bigtreetech/Manta-M8P/README.md

# [切换到中文版](./README_zh_cn.md)
# [日本語版はこちら](./README_ja_jp.md)

# Note
## We're BIGTREETECH! For Makers, by makers!
* We appreciate all of your support! To offer an excellent experience to every maker, we constantly strive to design, manufacture and produce high quality parts and documentation!
* For resources on the V1.0 and V1.1 M8P boards please consult the relevant manual available in this repo or the wiki here: https://bttwiki.com/M8P.html
* For resources on the V2.0 board, please consult the relevant manual available in this repo.

## How to contact:
### If you have any technical issue, please don’t hesitate contact us:
* BIGTREETECH: service004@biqu3d.com

### Follow us on social media to get more news:
* Facebook: https://www.facebook.com/BIGTREETECH/
* Twitter: https://twitter.com/BigTreeTech
* Instagram: https://www.instagram.com/bigtreetech_official/
* Official Site: https://bigtree-tech.com/

## Purchase link:
* M4P/M8P/CB1: https://www.biqu.equipment/collections/control-board/products/manta-m4p-m8p
