bigtreetech/Manta-M8P/V1.0_V1.1/Hardware/BIGTREETECH MANTA M8P V1.1 PinOut.png

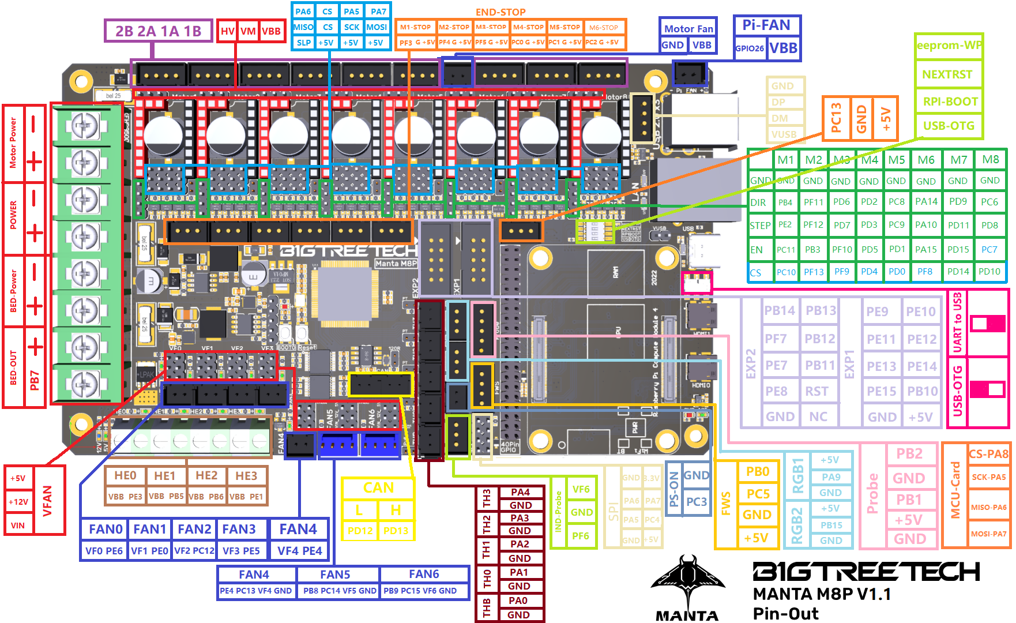
V1.0_V1.1/Hardware/BIGTREETECH MANTA M8P V1.1 PinOut.png
