bigtreetech/Manta-M8P/V2.0/Hardware/BIGTREETECH MANTA M8P V2.0 PinOut.png

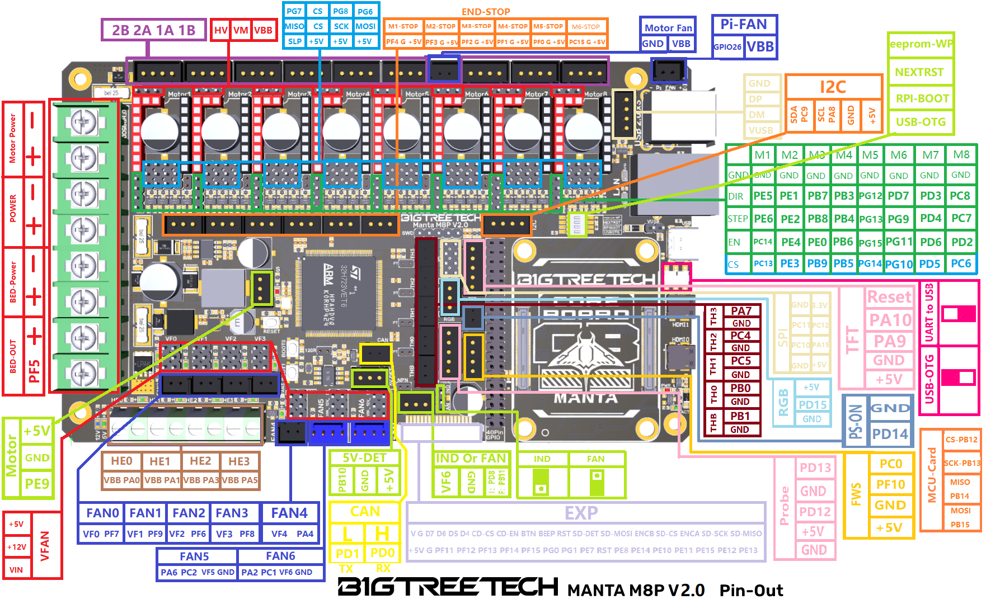
V2.0/Hardware/BIGTREETECH MANTA M8P V2.0 PinOut.png
