bigtreetech/Manta-M8P/V2.0/Hardware/M8P V2.0-connect.png

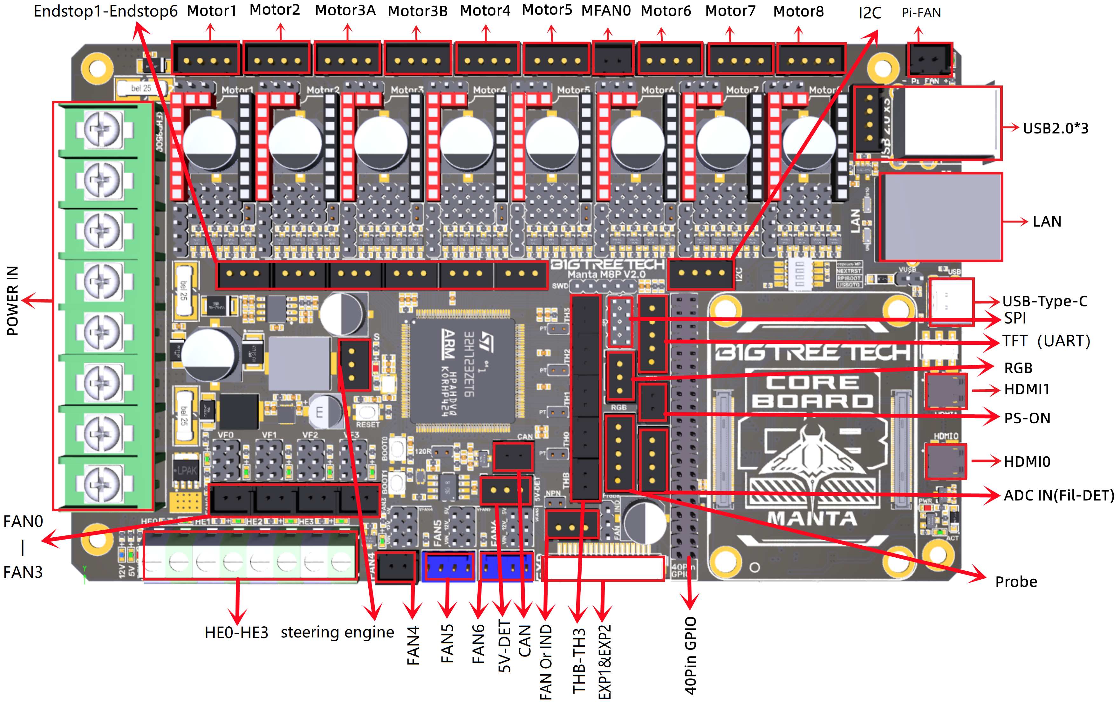
V2.0/Hardware/M8P V2.0-connect.png
