bigtreetech/Manta-M8P/V1.0_V1.1/3D/DIN Clips.STL

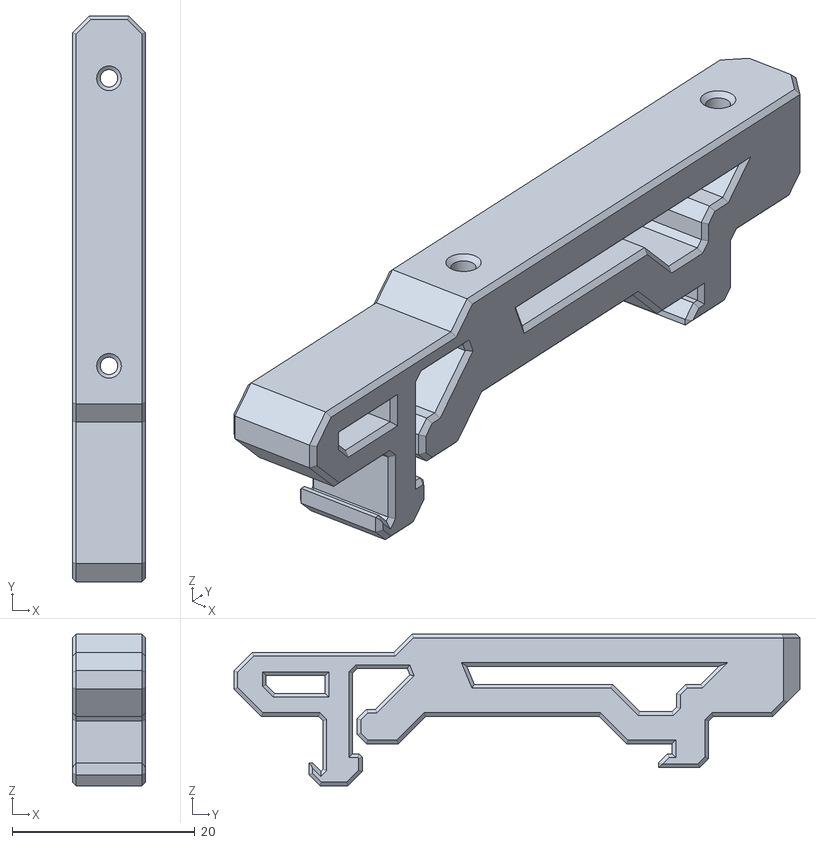
[picture p6: CAD file, 2022-07-22]
V1.0_V1.1/3D/DIN Clips.STL
8.00 x 62.0 x 16.6
