bigtreetech/Manta-M8P/(list of files, cad)

Other CAD files:
V1.0_V1.1/3D/M8P_Voron2.4_Mounting bracket.STEP
V1.0_V1.1/3D/BIGTREETECH MANTA M8P V1.0.step
V1.0_V1.1/3D/M8P_Voron2.4_Mounting bracket.STL
