bigtreetech/Manta-M8P/(threads)

Thread 1 (2022-07-31):

schematic diagram of Manta-M8P

mink007, 2022-07-31:
I am looking for schematic diagram of Manta-M8P.
Thank you.

TheRevenantStar, 2022-08-14:
Schematics are in the [manual](https://github.com/bigtreetech/Manta-M8P/blob/master/BIGTREETECH%20MANTA%20M8P%20V1.0%20User%20Manual.pdf)

Fisheiyy, 2022-09-05:
> Schematics are in the [manual](https://github.com/bigtreetech/Manta-M8P/blob/master/BIGTREETECH%20MANTA%20M8P%20V1.0%20User%20Manual.pdf)

no, they arent, thats a pinout, not a schematic

PeterHouseJr, 2022-09-10:
Is there a schematic available?

The power connections are not well explained in the preliminary manual and I would like to verify connections on the schematic before applying power.

Specifically: do I need to connect the 'Motor Power' and 'Bed Power' in addition to the 'POWER' connections.  It looks like the eight motor drivers are each jumpered to use the 'POWER' connection.  The bed power also seems to be connected to the 'POWER' connections.  If I want to power the bed separately, how much voltage and power can I use and can it me AC or do I need a separate driver for an AC powered bed heater?

A schematic should answer all of these questions.

Fisheiyy, 2022-09-12:
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

the Motor Power connection is for 48V is you want to run TMC5160 Pro/HV Drivers, they are jumpered by default to run on the 24V In from the normal POWER connection, the Bed Power connection is for 24V in so its not stressing the main POWER connection with so much current, So you need to connect the Bed Power connection if you want to use a Bed, it is DC only and up to a certain amount of current at 24V I think it is 15A, You would need an external AC Driver for an AC Bed.

PeterHouseJr, 2022-09-12:
@Fisheiyy Thank you so much for your very informative response.  On my Manta8P, the 'Bed Power In' and the 'Main Power In' are connected.  There are three small fuses on the board, each rated for 15A.  Their positioning suggest they are for the three power inputs.  I do not see a jumper anywhere to disconnect the 'Bed Power In' from the 'Main Power In'.  I am about to power up the Manta to drive some small test steppers and will post if I find anything different.

For the record: I would still like to see a schematic.

Fisheiyy, 2022-09-12:
> @Fisheiyy Thank you so much for your very informative response.  On my Manta8P, the 'Bed Power In' and the 'Main Power In' are connected.  There are three small fuses on the board, each rated for 15A.  Their positioning suggest they are for the three power inputs.  I do not see a jumper anywhere to disconnect the 'Bed Power In' from the 'Main Power In'.  I am about to power up the Manta to drive some small test steppers and will post if I find anything different.
>
> For the record: I would still like to see a schematic.

So would we all, The bed power is already seperate from the main power, you use a jumper to change the drivers from main power 24V to motor power which is meant for 48V

PeterHouseJr, 2022-09-13:
@Fisheiyy
On my board, M8P, the Bed Power and the POWER connections are connected.  I don't see an easy way to disconnect them if I wanted to, which I do not at this time.  I am thinking about an AC high power bed for quicker heating but am worried about the high voltage and the quick heating causing temperature gradients.

thisiskeithb, 2022-10-30:
Schematic has been uploaded: https://github.com/bigtreetech/Manta-M8P/blob/master/Hardware/BIGTREETECH%20MANTA%20M8P%20V1.0-SCH.pdf

emersonsc, 2022-11-23:
@mink007 could you marked this as closed to clean up the issues area. Thank you

Alex-LR, 2023-12-10:
Schematic was removed, so no schematics again!

Closed 2022-11-23.

Thread 2 (2022-08-01):

Dual Filament Runout Sensors

S1L3NTANG3L, 2022-08-01:
Is there a way to connect two SFS filament run out sensors to the board?

clevelandcs, 2022-10-21:
@S1L3NTANG3L Depends on how much other hardware you need to run. There is only the one dedicated port for their SFS sensor but if you don't need 6 motor endstops (which I'm impressed if you do) you could probably re-terminate the cable for the second SFS to use one of the endstops and just a signal pin from another end stop or other input pin you're not using elsewhere on the board. The pinout diagram in the Hardware folder should be able to put you down the right path.

emersonsc, 2022-11-23:
Really any available I/O pin can be used as @clevelandcs mention. You'll just have to remove the wires from the plug, put the 5v, GRD, and first signal pin into a 3 pin plug for the one available endstop, and the single 2nd signal pin go to the other open endstop. This how ever will ONLY work if you arent using sensorless homing on the endstops/motor your going to use for the 2nd filament sensor.

Thread 4 (2022-08-09):

CB1 Wifi

rmilyard, 2022-08-09:
So I wrote the CB1 image.

In the system.cfg file I put in my Wifi info. I did the 2.4ghz since not sure if 5 supported.  I am looking for IP and not finding it on network.  On the Manta board there is a soild RED LED near the CPU and green LED blinking near the CB1.

CTechLite, 2022-09-09:
Same here, did BTT ever get back to you?

lowtolerance, 2022-09-10:
I am also having this issue. After about 30 seconds from applying power, the “ACT” light starts blinking.

clevelandcs, 2022-10-21:
@rmilyard Have you resolved your issue? I can confirm that it will only connect to 2.4GHz networks (it even doesn't like networks support both on the same SSID) but using a dedicated 2.4GHz network and the 2.2.0 (Kernel 5.16) release from September 29th has been working fine for me with WiFi signal within margin of error when compared to my rpi 3B+ boards.

pyro159, 2023-04-21:
I ran into a similar issue and found something that worked for me. I changed the name of my wifi to a shorter/simpler name ("Gaming" in my case) and got it to connect correctly. It may have helped, but I used balanEtcher instead of Rasberry PI Imager to flash the drive. I will edit my post if I run into any anomalies

Doormat1, 2023-04-28:
The instructions in the manual dont work however this does - https://www.makeuseof.com/connect-to-wifi-with-nmcli/

sxming1010, 2024-01-31:
WIFI设置要保持和自己路由器上网WFI名称及密码一样就好，注意和marlin的设置有所区别，最容易搞错的点。

wadware, 2024-07-16:
Hi, after connecting the wifi antenna to the CB1, it logged into the network and is already working.

Thread 5 (2022-08-14):

Use with external Pi (or other system)

TheRevenantStar, 2022-08-14:
Since there are a number of users unable to use the CB1 and the CM4 is under shortage, is there a way to use the M8P with a regular Pi over USB?

I'd like to connect the Pi 4B I used in an older setup to connect to this board but I can't figure out how r if this is possible.
Please advise.

PeterHouseJr, 2022-09-19:
I would also like to use an external Pi to run the Manta 8P.  How can I get access to the STM32 serial connection?

NAPCAL, 2022-10-02:
The STMG0B1 USB interface is directly connected to the CB1/CM4 high density connector.

Iceman231173, 2022-10-23:
What does that mean?  can the board be used with external Raspberry Pi or not?

PeterHouseJr, 2022-10-23:
There is no serial port or USB port to communicate with the STM32 other than the embedded CM4 or CB1 modules.

The serial port from the STM32 microntroller is implemented through a usb port using two port pins from the STM32 directly connected to the high density connectors of the CM4/CB1 Pi module. leaving no way to connect an external Pi or other computer to the Manta8P.

I have thought about making a PCB which would plug into the CM4/CB1 location and provide a USB connector for an external connection.  Unfortunately, I cannot tell if there is any interest to sell these although I may just do it for myself.

Closed 2022-10-31.

Thread 6 (2022-08-15):

output_pin PS_on config ?

Kostt3d, 2022-08-15:
Bonjour
carte mere : manta m8p + cb1
Je rencontre un probleme avec la configuration du relay de fin d'impression. BTT relay v1.2. il s'arrete quand j'allume l'imprimante avant que le mcu ne soit chargé.
Dans le fichier printer.cfg j'ai mis les informations suivantes :

[output_pin ps_on_pin]
pin: PC3
value: 1
shutdown_value: 0

quel est la configuration pour que cela fonctionne ?

emersonsc, 2022-11-23:
https://github.com/bigtreetech/BIGTREETECH-Relay-V1.2/blob/master/BIGTREETECH%20Relay%20V1.2/BIGTREETECH%20Relay%20V1.2/Hardware/%E5%BC%80%E5%85%B3%E5%8A%A0%E6%89%93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

I know thats for a different MCU, but it should give you an idea on how to wire it correctly to function properly. Only other thing you could try is to try ^PC3 and see if that helps.

GregNuspel, 2022-12-10:
I have the same problem with my printer. The pin is configured as:
```
[output_pin PS_ON_OFF]
pin: PC3
value: 1
```
My print end code is:
```
[gcode_macro END_PRINT]
gcode:
    # Turn off bed, extruder, and fan
    M140 S0
    M104 S0
    M106 S0
    # Move nozzle away from print while retracting
    G91
    G1 X-2 Y-2 E-3 F300
    # Raise nozzle by 10mm
    G1 Z10 F3000
    G90
    G1 X10 Y330 F1000
    # Disable steppers
    M84
    G90 ; absolute positioning
    TEMPERATURE_WAIT sensor=extruder maximum=60
    SET_PIN PIN=PS_ON_OFF VALUE=0; shut down the printer
```

The board boots too slow for the 15 second time delay of the relay board. I have tested the relays actions for the end of print and it works as predicted. I need to know if there is a way to make PC3 go high before Klipper loads or is there a way to lengthen the 15 second delay on the relay board?

jariddler, 2023-04-17:
When building the firmware if you set pin pc3 high on startup it will fix the issues with the relay board

GregNuspel, 2023-05-06:
I tried to enter this in menuconfig : `set_digital_out pin=PC3 value=1`

When I ran make I had the following error: Unknown initial pin `set_digital_out pin=PC3 value=1`

Is there a different pin callout on the microprocessor level?

jariddler, 2023-05-06:
Just put the pin. Pc3 nothing else

Kostt3d, 2023-05-10:
Hy everybody
i switched my motherboard for a M4P and this setup work perfectly
[output_pin ps_on_pin]
pin: PD1
#   The pin to configure as an output. This parameter must be
#   provided.
#pwm: False
#   Set if the output pin should be capable of pulse-width-modulation.
#   If this is true, the value fields should be between 0 and 1; if it
#   is false the value fields should be either 0 or 1. The default is
#   False.
#static_value:
#   If this is set, then the pin is assigned to this value at startup
#   and the pin can not be changed during runtime. A static pin uses
#   slightly less ram in the micro-controller. The default is to use
#   runtime configuration of pins.
value:1
#   The value to initially set the pin to during MCU configuration.
#   The default is 0 (for low voltage).
shutdown_value : 1

ajaytanna, 2024-05-12:
> Just put the pin. Pc3 nothing else
As in attached picture?
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

Closed 2023-07-21.

Thread 7 (2022-08-19):

Pinout / Pin numers for Klipper

heideict, 2022-08-19:
I would like to have an overview of the Pin Numbers for the M8P board.
Some are in de manual, But others are missing (Uarts for example)
Some I could retrieve from the examples CFG files. but not all.

emersonsc, 2022-11-23:
> I would like to have an overview of the Pin Numbers for the M8P board. Some are in de manual, But others are missing (Uarts for example) Some I could retrieve from the example .cfg files. but not all.

https://github.com/bigtreetech/Manta-M8P/blob/master/Hardware/BIGTREETECH%20MANTA%20M8P%20V1.0%20PinOut.png
https://github.com/bigtreetech/Manta-M8P/blob/master/Hardware/BIGTREETECH%20MANTA%20M8P%20V1.0-SCH.pdf

Thread 8 (2022-08-24):

Manual, page 12; Section 3.2.5 only showing one position for the stepper diver voltage selection jumper.

NAPCAL, 2022-08-24:
Missing descriptions for Motor & Main power on each jumper diagram.
Also, both photos show the same position to the right.
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

Newbies are having problems and possibly could damage the Manta and their drivers.

And the pinout adds to this confusion since the power inputs don't have the same labels.
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

Recommend updating the Manual & Pinout.
Manual sample change:
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

Pinout sample change:
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

Snoman002, 2023-01-07:
Issue still remains.

Of note, the BIQU support page for the m8p still lists the very old version of the manual and does not even have this section.

https://support.biqu3d.com/hc/en-us/articles/8137042389145-MANTA-M4P-M8P-Manual

Thread 9 (2022-08-25):

SPI1 communication

stcs1981, 2022-08-25:
Hello, I have "Global scaler" communication problems with various brands of TMC5160 drivers. In the examples, there are some pins in the table, there are others. I have tried several combinations and there is no way!
This is the configuration

## X Stepper on Motor1(B Motor)
[stepper_x]
step_pin: PE2
dir_pin: !PB4
enable_pin: !PC11
endstop_pin: sht42:^PA0
rotation_distance: 32
microsteps:16       
full_steps_per_rotation: 200
position_endstop:-11.5
position_max: 310    
position_min: -11.5     
homing_speed: 100    
homing_retract_dist: 5
homing_positive_dir: false

[tmc5160 stepper_x]     
cs_pin: PC10
spi_bus: spi1
#spi_software_sclk_pin: PA5
#spi_software_mosi_pin: PA7
#spi_software_miso_pin: PA6
interpolate: True
run_current: 2
#stealthchop_threshold: 0
#sense_resistor: 0.075

Thanks in advance!!!

GregNuspel, 2022-11-11:
I'm having similar problems with the TMC2130 SPI config.

stcs1981, 2022-11-11:
Hello dear friend this is my configuration!!!
Enviado desde Correo<https://go.microsoft.com/fwlink/?LinkId=550986> para Windows

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

GregNuspel, 2022-11-11:
The link isn't working for me. Can you post your config here.
Thanks

stcs1981, 2022-11-11:
[stepper_x]

step_pin: PE2

dir_pin: PB4

enable_pin: !PC11

microsteps: 16

rotation_distance: 32

#endstop_pin: ^PF3

full_steps_per_rotation: 200

position_endstop: -5

position_min: -5

position_max: 310

homing_speed: 150

homing_retract_dist: 5

[tmc5160 stepper_x]

cs_pin: PC10

spi_software_sclk_pin: PA5

spi_software_mosi_pin: PA7

spi_software_miso_pin: PA6

run_current: 2

Enviado desde mi iPhone

El 11 nov 2022, a las 21:10, GregNuspel ***@***.***> escribió:

The link isn't working for me. Can you post your config here.
Thanks

—
Reply to this email directly, view it on GitHub<https://github.com/bigtreetech/Manta-M8P/issues/9#issuecomment-1312155329>, or unsubscribe<https://github.com/notifications/unsubscribe-auth/AHNKOI6AJPCXF66IKSLPX2LWH2R4PANCNFSM57S4OWEQ>.
You are receiving this because you authored the thread.Message ID: ***@***.***>

GregNuspel, 2022-11-11:
Thanks I hadn't put in the software spi info.

stcs1981, 2022-11-11:
I went crazy and in the end this was the only way to make spi bus work!! Greetings and I hope I have helped you fellow sufferer!!!!

Enviado desde Correo<https://go.microsoft.com/fwlink/?LinkId=550986> para Windows

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

emersonsc, 2022-11-22:
Can confirm this issue as well. Simply providing the "cs" pin and the spi bus will not work. You MUST specify each pin, not just the CS pin in order to use drivers in spi mode.

spi_software_sclk_pin: PA5
spi_software_mosi_pin: PA7
spi_software_miso_pin: PA6

InBlainSight, 2023-04-03:
I also had the problem and switching over to motor power did the fix. For some reason regular board power didn't work. I used another psu but I don't think that matters. Global scaler was the issue as well. I even used the same voltage as the board power

stcs1981, 2023-04-03:
It's solved!!! For a while now if you want I can send you the configuration when I get home later

Enviado desde mi iPhone

El 3 abr 2023, a las 17:13, InBlainSight ***@***.***> escribió:

I also had the problem and switching over to motor power did the fix. For some reason regular board power didn't work. I used another psu but I don't think that matters. Global scaler was the issue as well. I even used the same voltage as the board power

—
Reply to this email directly, view it on GitHub<https://github.com/bigtreetech/Manta-M8P/issues/9#issuecomment-1494512894>, or unsubscribe<https://github.com/notifications/unsubscribe-auth/AHNKOI7QXVS4UZMEOCJGC23W7LSKFANCNFSM57S4OWEQ>.
You are receiving this because you authored the thread.Message ID: ***@***.***>

stcs1981, 2023-04-03:
It's solved!!! For a while now if you want I can send you the configuration when I get home later

Enviado desde mi iPhone

El 3 abr 2023, a las 17:13, InBlainSight ***@***.***> escribió:

I also had the problem and switching over to motor power did the fix. For some reason regular board power didn't work. I used another psu but I don't think that matters. Global scaler was the issue as well. I even used the same voltage as the board power

—
Reply to this email directly, view it on GitHub<https://github.com/bigtreetech/Manta-M8P/issues/9#issuecomment-1494512894>, or unsubscribe<https://github.com/notifications/unsubscribe-auth/AHNKOI7QXVS4UZMEOCJGC23W7LSKFANCNFSM57S4OWEQ>.
You are receiving this because you authored the thread.Message ID: ***@***.***>

stcs1981, 2023-04-04:
[stepper_x]
step_pin: PE2
dir_pin: PB4
enable_pin: !PC11
microsteps: 16
rotation_distance: 32
#ndstop_pin: ^PF3
full_steps_per_rotation: 200
position_endstop: 0
position_min: 0
position_max: 346
homing_speed: 200
homing_retract_dist: 5

[tmc5160 stepper_x]
cs_pin: PC10
spi_software_sclk_pin: PA5
spi_software_mosi_pin: PA7
spi_software_miso_pin: PA6
run_current: 2

Enviado desde Correo<https://go.microsoft.com/fwlink/?LinkId=550986> para Windows

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

tstone, 2023-05-13:
For anyone who finds this issue in the future, I verified this does work with the M8P V1.1 as well.

NOTE: Because of the way the SPI bus works, all drivers using SPI must be configured as mentioned above with the 3 pins. The problem will persist if even just 1 of the drivers is still using `spi_bus`.

kymlalu, 2024-06-19:
> For anyone who finds this issue in the future, I verified this does work with the M8P V1.1 as well.
>
> NOTE: Because of the way the SPI bus works, all drivers using SPI must be configured as mentioned above with the 3 pins. The problem will persist if even just 1 of the drivers is still using `spi_bus`.

For M8P V1.1 HW SPI works but you have to specified spi bus speed, default one is too fast. I started somwhere on low side and tried to go up until i got error.
M8P V2 hoewer does't have correct pin's for HW SPI so SW SPI is the only options. ( Pins PG6,7,8 of STM32H7xx doesn't have SPI function, why someone designed it in this way is mystery to me )

PeterXQC, 2024-09-21:
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

Can you elaborate on how you configured it for M8P V2? I am doing

[tmc5160 stepper_x]
cs_pin: PE3
spi_software_sclk_pin: PC10
spi_software_mosi_pin: PC12
spi_software_miso_pin: PC11
run_current: 2

This is giving me error. I think the pins are correct but I'm not super sure. I also have EBB 36 can with another use of spi bus:

heater_pin: EBBCan: PB13
sensor_type: MAX31865
sensor_pin: EBBCan: PA4
spi_software_sclk_pin: EBBCan:PA5
spi_software_mosi_pin: EBBCan:PA7
spi_software_miso_pin: EBBCan:PA6
rtd_nominal_r: 1000
rtd_reference_r: 4300
rtd_num_of_wires: 2
min_temp: 0
max_temp: 350

Would this mess with the stepper drivers' spi config?

Thread 10 (2022-08-27):

Dual Motor2 or Motor3? Unclear

IonCaza, 2022-08-27:
Manual (page 6) point 17. references `Motor Drive Interface: Motor1, Motor2(dual motor interface), Motor3, ...` however, schematic and board have "M1", "M2", "M3A" and "M3B". So which one is dual motor? Motor 2 or Motor 3?

basha318i, 2022-09-03:
Motor 3; since it says M3A & M3B.

IonCaza, 2022-09-03:
> Motor 3; since it says M3A & M3B.

Lol you seem to be very confident of the engravings / schematics pictures... all the other literature (including manual) has references to 'Motor 2 (dual motor)'

clevelandcs, 2022-10-21:
@IonCaza I don't know if they changed it at some point but when I got my boards a few weeks ago the manual matches the schematics in the hardware directory. Also in my adventure in wiring and rewiring a number of times I can confirm from experience that it is Motor 3 that is the dual motor outputs.

Okamimann, 2023-05-28:
It's a typo in the Introduction section. I have a Manta M8P v1.1, and that specific point you mention has been updated to say Motor1, Motor2, Motor 3(dual motor interface) ... but the truth is, that technically doesn't matter. You can SEE where the dual plug is on the board (next to the 3rd slot for stepper drivers), and you can look at both the Interface Diagram (page 7 on the 1.0 manual, page 10 on the 1.1 manual) and the the Pin-Out diagram (page 8 on the 1.0 manual, page 10 on the 1.1 manual for the 1.0 board and page 11 on the 1.1 manual for the 1.1 board). Just make sure you get the correct pins in the correct settings locations, and you're fine.

For what it's worth, another way to look at it would have been to realize that just about every manufacturer that I know of, if they put the plugs for the motors in a row, the expected behavior is X, Y, Z, Z1, E. The "default" (but commented out) settings for motors 6, 7, and 8 are all for extruders as well (4 extruders?! What, are you creating your own Palette machine? On second thought ... that might be useful actually). But all of the motors can be switched around or used for other purposes, you just have to make sure you put the correct pins in the correct section. Accidentally plugged the X motor into the Y slot and vice versa, and now the board is in a difficult location so you don't want to tear everything apart just to fix the wires? Simply swap the pins in the printer.cfg settings file and you're good to go.

Thread 11 (2022-09-07):

Documentation Fan port/RGB ratings

wizhippo, 2022-09-07:
The documentation says

12. The maximum output current of the fan port: 1A, Peak Value: 1.5A

Is this per fan port or in total?

Also for the RGB +5v.  What is it rating so we know how many leds we can drive?

Exo7, 2023-03-01:
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

as i can see on the schematic ;
Each FAN voltage output is protected by a 1A fuse. so i mean it's 1A by Fan Output.
For the RBG, the 5V line is protected by a 3.6A electronic fuse.
but this line is shared with many other functions on board like logic, endstops, servo, probe, filament sensor, etc.. this is the main 5V line.
i recommend to use external 5V power supply if you are looking to power daylight or chamber lighting, to keep safe the board in case of problem as there is no fuse between main 5V line and each outputs.

Closed 2023-03-01.

Thread 12 (2022-09-12):

CB1 Camera DSI support

ils15, 2022-09-12:
CB1 didnt support a dsi camera/display?
Only HDMI?
Why?

NAPCAL, 2022-10-02:
More than likely to keep the cost down and the availability of components to build the CB1.

emersonsc, 2022-11-23:
@ils15 could you mark this as closed please? This isnt a Manta M8P issue, and the CB1 was advertised as not having DSI support from the beginning. Thank you!

Jafterdark, 2023-02-12:
i have cb4 and can't get display with btt pi tft50 working

Thread 13 (2022-09-25):

Using an external USB-connected Pi

lowtolerance, 2022-09-25:
I know the Manta is built to accept a Raspberry Pi CM 4 module, but is it possible to use a Pi connected to the Manta by USB instead of using the CM4 or CB1 modules? I can’t get my hands on a CM4 module and the CB1 module I received has major issues that I’m trying to get that sorted out through BTT’s customer support.

I tried the obvious of hooking up to the Manta’s USB-C port, but it’s not being recognized as a serial device. Is the USB-C just for flashing the MCU in DFU mode?

NAPCAL, 2022-10-02:
The USB-C is only connected to the CB1/CM4 high density connector.

The STM32G0B1 USB connection is directly connected to the USB hub chip for the CB1/CM4.

Fisheiyy, 2022-10-17:
> The USB-C is only connected to the CB1/CM4 high density connector.
>
> The STM32G0B1 USB connection is directly connected to the USB hub chip for the CB1/CM4.

and where are you getting this information? there is no schematic so therefore no way to really know

NAPCAL, 2022-10-17:
If you load Klipper onto the M8P/M4P, you will never see the M8P/M4P on the USB-C port; you will from the CB1/CM4.

Typically an RPi has four USB ports; the M8P/M4P has two plus a USB header behind the two USB ports. This leaves one that you always see the M8P/M4P on when doing a lsusb on the CB1/CM4, also displayed are the physical connection numbers 1-4, the M8P/M4P will always be on the same physical connection.

Iceman231173, 2022-10-23:
What does that mean?  can the board be used with external Raspberry Pi or not?

NAPCAL, 2022-10-23:
Without using a CB1/CM4 first to set up the M8P firmware for UART, the M8P USB option can not be accessed since it is hardwired to the CB1/CM4 high density connector with no external connections.

Fisheiyy, 2022-10-23:
> What does that mean? can the board be used with external Raspberry Pi or not?

you have to use the display pins or some extra motor driver pins and set the firmware to use UART then you can connect the pi to manta, your probably better off buying a cm4 or cb1

NAPCAL, 2022-10-23:
> > What does that mean? can the board be used with external Raspberry Pi or not?
>
> you have to use the display pins or some extra motor driver pins and set the firmware to use UART then you can connect the pi to manta, your probably better off buying a cm4 or cb1

That is basically the idea, the board wasn't designed to be used without a CB1/CM4. To be able to currently fully use the GPIO, Camera, DSI you would need to use a CM4.

non-bin, 2025-05-27:
Is this still the case for the v1.1?

Thread 14 (2022-09-26):

MCU don't go into reset state after Linux host was shutdown

FranzPVal, 2022-09-26:
I have a strange behavior using a M8P equipped with a CB1 and the latest 2.1.2 image.

If I shutdown the host - for example using Mainsail UI "Host Control" -> "shutdown" the STM32G0 kept all steppers, fans, heaters in the current state. There was no MCU reset or whatever. After a night long the steppers and fans (not only the hotend fan) was active. So I test this: The MCU don't go into a reset or shutdown-state at all. I don't find any general information about this.

aodxxl, 2022-11-10:
I can confirm this behaviour on 2.2.1 . Shutdown hurakan and steppers remain active.

emersonsc, 2022-11-23:
Can confirm with 2.2.1 minimal as well

Thread 16 (2022-10-01):

Senseless home diag pin

Mohmedhat, 2022-10-01:
has anyone the pinout names for the DIAG pins Motor1 and Motor2 MANTA M8P board?

NAPCAL, 2022-10-02:
They will be the same as the endstop for that motor driver.

aodxxl, 2022-11-10:
use the config example for the voron. I am using this board for a voron with sensorless homing.

Thread 17 (2022-10-30):

cannot access '/dev/serial/by-id': No such file or directory

hippieua, 2022-10-30:
release [V2.2.0](https://github.com/bigtreetech/CB1/releases/tag/V2.2.0)

[Hurakan_Debian11_Mainsail_kernel5.16_20220929.img.xz](https://github.com/bigtreetech/CB1/releases/download/V2.2.0/Hurakan_Debian11_Mainsail_kernel5.16_20220929.img.xz)

manta m8p board with CB1 module

biqu@BTT-CB1:~/klipper$ ls /dev/serial/by-id
ls: cannot access '/dev/serial/by-id': No such file or directory

biqu@BTT-CB1:~/klipper$ uname -a
Linux BTT-CB1 5.16.17-sun50iw9 #2.2.0 SMP Wed Sep 28 15:50:52 HKT 2022 aarch64 GNU/Linux

hippieua, 2022-10-30:
bad connection CB1 to Manta M8P board. Just push it harder )

wodier12, 2023-10-21:
what does "just push it harder mean?"

hippieua, 2023-10-21:
> what does "just push it harder mean?"

laterally, just i just pushed cb1 harder to m8p until here it clicks in socket

wodier12, 2023-10-21:
hmmmmm

Sent from Mail<https://go.microsoft.com/fwlink/?LinkId=550986> for Windows

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

wodier12, 2023-11-02:
" just push it harder " does not work, but thanks for trying...

Closed 2022-10-30.

Thread 18 (2022-11-12):

Unable to flash firmware

airbornetrooper82573, 2022-11-12:
I've tried via SD card and it never changes firmware.bin to cue. I have flashed this board once but I am getting some errors and attempting to flash again. Getting the following errors:

```
usb-Klipper_stm32g0b1xx_3E0009000A504B4633373520-if00
biqu@BTT-CB1:~/klipper$ make flash FLASH_DEVICE=/dev/serial/by-id/usb-Klipper_stm32g0b1xx_3E0009000A504B4633373520-if00
  Flashing out/klipper.bin to /dev/serial/by-id/usb-Klipper_stm32g0b1xx_3E0009000A504B4633373520-if00
Entering bootloader on /dev/serial/by-id/usb-Klipper_stm32g0b1xx_3E0009000A504B4633373520-if00
Device reconnect on /sys/devices/platform/soc/5200000.usb/usb2/2-1/2-1.4/2-1.4:1.0
sudo dfu-util -p 2-1.4 -R -a 0 -s 0x8002000:leave -D out/klipper.bin

dfu-util 0.9

Copyright 2005-2009 Weston Schmidt, Harald Welte and OpenMoko Inc.
Copyright 2010-2016 Tormod Volden and Stefan Schmidt
This program is Free Software and has ABSOLUTELY NO WARRANTY
Please report bugs to http://sourceforge.net/p/dfu-util/tickets/

dfu-util: Invalid DFU suffix signature
dfu-util: A valid DFU suffix will be required in a future dfu-util release!!!
Opening DFU capable USB device...
ID 0483:df11
Run-time device DFU version 011a
Claiming USB DFU Interface...
Setting Alternate Setting #0 ...
Determining device status: state = dfuIDLE, status = 0
dfuIDLE, continuing
DFU mode device DFU version 011a
Device returned transfer size 1024
DfuSe interface name: "Internal Flash   "
Downloading to address = 0x08002000, size = 26644
Download        [=========================] 100%        26644 bytes
Download done.
File downloaded successfully
dfu-util: Error during download get_status

Failed to flash to /dev/serial/by-id/usb-Klipper_stm32g0b1xx_3E0009000A504B4633373520-if00: Error running dfu-util

If the device is already in bootloader mode it can be flashed with the
following command:
  make flash FLASH_DEVICE=0483:df11
  OR
  make flash FLASH_DEVICE=1209:beba

If attempting to flash via 3.3V serial, then use:
  make serialflash FLASH_DEVICE=/dev/serial/by-id/usb-Klipper_stm32g0b1xx_3E0009000A504B4633373520-if00

make: *** [src/stm32/Makefile:90: flash] Error 255
```

Board is connected to 24v power supply on my Voron 2.4

airbornetrooper82573, 2022-11-12:
Disregard the Make Flash error... I see at the very bottom of page 37 it says to disregard the error. I am still unable to flash with SD card but I guess it is fine.

NiLMoXiE, 2022-11-13:
I am having trouble flashing my M8P via SD card - it just doesn't work - I cant do it by USB either as I can't get my board ID, any tips or hints?

airbornetrooper82573, 2022-11-13:
When I did mine originally I had the jumper set and powered via usb. If you can get into Mainsail/Fluidd you should pull the ID like the guide says.

NiLMoXiE, 2022-11-13:
Thanks man, I have just realised there are 2 SD card slots, I was using the wrong one.

Closed 2022-11-19.

Thread 19 (2022-11-15):

DSI and CSI Connection

Alvin5311, 2022-11-15:
I have the CM4 (8Gb RAM, 8Gb eMMC) on my M8P board and I've connected the BTT Pi TFT50 v2.0 and the Picam 8MP v2.0 to the DSI and CSI FPC on the bottom of the board and got no display and picture. Need help to troubleshoot.

Thanks.

Alvin5311, 2022-11-19:
Nevermind, the type B FFC ribbon cable doesn't work for the M8P board with the Pi TFT50 v2.0 display, I had to swap it with a type A ribbon cable.

aywosh, 2022-11-21:
Hi Alvin5311, did you find a solution because you closed the issue? I have the same issue. Thanks.

TheLexus, 2023-11-15:
@Alvin5311 Im to try to use the M8P with a DSI 5" display which worked with a pi without problems before. But im a bit lost on how to use the dsi connector on the underside of the board... I cannot get the cable in it. What do I maybe wrong? Can you give me a hint from which side the cable plugs in... I tried it from both sides but it fits only from the "outside" where the screw hole is... but the display is not recognised by linux seen from the dmesg. It even does not light up, so I guess I made something wrong.

TheLexus, 2023-11-19:
Ok, was able to fix it up. In the end the cable connectors were problematic. be sure that you really insert them as much as possible. On the Manta the pins need to face up (so that you see the silver plates). Verify that you use a Type-B cable which has the contacts on both ends at the same side. I used the fkms overlay instead of the kms one and no additional one for the screen. But my screen isn't from waveshare, so maybe yours different.

Closed 2022-11-19.

Thread 21 (2022-11-23):

Probe Config Issue (B1 SE Plus Conversion)

mario54bro, 2022-11-23:
I'm working on trying to configure the probe on the B1 SE Plus on the Manta M8P board. The blue (and Green) light on the FX712 board flashes randomly. This is trigging the Z Endstop before it reaches the bed.

I used the Example setup from the B1 SE Plus and here is what I have for the config.

[probe]
pin: ^!PB1
z_offset: 0.0
x_offset: 0.0
y_offset: 0.0
speed: 10.0
samples: 2
samples_result: average
sample_retract_dist: 2.0
samples_tolerance: 0.2

[output_pin probe_enable]
pin: PB2
value: 1

emersonsc, 2022-11-23:
have you tried putting the pullup on the output pin, ex pin: ^PB2?

You should go to the machine tab in Mainsail, then scroll down and you can query the probes. Keep in mind its not real-time, and has to be refreshed every time you want to check them. Its a useful tool when getting the settings right for your endstops and probes.

mario54bro, 2022-11-23:
I have tried this, it causes this Error
Invalid pin description '^PB2'
Format is: [!] [chip_name:] pin_name

However, when this error is triggered, the light doesn't blink..

emersonsc, 2022-11-23:
> I have tried this, it causes this Error Invalid pin description '^PB2' Format is: [!] [chip_name:] pin_name
>
> However, when this error is triggered, the light doesn't blink..

How about just ! OR changing the 1 to 0?

mario54bro, 2022-11-23:
Tried all those combinations with no luck.

mario54bro, 2022-11-24:
I have found that plugging the probe 5v and ground into a different supply source (not on the board) resolves the issue. Any idea why this would be?

emersonsc, 2022-11-24:
> I have found that plugging the probe 5v and ground into a different supply source (not on the board) resolves the issue. Any idea why this would be?

Have you tried another 5v pin on the board?

mario54bro, 2022-11-24:
> > I have found that plugging the probe 5v and ground into a different supply source (not on the board) resolves the issue. Any idea why this would be?
>
> Have you tried another 5v pin on the board?

Yes, tried multiple other 5v pins on board with no luck.

Thread 22 (2022-11-24):

BTT Mini 12864 doesn't work

Bill-Dung, 2022-11-24:
The Neopixel of the 12864 Mini are working fine but the screen itself stays blank. I have used the following Pins:

[board_pins]
aliases:
    # EXP1 header
    EXP1_1=PE9, EXP1_2=PE10,
    EXP1_3=PE11, EXP1_4=PE12,
    EXP1_5=PE13, EXP1_6=PE14,    # Slot in the socket on this side
    EXP1_7=PE15, EXP1_8=PB10,
    EXP1_9=<GND>, EXP1_10=<5V>,

    # EXP2 header
    EXP2_1=PB14, EXP2_2=PB13,
    EXP2_3=PF7, EXP2_4=PB12,
    EXP2_5=PE7, EXP2_6=PB11,      # Slot in the socket on this side
    EXP2_7=PE8, EXP2_8=<RST>,
    EXP2_9=<GND>, EXP2_10=<NC>

and those klipper config entries:

[display]
lcd_type: uc1701
cs_pin: EXP1_3
a0_pin: EXP1_4
rst_pin: EXP1_5
contrast: 63
encoder_pins: ^EXP2_5, ^EXP2_3
click_pin: ^!EXP1_2

[output_pin beeper]
pin: EXP1_1

[neopixel fysetc_mini12864]
pin: EXP1_6
chain_count: 3
color_order: RGB
initial_RED: 0.05
initial_GREEN: 0.5
initial_BLUE: 0.5

The display is working fine at a Manta M4p but not at the M8P. I tried different cable in different directions of the plugs, no way.

turpinator, 2022-11-26:
It looks like you havent defined the SPI pins
`spi_software_miso_pin: EXP2_1
spi_software_mosi_pin: EXP2_6
spi_software_sclk_pin: EXP2_2`

Bill-Dung, 2022-11-30:
That's it, thanks. I would never have thought of it, since the same display runs on the M4P without these lines. Doesn't matter, the main thing is that it works now. Thx again.

Closed 2022-11-30.

Thread 23 (2022-11-28):

No power to CB1

airbornetrooper82573, 2022-11-28:
Board has been working fine. I disconnected power and did some wire management. Everything plugged in where it has been but now I'm not getting any power to the CB1. Any troubleshooting steps I can do? This is my 2nd board as the first one was faulty. Trying to avoid doing another board and CB1 swap as at this point I could just bought a different board and a PI4 with how much I've spent.

Closed 2022-11-28.

Thread 24 (2022-12-01):

Inside holes deformed

Duraprinter, 2022-12-01:
Been printing my old models, every single one of them got all inside holes deformed down, Been using .6 nozzle and every hole got 1.6mm smaller.

Thread 25 (2022-12-13):

No serial connection between MCU and CB1

Lzingano, 2022-12-13:
Hello all, I am also writing it here, together with Reddit.

I just received my Manta M8P and CB1, but am experiencing a bit of an issue here.

- I installed the release V2.2.1 image from [here](https://github.com/bigtreetech/CB1/releases) to the CB1 and all went pretty well.
- I used BTT's instructions to compile the firmware for the MCU and it also seems to have worked (and I double checked the klipper configuration to build the .bin).
- I have tried powering the board using the USB-C with the VUSB jumper on, as well as with 24V PSU and no VUSB jumper. The difference I saw is that LEDs get lit a little bit brighter with 24v, but that's it.
- SD cards are also in the correct position.
- I have updated all the CB1 software before building the .bin. The MCU seems to be flashing correctly.
- Also, I can connect to the CB1 without any issues via LAN or Wifi, which I use to SSH into it. The Webapp works as well.
- ACT light flashed, CB1 LED is lit and

What I can not have working is the serial connection between both MCU and CB1. It looks like an issue with the USB somewhere in the chain. The USB chip is not overheating or anything, but when I connect a flash drive to any USB port, it isn't recognized.
Does anyone have a clue what could be happening? I fear that I might have a deffective usb hub chip somehow, which would be pretty bad.
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

Any help is appreciated =)

TIA

jeronbernal, 2022-12-27:
waiting for a solution to this aswell

Lzingano, 2023-01-01:
I am in contact with BTT, but they have so far not given any solution. I will this week make a warranty claim, because the board is probably toast.

jfneptune, 2023-01-06:
Did you ever find out what the issue was?  Was it the board being toast or something else?

jeronbernal, 2023-01-06:
I ended up reinstalling mainsail and klipper doing a fresh install and it
started working again

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

jfneptune, 2023-01-06:
How did you reinstall everything?  Did you reformat the microsd card and follow the instructions in the BTT manual or install some other way?

Lzingano, 2023-01-06:
I am also interested in this. I haven't found a solution yet. At this moment, I requested to return the card and will probably get a new one after this and hope it works. They are probably shipping the rev 1.1 right now (SKU changed).

evplasmaman, 2023-01-17:
I'm also seeing this issue. I just got my V1.1 MP8 board with a CM1 but no luck with the serial connections on 2.2.1. I've even tried going down to the 2.1.2 image to see if that makes any difference but no luck.

Can anyone else confirm that their MCU LED is not active after flashing the firmware generated by klipper? I only see it blink when I try to load a new MCU firmware or if I reset the chip. Not sure if that is a cause or a symptom of the serial issue.

I might try to see if I can follow in @jeronbernal 's footsteps but I'm new to klipper and not quite sure where to begin with doing a fresh install.

emersonsc, 2023-01-23:
When you compile the firmware for the board, are you choosing USB or serial connection? The M8P & CM1 uses the USB connection option.

evplasmaman, 2023-01-23:
Yes for communication interface I selected (USB (on PA11/PA12))

I've done some more digging in to the issue and it looks like the FE1.1s chip is only outputting 0.9V from its internal voltage regulator when it's supposed to be 3.3V. Applying 3.3V from another current limited source (which the chips data sheet says you are allowed to do) makes all the USB devices show up and the board work normally.

I'm not sure if this is due to the chip having a bad internal voltage regulator or of this stems from an issue on the new V1.1 boards. I contacted BTT yesterday and will see what they say.

If someone feels brave enough to test their board for the same issue and they have a fine enough probes for their multi meter here is where I checked the voltage supply with the ground connected to one of the supply GND pin on the other side of the board.
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

Johnnyyr, 2023-02-02:
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

I think i have the same issue with manta m5p and cb 1 2.2.1

evplasmaman, 2023-02-03:
> When you compile the firmware for the board, are you choosing USB or serial connection? The M8P & CM1 uses the USB connection option.

I am compiling with the USB option.

evplasmaman, 2023-02-03:
> 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
>
> I think i have the same issue with manta m5p and cb 1 2.2.1

Could you try plugging in another USB device and seeing if it shows up in lsusb? With the issue I had I was only able to see the Linux Foundation devices.

Johnnyyr, 2023-02-03:
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

No i can´t but the CB1 is onboard of the m5p. I have flashed the m5p normally without can jeztztz I see it. Unfortunately I do not know how to flash it correctly for Can.

adjustinthings, 2023-02-04:
https://github.com/bigtreetech/CB1#v221-os-setting

bddanford, 2023-02-21:
Swapped out my RP4B for a CB1/PI4 adapter and I cant see any of my USB services. LSUSB shows just the hubs and nothing else, not the camera or the SKR 1.4. I wanted to play around with the CB1 and put the RP4B in my Voron 2.4, which has a RP3b+ in it now.

Anyone figure this out? I am powering the CB1/RP4 board with a 5v meanwell PSU connectioned to the 5v and ground on the GPIO pins.

jeronbernal, 2023-02-22:
did you enable usb hub via the commands in the manual?

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

bddanford, 2023-02-22:
You only do that if you want the USB C port to actually be a USB port and not just a power port. I ended up reseating the CB1 and everything showed up just fine. Must not have been seated correctly.

sbuchana, 2023-03-02:
I was pulling my hair out over what might be the same issue. My issues disappeared as soon as I disconnected my mini 12864 display. It turns out that Fysetc wires their display connectors reverse of Biqu. I found this reference that talked about rotating the PS1/PS2 connectors. Solved my issue at least.

https://docs.vorondesign.com/build/electrical/mini12864_klipper_guide.html

Lzingano, 2023-03-02:
So, to give a feedback on my side. I had the board replaced by BIQU. They sent me a Manta M8P V1.1 and it works like a charm with the same CB1. I had the issue that was pointed out [here](https://github.com/bigtreetech/Manta-M8P/issues/25#issuecomment-1400974408). I am not sure what the problem was, but seems like it was a bad board. Maybe if someone is having this same issue, I suggest getting in touch with BIQU. They are willing to help =)

Lazybones2319, 2023-04-27:
I'm having a similar issue with my m8p v1.1 it seems to boot everything but there is no power led near the hdmi ports the photo is after 20 ish minutes trying to boot.  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

punjabik, 2023-05-22:
> I was pulling my hair out over what might be the same issue. My issues disappeared as soon as I disconnected my mini 12864 display. It turns out that Fysetc wires their display connectors reverse of Biqu. I found this reference that talked about rotating the PS1/PS2 connectors. Solved my issue at least.
>
> https://docs.vorondesign.com/build/electrical/mini12864_klipper_guide.html

So much thank you for this. You saved me a lot of time. I was unable to get firmware to the manta and it was because fysetc connected display.

keamer, 2023-05-30:
@Lazybones2319 --
Not sure, but did you ever switch back the DIP switches? They switches 3 and 4 seem to be on.

From the manual, page 28:
> 5. When the writing is completed, push the DIP switch 4 (USB OTG) and 3 (RPIBOOT) back to OFF after power off, and power on again to enter the normal working mode.

Arcanengineer, 2023-07-06:
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

Lazybones2319, 2023-07-06:
@keamer

It turns out my issue was a bad sd card.
I posted this then thought hey I have a spare card I'll flash it with that.
Low and behold the thing started working and has around 2000 hours run time so far

Arcanengineer, 2023-07-06:
> @keamer
>
> It turns out my issue was a bad sd card. I posted this then thought hey I have a spare card I'll flash it with that. Low and behold the thing started working and has around 2000 hours run time so far

Not for me

Arcanengineer, 2023-07-06:
Guys... I got my problem solved. For some weird reason, when i pulled the cables of my adxl345 off the board, the serial connection instantly became available.
So, everyone having this kind of issue should try and see if there is any connections that may be scrambling the firmware...
   I measured vibration, made like 3 or 4 prints before it started to get rusty and not want to restart firmware, until it didnt and i could not have the serial connect by any means.
   I tried to reflash the board firmware, reinstaled debian on cb1, try many different sd cards, but what fixed in the end was pull out some plugs
Hope it helps others

robcampman, 2023-09-11:
I also have a problem with my board. Unfortunately the resistors measure 1.59 volts.  Thus same problem as the po.  Does anyone know how to fix this problem. I would be comfortable soldering or rerouting some wires.

ibrahimahmad-id, 2024-01-15:
> I'm having a similar issue with my m8p v1.1 it seems to boot everything but there is no power led near the hdmi ports the photo is after 20 ish minutes trying to boot.

You mean the ACT led?

I find that if you flash newer CB1 system image, like v2.3.3 either Klipper or Minimal version, the ACT led doesn't lit up/blinking, but if I flash older CB1 system, like the v2.1.2, the ACT led lit up & blinking as usual. Despite that, I still can SSH to my CB1 and open the Klipper UI even if the ACT led doesn't lit up like usual. You can try flash to older CB1 system and see that the LED will lit up again.

Note that I do have similar issues with the rest of the guys here where after months of printing, my CB1 suddenly lost its MCU path to my M8P and can't find it by serial/by-id/.

ploucandco, 2024-01-16:
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

Hello, were you able to solve the issue this way? I got a Manta M8P V1.0 and got the same issue with the USB hub not working. I was thinking of connecting pin 20 (VD33F) to the 3.3V board supply as this seems to be the way to get this chip supplied by 3.3V. I just wondered about disconnecting the 5V... Any experience if that works?

PixelVengeur, 2024-02-01:
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

I'm having the same symptoms exactly. No USB device is detected, be it the M8P, a flash drive, keyboard, mouse, whatever. I'm not getting 0.9V, mor ein the realm of 1.7V, but it shows teh same issues. I do not have any external PSU I can generate 3.3V from, so I can't confirm whether that would fix the problem.

Claudiuene, 2024-09-18:
hello, I had the same problem with version 2.0 M8P. look here the solution.
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

Thread 26 (2022-12-16):

How set gpio to high on Boot

MolgoVulgo, 2022-12-16:
Hi ,

I am trying to activate a pin to high at system startup
as you can do with a raspberry (dtoverlay=gpio-poweron, gpiopin=23, active_high for exemple)

thank you for your help

psamvks, 2023-02-01:
you need to re-make / compile the firmware (not the klipper.cfg file).  6.2 on the BIQU user manual.  When making the firmware.bin file select "GPIO pins to set at micro-controller startup" and set PC3 to 1.  I will try to update this post to the required code.  But if not google it, this problem vexed me with the M8P.  Until re-compiling the .bin, I had to hold my power button on the printer for 2 min  before it would stay on by itself.

Thread 27 (2022-12-21):

Manta M8P Boot Loop on SPI1 with ADXL345

NiLMoXiE, 2022-12-21:
Connecting an ADXL345 to SPI1 on my Manta M8P causes the MCU to not boot. It seems like the bootloader is conflicting with some other device on SPI1 on boot.

Can anyone confirm if there is any other device on this board that uses SPI1 which would cause this?

Also is there any way to solve this issue - is there a different bootloader I can use?

Thanks

NiLMoXiE, 2022-12-22:
Despite the update to the user manual for the ADXL345 - it still produces the same issue - MCU will not boot with ADXL345 connected via SPI1

Bischi1997, 2023-01-20:
I tried it, for me it seems to work with Klipper and a CB1, when specifying ports without using SPI1:
```
[adxl345 hotend]
cs_pin: PB15 #PC4 did not work for me, even though I have v1.1 without the 31865
spi_software_sclk_pin: PA5
spi_software_miso_pin: PA6
spi_software_mosi_pin: PA7
axes_map: x,z,y
```

Tomadoggy, 2023-03-07:
I am just now trying to install my adxl345 on my Manta M8P / CB1 and am unable to boot with the sensor attached to SPI1.  Interestingly enough, if I hot plug the sensor into the SPI then everything works.  I can successfully execute ACCELEROMETER_QUERY, AND MEASURE_AXES_NOISE.  However, if I leave the sensor plugged in, I can not boot.  Here is my setup in printer.cfg:

Marck80, 2023-03-14:
you solved? I have the same problem

Tomadoggy, 2023-03-14:
No resolution yet...was working with a BTT tech on their FB groop and tried
a lot of things, now that tech has gone silent.
*-*-*-*-*-*-*-*-*-*-*-*-*-*-*-*-*-
        *John*

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

Cambridge66, 2023-03-23:
I have the exaxt same issue M8P v1.1 - any board restart will force to re-flash firmware on MCO when the ADXL345 is connected. If I disconnect it, board boots.

Tomadoggy, 2023-03-23:
So we have it posted here...but I am not too hopeful that BTT will pick it up and respond.  I have gone to several Discord chanels and the BTT Facebook site but no resolution.  Any Ideas from you?

Marck80, 2023-03-23:
i bought "BIGTREETECH BTT ADXL345 V1.0" and with that it works.

Tomadoggy, 2023-03-27:
@RickoT I have the same ADXL, Just to verify you are not using SPI1, but connecting to PC4 and also want to make sure you can boot with the ADXL connected.  On SIP1 I can use the ADXL but only if I plug it in after booting the M8P...you do have the M8P here correct?  Hope this works, but wanted to verify with you prior to rewiring.  Thank you.

Tomadoggy, 2023-03-27:
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

RickoT, 2023-03-27:
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

RickoT, 2023-03-27:
Oops, SCA === SDA

Tomadoggy, 2023-03-27:
@RickoT  I see the disjoin now...you have version 1.1 of the board, I have version 1.0.  Same wiring different pin assignments.  Glad yours is working maybe this is an issue with V1.0 of the board.
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

RickoT, 2023-03-27:
Try swapping your PA6 and PA7 pins, thats what I did when it was not booting the MCU

Also, while im here, im trying to find out if I should keep the acetometer on all the time or just while tuning?  Also, if there is a purpose for leaving the accelerometer on all the time is there a way to have both axis hooked up at the same time?

Tomadoggy, 2023-03-27:
Just a very small current draw while hooked up.  NP to leave it on.

I swapped PA6 and PA7, booted, but no communication with the ADXL.  Again, mine works just fine, but no board boot when connected.  Thus my pins are correct, but thanks for the suggestion

Flavourdynamics, 2023-04-13:
I'm also experiencing this issue. Wont boot when connected.

TFLRichard, 2023-04-17:
Wow, I am having this same issue with the Manta M8P and the ADXL345. I have noticed that I can't use the GND/+5v I had to go to the 3.3v pin because I fried my first ADXL345. So here is my issue. I can connect to the ADXL345 and I can run the accelerometer_query with results: accelerometer values (x, y, z): -9548.656652, 2298.286494, 0.000000.
My .conf:
########################################
# ADXL
########################################

[adxl345]
cs_pin: PB15
spi_software_sclk_pin: PA5
spi_software_mosi_pin: PA7
spi_software_miso_pin: PA6
spi_speed: 5000000
rate: 3200
axes_map: x,z,y

#[resonance_tester]
#accel_chip: adxl345
#probe_points: 150,150,100
As soon as I uncomment [resonance_test] my printer locks up and will not boot into the firmware.
I am at the end of my rope. Please help me!

Tomadoggy, 2023-04-17:
I upgraded to the V1.1 version of the board and now can boot with the ADXL connect.  Try as I did to get it working with the V1.0 and even working directly with BTT, never achieved success.
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

TFLRichard, 2023-04-17:
> I upgraded to the V1.1 version of the board and now can boot with the ADXL connected. Try as I did to get it working with the V1.0 and even working directly with BTT, never achieved success. 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

I did get mine working last night on the V1.0. What I had to do is place the ADXL section under the spot in the printer.cfg where is says BL-Touch. Once I rebooted and power cycled the printer it worked just fine.

Flavourdynamics, 2023-04-18:
> I upgraded to the V1.1 version of the board and now can boot with the ADXL connected. Try as I did to get it working with the V1.0 and even working directly with BTT, never achieved success. 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

What do you think the solution here was? Your pin def is slightly different than mine, but you've also specified the spi speed, rate, axes map, and included the resonance tester section below. I'll give this a shot tonight.

chaaalyy, 2023-04-23:
It seems, the Manta M8P isn´t the only board with exact that problem: With the new BTT Octopus Max EZ exactly the same. Thanks for pointing to the miso/mosi swap. That did the trick for me (at least as a quick and dirty workaround). Unfortunately i can´t leave it like that, because the steppers (in case of 5160´s or similar) use the same cpu pins (shared spi) and in a couple of weeks i get other drivers / motors... I didn´t buy BTT for a long time (just problems with their stuff) and it seems, the decision to come back for the "top of the line" board also was nothing than a mistake :(

egypro98, 2023-05-04:
> > I upgraded to the V1.1 version of the board and now can boot with the ADXL connected. Try as I did to get it working with the V1.0 and even working directly with BTT, never achieved success. 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
>
> I did get mine working last night on the V1.0. What I had to do is place the ADXL section under the spot in the printer.cfg where is says BL-Touch. Once I rebooted and power cycled the printer it worked just fine.

--
Can you tell us more details please, type of adxl345 you are using, pins of adxl, etc
what i tried to do to  get mine working and escape from booting was
1- connect adxl after booting but gives an error when trying to use [resonance_tester]
2- using a rpi pico but klipper gives >> adxl345: spi pins must be on same mcu
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

3- using usb-adx345 provided by triangle labs but gives the same error
4- changing pins to another pin such exp pins but it gives that adxl345 is not connected
Note : i am using RATos
Is buying an adxl345 provided by btt is the only way to fix that ?

GitRDone2022, 2023-05-13:
Same problem on my M8P v1.0  Rewired to use the other SPI channel for the screen.

Moved the pins to EXP2, (Power & GND from EXP1) and works perfectly.

[adxl345]
cs_pin: PB12
spi_software_sclk_pin: PB13
spi_software_mosi_pin: PB14
spi_software_miso_pin: PB11
spi_speed: 5000000
rate: 3200

Passed ACCELEROMETER_QUERY and TEST_RESONANCES

yuriy-panov, 2023-05-31:
Cheap chinese adxl345. Manta m8p v1.1. Did exactly as [RickoT] wrote. All works fine. No issues at all

fabio-s-franco, 2023-06-28:
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

It all depends on your setup. My struggle with it seems to be some sort of SPI channel conflict. Because both my TFT screen and MAX driver work via SPI, something is happening there that prevents proper setup od ADXL.

I still have to try connecting it without the screen and with a regular thermistor that won't require the max driver then I can also switch off the SPI bus used by the TFT in CB1 /boot/BoardEnv.txt

The fact is this board definitely has issues and if BTT was active here, perhaps not so many people would need to contact them directly which takes weeks to get a response from, which also makes diagnostics a whole lot more difficult with so much time in betwwen.

firegarch, 2023-08-04:
I am kind of stuck at the same point, trying to connect a M8P/ CB1 to the proposed ADXL345 shown in the BTT M8P manual
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

No luck with anything so far. Since I am running TMC5610, I am already relying on spi_software pins for all of the driver controls.

## What I have tried:
- Connecting ADXL345 to M8P as described in manual with CS_pin = PC4 and PB15
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

and

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

- Flipping MISO and MOSI pins in HW, just in case. --> No difference
- Unplugging the screen and using EXP2 pins
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

No matter what I do, I always get the same error message:
`Error on 'ACCELEROMETER_QUERY': missing CHIP`

The only difference I see is, that in the first configuration version mentioned (with cs_pin as  `PC4`), klipper doesn't boot with the adxl345 connected.
I even tried a 2nd accelerometer in the form of this one: GY-291
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

It doesn't matter exact same behavior. I have absolutely no idea what the problem is. Any advice on how to proceed?

IVOMTB, 2023-09-26:
Hi dudes i got it!!! Vcc to 3.3 v try

#[adxl 345##################################################
[adxl345]
cs_pin: PB15
spi_software_sclk_pin: PA5
spi_software_mosi_pin: PA7
spi_software_miso_pin: PA6
spi_speed: 5000000
rate: 3200
axes_map: x,z,y

[resonance_tester]
accel_chip: adxl345
probe_points: 150, 150, 20  # an example

yshui, 2023-10-04:
I am having the same problem. M8P won't boot if adxl345 is plugged in (it also seems to die if I change adxl345 config and restart klipper). But after M8P has booted, adxl345 works just fine.

I am using `cs_pin: PC4` and hardware spi.

IVOMTB, 2023-10-07:
i made this steps:
reboot M8P without connect (sdo/sda/scl)
connect cable on board ADXL and  try ACCELEROMETER_QUERY  If you see accelerometer_value try next step...

fabio-s-franco, 2023-10-28:
> I am having the same problem. M8P won't boot if adxl345 is plugged in (it also seems to die if I change adxl345 config and restart klipper). But after M8P has booted, adxl345 works just fine.
>
> I am using `cs_pin: PC4` and hardware spi.

I am yet to find a hardware spi that works in this board. Same problem with MAX31865 v2 (from BTT even). Just go with software (check the manual again, seems it changed since I saw it last time, uses pin PB15, instead of PC4 like before).

Flavourdynamics, 2023-12-05:
It seems like I finally got it following mostly Ricko's instructions:

Manta V1.1
Generic ADXL

[adxl345]
cs_pin: PC4
spi_software_sclk_pin: PA5
spi_software_mosi_pin: PA6 #SD0 --> MOSI
spi_software_miso_pin: PA7 #SDA --> MISO
spi_speed: 5000000
rate: 3200
axes_map: x,z,y

Notably, using opposite pins than what the Manta manual specifies. I'm using 3.3V, as the chip was quite hot on 5V. Further testing will be required to confirm the fix.

Flavourdynamics, 2023-12-06:
This change is under review. Do not apply yet.

Twisted-FPV, 2024-04-14:
I got it working on the Manta M8P v2.0 finally.
hope this helps someone thats been searching for info on how to do it on the v2.0
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
[adxl345]
cs_pin: PA15
spi_software_sclk_pin: PC10
spi_software_mosi_pin: PC12
spi_software_miso_pin: PC11
spi_speed: 5000000
rate: 3200
axes_map: x,z,y

Genocrush, 2024-09-21:
> I got it working on the Manta M8P v2.0 finally. hope this helps someone thats been searching for info on how to do it on the v2.0 ![manta SPI Pinout](https://private-user-images.githubusercontent.com/160196357/322281093-27c8bc0a-dfa5-49df-ac4d-c6e5892edb7d.png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) ![20240414_020321](https://private-user-images.githubusercontent.com/160196357/322281304-d1ca2dca-1f7f-4fb8-9f9a-c15ab18f458e.jpg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) ![20240414_020353](https://private-user-images.githubusercontent.com/160196357/322281311-6fb1e1c0-15dd-417c-9cac-f36a552ef453.jpg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) [adxl345] cs_pin: PA15 spi_software_sclk_pin: PC10 spi_software_mosi_pin: PC12 spi_software_miso_pin: PC11 spi_speed: 5000000 rate: 3200 axes_map: x,z,y

thank you so much i have been searching like crazy. worked perfectly without any problems. a very good guide that is very easy to follow.

Thread 28 (2023-01-05):

screw size for CB1/CM4

jscancella, 2023-01-05:
What screw size should be used for the CB1/CM4 mount? I tried 2mm and 2.5mm but neither seemed to want to screw in.

jfneptune, 2023-01-06:
The boards just snap in place.  It takes a little more force than I care for, but it will just snap in place.  No screws are needed.

jscancella, 2023-01-07:
> The boards just snap in place. It takes a little more force than I care for, but it will just snap in place. No screws are needed.

Yes I did that, but I saw that there are 4 mounting holes for screws and I wanted to use those as well.

thisiskeithb, 2023-01-07:
M2.5, but there is tape covering the standoffs that will need to be removed.

anscarlett, 2023-07-16:
Strange that it isn't written on the dimensional drawings anywhere. Disappointing that the screws weren't supplied with the board.

jpereira-ca, 2023-07-16:
> M2.5, but there is tape covering the standoffs that will need to be removed.

Yes, there are tiny little round translucent orange stickers protecting the screw holes. After removing them, the M2.5 screws fit perfectly.

anscarlett, 2023-07-18:
For reference, I found a review on amazon saying that with the heatsink, you need 2x M2.5x8mm and 2x m2.5x6mm screws. Would have been nice to have designed the heatsink so only one size screw was needed.

Thread 29 (2023-01-08):

Manual sections

kwalters3, 2023-01-08:
Sections were removed from manual but still are listed in TOC.

sections are:
5.5  Install Klipper with kiauh script
5.6 Checkout klipper branch
5.7 Fix Klipperscreen

Thread 30 (2023-01-11):

CanBus support

emersonsc, 2023-01-11:
The owners manuals provided give zero help on getting the built in canbus to work. Theres no pin outs either.

Vargsh0rd3, 2023-01-17:
i agree. Im so close to just sledge hammering shit. i feel like ive watched and read 1000 bits a piece, and im still no closer. and fairly certain ive bricked an unnecessary U2C

emersonsc, 2023-01-17:
> i agree. Im so close to just sledge hammering shit. i feel like ive watched and read 1000 bits a piece, and im still no closer. and fairly certain ive bricked an unnecessary U2C

Yeah its annoying how spread out and fragmented documentation is for CanBus. For as much of a hard@$$ O'Conner is about stuff, you'd think he wouldnt merge something like CanBus into Klipper without proper documentation...

Vargsh0rd3, 2023-01-17:
Ingot my voron at the end of September. Had it running  foe maybe 2 weeks. Gotna few mods and lost a month. Finally got it running for another week. Tap arrived. Fried my board and all my LEDs because of poor documentation on a necessary alteration to hartk pcb.
Dfh took 4 weeks to send me 600 bucks of stuff that I now can't get working.
I'm starting to feel really stupid.

emersonsc, 2023-01-17:
> Ingot my voron at the end of September. Had it running foe maybe 2 weeks. Gotna few mods and lost a month. Finally got it running for another week. Tap arrived. Fried my board and all my LEDs because of poor documentation on a necessary alteration to hartk pcb. Dfh took 4 weeks to send me 600 bucks of stuff that I now can't get working. I'm starting to feel really stupid.

what mods? are you on discord we can  move this conversation there and I could possibly help

Vargsh0rd3, 2023-01-17:
No those were like 2 crisis ago lol. I gotnthat stuff figured now.
We have the same problem now. And i dunno. I know not probably help matters. But I don't feel like I learned anything if I get help. I needn't scrape and struggle and curs4nthe sky and smash a 20 year old monitor with a sledgehammer that I keep around for therapy rage.

Vargsh0rd3, 2023-01-17:
Healthy eh?

Vargsh0rd3, 2023-01-17:
Holy sausage thumbs. I need to proofread. Too much repetitive mumbo-jumbo. Too lazy. Eyes... searing shut.

ALM007cs, 2023-02-09:
This is a feature that is also advertised on the homepage and in the sales documents, but there is no documentation on how to use it.
How is the Can-Bus functionality activated when using a CB1?
Not a word about it in any documentation from Biqu or BTT.

emersonsc, 2023-02-12:
> This is a feature that is also advertised on the homepage and in the sales documents, but there is no documentation on how to use it. How is the Can-Bus functionality activated when using a CB1? Not a word about it in any documentation from Biqu or BTT.

This is something Biqu/Bigtreetech does with pretty much everything they sell. They make lots of claims on the productpages, then when it comes to support its crickets except for the cheerleaders who get upset when you call our Biqu/BTT for this kind of crap.

alexwiecke, 2023-02-14:
Hey guys, this is the procedure we follow for getting CANBUS working on the Manta v1.1s:

These instructions reference the Manta M8P User Manual v1.04 (Commit 53df01d on Jan 8)

1) Flash the compute board (CB1 or CM4) following the normal procedure in section 4 or 5 of the manual
2) SSH into the compute board as shown in section 6.1
3) In the terminal, navigate to the klipper repository and open the build configuration:
``` bash
cd ~/klipper
make menuconfig
```
4) Follow the compile instructions shown in section 6.2, however compile with the configuration shown below in the first step:
``` menuconfig
[\*] Enable extra low level configuration options
	Micro controller Architecture (STMicroelectronics STM32 )
	Processor model (STM32G0B1 )
	Bootloader offset 8 KiB bootloader)
	Clock Reference (8 MHz crystal)
	Communication interface (USB to CAN bus bridge (USB on PA11/PA12))
	CAN bus interface (CAN bus (on PD12/PD13))
(250000) CAN bus speed
```
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

5) Press 'q' to exit, save the configuration
6) Build the firmware:
``` bash
make clean
make menuconfig
```
7) Put the Manta MCU in bootloader mode:
	1) Hold down the BOOT0 button
	2) Press and release the RESET button
	3) Release the BOOT0 button
8) Flash the MCU:
``` bash
make flash FLASH_DEVICE=0483:df11
```
9) Look for the success message. If the file does not download successfully, redo step 7 and try again.

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

10) Configure the CANBUS UUID for the manta
Get the MCU's UUID
``` bash
~/klipper$ ~/klippy-env/bin/python ~/klipper/scripts/canbus_query.py can0
```
Expected response:
``` bash
> Found canbus_uuid=[UUID], Application: Klipper
> Total 1 uuids found
```

If the UUID doesn't appear, make sure you've setup the host as recommended in the instructions under [Host Hardware](https://www.klipper3d.org/CANBUS.html#host-hardware), then reflash the board per steps 7-9

11) Wire up the CAN bus using a twisted pair between the manta and your other boards.
See the Manta M8P v1.1 pinout on page 11 of the manual.
Make sure to verify that you have 120ohm resistors terminating the bus, and that your other boards are flashed for CANBUS communication at the same speed (250000)

**Once you've gotten to this point, the [Klipper CANBUS documentation](https://www.klipper3d.org/CANBUS.html) will get you the rest of the way**

ALM007cs, 2023-02-14:
@alexwiecke It Works.... THX

Only problemv i got was the bootloader. I have to flash the firmware by sd -card.

Now CAN-bus communication to EBB36 work well - without additional boards.

alexwiecke, 2023-02-14:
Hey guys, this is the procedure we follow for getting CANBUS working on the Manta v1.1s:

These instructions reference the Manta M8P User Manual v1.04 (Commit 53df01d on Jan 8)

1) Flash the compute board (CB1 or CM4) following the normal procedure in section 4 or 5 of the manual
2) SSH into the compute board as shown in section 6.1
3) In the terminal, navigate to the klipper repository and open the build configuration:
``` bash
cd ~/klipper
make menuconfig
```
4) Setup the configuration shown below:
``` menuconfig
[\*] Enable extra low level configuration options
	Micro controller Architecture (STMicroelectronics STM32 )
	Processor model (STM32G0B1 )
	Bootloader offset 8 KiB bootloader)
	Clock Reference (8 MHz crystal)
	Communication interface (USB to CAN bus bridge (USB on PA11/PA12))
	CAN bus interface (CAN bus (on PD12/PD13))
(250000) CAN bus speed
```
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

5) Press 'q' to exit, save the configuration
6) Build the firmware:
``` bash
make clean
make
```
7) Put the Manta MCU in bootloader mode:
	1) Hold down the BOOT0 button
	2) Press and release the RESET button
	3) Release the BOOT0 button
8) Flash the MCU:
``` bash
make flash FLASH_DEVICE=0483:df11
```
9) Look for the success message. If the file does not download successfully, redo step 7 and try again.

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

10) Check that the MCU is showing up as a CANBUS device:
``` bash
~/klippy-env/bin/python ~/klipper/scripts/canbus_query.py can0
```
Expected response:
``` bash
> Found canbus_uuid=[UUID], Application: Klipper
> Total 1 uuids found
```

If the UUID doesn't appear, make sure you've setup the host as recommended in the instructions under [Host Hardware](https://www.klipper3d.org/CANBUS.html#host-hardware), then reflash the board per steps 7-9

11) Wire up the CAN bus using a twisted pair between the manta and your other boards.
See the Manta M8P v1.1 pinout on page 11 of the manual.
Make sure to verify that you have 120ohm resistors terminating the bus, and that your other boards are flashed for CANBUS communication at the same speed (250000)

**Once you've gotten to this point, the [Klipper CANBUS documentation](https://www.klipper3d.org/CANBUS.html) will get you the rest of the way**

danielsmoura, 2023-02-16:
This work, but how i get the serial of Manta, because when i try run "ls /dev/serial/by-id/" the command return to me this error:
ls: cannot access '/dev/serial/by-id/': No such file or directory

Alex-Pantheon, 2023-02-16:
> when i try run "ls /dev/serial/by-id/" the command return to me this error: ls: cannot access '/dev/serial/by-id/': No such file or directory

Once flashed in [CAN bridge mode](https://www.klipper3d.org/CANBUS.html#usb-to-can-bus-bridge-mode) the MCU no longer appears as a serial device, but instead shows up as a CAN device on `can0`. So you'll need a CAN UUID, not a Serial ID.

See the [Klipper CANBUS documentation](https://www.klipper3d.org/CANBUS.html) for instructions on how to query and configure it.

danielsmoura, 2023-02-16:
Im not need put on printer.cfg the ?:

[mcu]
serial: /dev/serial/by-id/xxxx

What i put here ?

Alex-Pantheon, 2023-02-16:
@danielsmoura, instead of a serial address, you'd put a CAN UUID, see below:
```
[mcu]
#serial: not needed
canbus_uuid: 6cc687f42f48
```

ALM007cs, 2023-02-16:
@danielsmoura :
https://www.klipper3d.org/CANBUS.html

twingi0815, 2023-02-28:
every time I turn the printer off and on again it shows me

~/klippy-env/bin/python ~/klipper/scripts/canbus_query.py can0

 Total 0 uuids found

when i flash the board new is show 1 uuid .

when i turn the printer off and on it shows total uuids 0

EveCodeJunkie, 2023-03-04:
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

Once you update your printer.cfg with the canbus_uuid and restart, klipper will claim the device.  Running canbus_query.py will only show new or otherwise unused canbus devices.

twingi0815, 2023-03-05:
> Once you update your printer.cfg with the canbus_uuid and restart, klipper will claim the device. Running canbus_query.py will only show new or otherwise unused canbus devices.

after a restart, my board in klipper also disappeared

twingi0815, 2023-03-05:
no it disappears even if i don't write the uuid in klipper

that's life shit like the flashing of the ebb42

Mickd02, 2023-03-06:
Vargsh0rd3 and emersonsc i feel your pain been at it 3 weeks and no luck and pure frustration. my setup is pure BTT Manta m8P v1 ,CB1 and Io2Can, originally started with SB2240 but being new to this whole tmc2240 thing NOT supported natively!!  so thought give it a go and ordered a SB2209 seeing as it looks to be supported, thinking should be easy as now got all the products that "should work together" BUT hard NO!! really think BTT rushed this out before Holidays hoping some would work it out for them. BTT need to realize that not everyone is a programming genius and need to write decent instructions that make sense and not 3 different ways to do the same task as it all melds into??? a product that doesn't work as advertised.
I also see the Github Klipper Branches for TMC2240 are no good also .. machine now going back to hard wiring and deal with the can bus in 6 months when it all gets sorted.
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

Jjustice1993, 2023-03-12:
So I have been working on this throughout the morning, I have got to the point where i can connect to the MCU board (Manta) via CANbus, but once i plug the hermit crab in it crashes the CAN network, following schematics from BTT GitHub for each the Manta m8p and hermit crab tool board i have made a connector, once this happens even after a hard reboot and disconnecting the hermit crab from the board the CAN network will not recover. Any ideas? Do i need to define the CAN pins in the klipper config?

patrickdiesslin, 2023-03-25:
Thanks @Alex-Pantheon could I please ask for some help.
Where you wrote;
_Wire up the CAN bus using a twisted pair between the manta and your other boards.
See the Manta M8P v1.1 pinout on page 11 of the manual._

Could you please show which pins on that page to use for the canbus connection and the pinout of those pins please.
Thanks in advance

EveCodeJunkie, 2023-03-25:
To use the built in CAN Bus on the Manta M8P, you need to use pins PD12/PD13.

omorgan831, 2023-04-16:
Just want to make sure I understand the physical connection side of stuff... the firmware bit makes sense.

When using a CM4/CB1 with the Manta v1.1 is the can comms done through the B2B connectors for the CM4/CB1 or does it need the likes of a Pi Can hat?

I ask as I'm building / looking to build a system with a preexisting hermit crab can toolhead (the hermit crab comes with a pi hat, and a tool board).

I 'assume' the PD12/13 connectors on the V1.1 board would go to the hermit crabs tool board (a 'dumb' hub) but does it still need the pi hat to connect to the tool board as well?

Can the v1.1 use Canboot or can it be re-flased via the klipper tools as described above after the MCU is flashed the first time (assume again you'd point your binary to can0 uuid).

Any advice would be appreciated. Whilst I HATE BTT for their overall lack of support once schematics and rough manuals have been uploaded (very much heres the hardware work it out yourself), they do make hardware that fits with what I want to achieve at a price point that makes sesne...... and I know I'm lucky enough to be able to decipher (more or less) the info they do upload.

EveCodeJunkie, 2023-04-16:
> Just want to make sure I understand the physical connection side of stuff... the firmware bit makes sense.
>
> When using a CM4/CB1 with the Manta v1.1 is the can comms done through the B2B connectors for the CM4/CB1 or does it need the likes of a Pi Can hat?

The CAN and the rest of the MCU communicate with the CM4/CB1 through the B2B connectors.  There is no need for a seperate CAN hat.  You can use a separate CAN hat if you want to offload the CAN communications and not use the built in CAN.  There is plenty of CPU and bandwidth on the Manta so I don;t see this as usefull.

> I ask as I'm building / looking to build a system with a preexisting hermit crab can toolhead (the hermit crab comes with a pi hat, and a tool board).
>
> I 'assume' the PD12/13 connectors on the V1.1 board would go to the hermit crabs tool board (a 'dumb' hub) but does it still need the pi hat to connect to the tool board as well?

If you are using the CAN version of the Hermit Crab Tool board, I see no reason why you would need the Pi CAN Hat.

> Can the v1.1 use Canboot or can it be re-flased via the klipper tools as described above after the MCU is flashed the first time (assume again you'd point your binary to can0 uuid).

The 1.1 can use CanBoot, but I see no reason to.  The Manta is directly connected to the CM4/CB1 and always will be.  So flashing/reflashing is quite easy and direct.  You would only need CanBoot if you want to flash devices that are only connected to the CANBus.

> Any advice would be appreciated. Whilst I HATE BTT for their overall lack of support once schematics and rough manuals have been uploaded (very much heres the hardware work it out yourself), they do make hardware that fits with what I want to achieve at a price point that makes sesne...... and I know I'm lucky enough to be able to decipher (more or less) the info they do upload.

Yeah, the lack of support sucks.  Took me forever to get my Manta MP8 v1.1 w/CB1  and EBB SB2209 working together.  Three of their own products.  You would think that there would be a step by step guide somewhere, but nope.  You got to figure it all out yourself.

omorgan831, 2023-04-16:
Huge thanks,

Yh as its using the B2B then that all makes sense. And again, no need for canboot as its using that.

Seriously thanks for your time and support!!

nikolicjakov, 2023-04-24:
@EveCodeJunkie

Hi there! Your comment was helpful in order to understand that i do not need to use Pi HAT that came with my Hermit Crab CAN.

Now i need to figure out how i could cut off one end of phone cable that came with the device and crimp connectors for my Manta M8P motherboard CAN pins.

Do you mby know where i could find pinout for BIGTREETECH CAN-Tool Board Version V1.0.

I only could find pinout for my motherboard..

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

But i would need to know the other end also.. :(

Rizz226, 2023-04-24:
If I'm understanding you correctly, you'll find the pinouts in this repo:

https://github.com/bigtreetech/EBB

So on one end, you'd have your manta & a positive and negative lead from your PSU. On the other side of the cable will be whichever EBB CAN board you have.

nikolicjakov, 2023-04-24:
That is correct i have Hermit Crab CAN and Manta M8P. Now i have them connected without using RPi Hat and now i need to understand how to configure software part.

Do i need to flash some custom klipper binary to Hermit Crab CAN and how could i use 2 mcu-s (Manta M8P and Hermit Crab CAN) in klipper...

Rizz226, 2023-04-24:
@nikolicjakov - for the simplest setup, you'd flash your hermit crab with whatever is normal for that particular board. For the manta however, you'll have to choose the connection type "USB TO CAN BRIDGE" when building it's firmware. Reference the pinout for the specific option to choose. After that, you'll run the can_query script from the Klipper CANBUS documentation and you should see 2 uninitialized devices. Top one was the Manta for me.

nikolicjakov, 2023-04-26:
After a day of thinkering with Crab CAN and M8P i have managed to get it working. But do not ask me how since i do not know i have compiled and flashed klipper milion times both on manta m8p and crab CAN. After some time it just booted and worked.

So i can only confirm that combinantion where you have Manta M8P and Hermit Crab CAN can work togather without RPi HAT but direct from motherboard to CAN board and then from CAN board to Hermit Crab via USB type C cable.

bthubs, 2023-05-04:
I got CAN to work on my m8p + cb1 and sb2209. For those who are still trying to figure it out using the guide, there's a very important step that is not included as detailed by Alex-Pantheon. What confused me most was flashing two different configs of klipper, one is for the SB2209, the other is for the Manta M8P MCU. I'll detail how I got the m8p to communicate with the SB2209:

1. Flash CANboot to the SB2209 (CAN PB0/PB1) (follow guide)
2. Flash klipper to SB2209 (CAN PB0/PB1) (follow guide)
3. Flash klipper to M8P MCU as detailed by Alex-Pantheon (USB to CAN bus bridge PA11/PA12 + CAN bus interface PD12/PD13)
4. Run `~/klippy-env/bin/python ~/klipper/scripts/canbus_query.py can0`, this should show 2 CAN bus IDs both running klipper, if not repeat steps 1-3.
5. Under printer.cfg [mcu] section, comment out serial, add canbus_uuid: ###### (for M8P CAN bus ID)
6. Under BTT sample cfg for SB2209 [mcu EBBCan] section, comment out serial, add canbus_uuid: ###### (for SB2209 CAN bus ID)
7. Restart

Hope this helps!

Alex-Pantheon, 2023-05-04:
Yeah, every CAN board has its own flavor of flashing procedure and config, you'll have to follow the flashing instructions specific to your board.

djeZo888, 2023-05-17:
Ah thanks! So, only two wires are actually needed then.

From here: https://github.com/bigtreetech/HermitCrab/blob/master/CanbusKlipper/Hardware/Schematic/BTT%20Tool%20Board-SCH.pdf
I see that Hermit Crabs Toolboard RJ11 CAN-IN port takes in two sets of CANs: CAN0 and CAN1. Does it matter which one is connected to M8P? Looking at schematic, it makes sense to use CAN1-L and CAN1-H. CAN0 only goes from CAN-IN to CAN-OUT.

seb449, 2023-05-17:
Hi, my card communicates well, Found canbus_uuid=030792b2fc33, Application: CanBoot
but on klipper hs, with
[mcu can0]
canbus_uuid: 030792b2fc33
not ok  !!!

    allow-hotplug can0
    iface can0 can static
         bitrate 250000
         up ifconfig $IFACE txqueuelen 2048

Help

nikolicjakov, 2023-05-22:
BIGTREETECH IF YOU READ THIS YOU SHOULD RLY IMPROVE ON YOUR DOCUMENTATION!

IT IS NOT ONLY IMPORTANT TO SELL YOUR EQUIPMENT BUT TO SUPPORT YOUR CUSTOMERS.

jpereira-ca, 2023-06-23:
For all those out there wondering what the pinouts and wiring diagram between the Hermit Crab CAN Tool Board and the M8P v1.1 CAN headers is, here it is:

When you are looking at the tool board from top, the 3rd and 4th wire from the left, are CAN-H and CAN-L respectively, and when you look at the M8P Can header pins from left to right are CAN-L, and CAN-H, respectively.

albielew, 2023-07-11:
I have the Manta M8p and considering the Can version of Hermit Crab
but I see the 24V is sent through usb-c cable
Surely usb-c cable is not thick enough to handle the extruder current?

shoikan, 2023-07-22:
>  Surely usb-c cable is not thick enough to handle the extruder current?

As always 'that depends'. I had a a 'fruit-branded laptop, with an i9 CPU that got charged via a USB-C cable with a 90W charger. Heater cartridges tend to be between 30 and 70W. So that fits. Additionally, the 'PD' ('Power Delivery') spec of USB-C lists 20V as the highest end voltage (and even 48V for some extended spec, though I am assuming we won't see that 'in the wild' very often).

Pneumanifest, 2023-07-25:
>

If you use a power delivery USBC cable it is fine. It can handle up to 100W with some newer ones being capable od 250W. Just note that not all USBC cables are power delivery cables.

DP4US, 2023-08-07:
I have an m8p v1.1 and ebb36. There is a resistor on the ebb to jumper that is documented. There is a resistor on the m8p to jumper but not documented. It is next to the can connector. I was getting dropped connection at 250k with 1048 and 500k at 2048. Tried both speeds. Once the jumper was placed on the board no more dropped connections on either speed setup. Went through a lot of configs, apt installs, crimping and testing to find this resistor afterwards. Has not faulted since and 100 print hours later.

Pneumanifest, 2023-08-07:
That's called a termination resistor and is required for canbus. You must always have termination resistors at both ends of the bus lines. 120R is the most common value used. Not having that in place will allow the signal to echo causing all sorts of connection issues.

DP4US, 2023-08-08:
> That's called a termination resistor and is required for canbus. You must always have termination resistors at both ends of the bus lines. 120R is the most common value used. Not having that in place will allow the signal to echo causing all sorts of connection issues.

The m8p does not have this documented at the time of my install. Hope this helps someone.

Pneumanifest, 2023-08-08:
> The m8p does not have this documented at the time of my install. Hope this helps someone.

It is documented in the schematic and printed on the board itself. Depending on how the CAN bus line is being set up it may or may not be needed. There are different configurations so it's not always required, but all can bus lines need the termination resistors at both ends of the bus. If the m8p is at one of the ends it needs it if it's not at the end, for example 2 ebbs, it doesn't need it. It's not anything unique to this board.

DP4US, 2023-08-13:
This must be documented in the M8P manual. The CAN is labeled on the board but newbies to CAN you will need some better documentation. Also needs the same verbiage as the EBB for CAN in the M8P CAN section. An updated picture to show the resistor and when to use it should be added. BTT please ensure this is in all versions that have the CAN bridge. Install is not clear and can be erratic if both are not terminated. Seems 50 50 so please document . All other parts of the CAN are documented well. I believe the speed can be bumped up to 500K and 2048 bit. Not having any issues at this speed [double of manual]. M8P|EBB36 CAN Bridge setup.

Dye007, 2023-08-26:
> Ich habe ein m8p v1.1 und ebb36. Es gibt einen Widerstand am Ebbe-zu-Jumper, der dokumentiert ist. Es gibt einen Widerstand am M8P-zu-Jumper, der jedoch nicht dokumentiert ist. Es befindet sich neben dem Dosenanschluss. Die Verbindung wurde bei 250.000 mit 1048 und bei 500.000 mit 2048 unterbrochen. Ich habe beide Geschwindigkeiten ausprobiert. Sobald der Jumper auf der Platine platziert wurde, gab es bei beiden Geschwindigkeitseinstellungen keine Verbindungsabbrüche mehr. Habe viele Konfigurationen, passende Installationen, Crimpen und Tests durchgeführt, um diesen Widerstand anschließend zu finden. Zunächst und 100 Druckstunden später gab es keine Mängel mehr.

Kannst du mir zeigen ,wie du das angeschlossen hast?

DP4US, 2023-08-27:
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
The are the locations for the jumpers. If you need more help please let me know. I had to google the ebb36 connections for power and can h/l.

JuanSebastianOtalora, 2023-09-21:
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

Is that for CM4 or CB1. I was told by Biqu R&D Justin, that for Hermit Crab CAN with CB1 I would need the IO2CAN v1.0 adapter (same one used for the TFT35 SPI v2.1) to make it work with the CB1. Since that information wasnt available and seems that still not available i didnt purchase the IO2CAN V1.0 so i had to use the Hermit Crab CAN with a raspi 3 and skr e3v2
However there is a new version of the Manta M8P v2.0 that has I2C, not sure if the same as the IO2CAN v1.0 and if it works with CB1. Im still at a loss.
Would be a good idea to invest in the M8P v2 rather than getting the v1.1 to make the hermit crab can work with CB1?

Pneumanifest, 2023-09-21:
The m8p v1.1 and likely the V2 will have no problems using the canbus out with the CB1. You put it in can bridge mode and you're good to go. The original m8P didn't have a canbus transceiver so that's probably why you were told that you needed the IO2Can adapter.

Thread 31 (2023-01-11):

Names for motor plugins for klipper

condescomputers, 2023-01-11:
So I've been trying to locate information on what pin numbers to use for the motor drivers.  Can someone tell me out?

emersonsc, 2023-01-17:
Its in the users manual, pin-out, and schematics, all provided in this repository

Thread 32 (2023-01-15):

Connecting creality sonic pad to manta m8p

Ehukai466, 2023-01-15:
Hello Guys,
I have a creality ender 5 plus with a bigtreetech manta m8p board + cb1. This seems to work as I do not get any errors on the web interface. But now I wanted to add as well the Creality Sonic Pad. But it seems that the sonic pad doesn't get connection to the manta board. I've connected the sonic pad to the USB type c connector. Could it be that this is causing the issue? Does somebody know if I need to use the USB Type A port?

Freddyb888, 2023-03-11:
Following

frutabruta, 2023-04-02:
Combining Manta with Sonic pad is not possible. The USB connectors on the Manta are only connected to the CB1/CM4, not the Manta microcontroller.

Rlinhos, 2024-02-09:
I'm trying to do the same with my Sonic Pad and I just read this. We have to wait for CB1 to arrive.

Thread 33 (2023-01-22):

Bug NEOPIXEL

Foose83, 2023-01-22:
Hello I am having a problem with my Manta M8P V1.
The neopixel LEDs light up partially or they light up in the wrong color or do not go out at all.
I didn't have this problem with my octopus V1.1 card.
has anyone had this problem before do you have any idea what could be wrong thank you in advance.

emersonsc, 2023-01-23:
I corrected the issue by putting a 100ohm resistor on the data line just after the board. Lots of noise ends up on the data line which causes issues, the resistor helps clean it up.

Foose83, 2023-01-27:
Merci pour votre réponse, j'ai essayé 100 ohms et 680 ohms mais cela ne fonctionne toujours pas.
Je continue mes recherches.

NegussugeN, 2023-12-20:
Did anyone ever figure this out? I'm having the same exact issue.

sajrashid, 2024-09-10:
Im having same issue on v2

sajrashid, 2024-09-17:
This is what I have tried board is Manta M8p v2

- Inline resistor (data line) 220 and 100 ohms  😔
- Capacitor small value on the 5v line  😔
- 5v 6a SMPS with a shared ground 😔

I got to light up accidently as the ground was loose, but only about half lit up and did not respond to software changes (apart from a slight flicker)

So has the v2 gone backwards in the LED game

Thread 34 (2023-01-31):

adxl345 chip that I bought is different from  show in user manual

huangzheming, 2023-01-31:
This chip is shown in the user manual:
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
But the adxl345 I bought is like this (same with klipper office manual):
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

The pin name is different between these two chips. How can I connect this rectangular chip to m8p?

Tomadoggy, 2023-03-21:
Here is what I used:

MP8 pin      adxl pin
gnd             gnd
+5V             vcc
PA5             SCl
PA6             SDO
PB15            CS
PA7             SDA

Thread 36 (2023-02-05):

Error in English manual about setting power source (page 15)

GonzoG, 2023-02-05:
There is an error in paragraph **_3.2.5. Selection of driving power supply for stepping motor_**.
Both pictures show how to setup jumpers for VBB (board power input). There is no photo for Motor power input.
Chinese version has correct pictures.

Thread 37 (2023-02-10):

Problems with flashing via DFU

Seoman76, 2023-02-10:
Hi all

Tried to flash my board via DFU and followed the instructions of the manual.

All went quite well the way as shown in the manuel  included the error warning  that could be ignored

But my mcu Version number still shows the old version instead of the new one

Has the firmware been flashed or not?

Seoman76, 2023-02-10:
dfu-util: Invalid DFU suffix signature dfu-util: A valid DFU suffix will be required in a future dfu-util release!!! Opening DFU capable USB device... ID 0483:df11 Run-time device DFU version 011a Claiming USB DFU Interface... Setting Alternate Setting #0 ... Determining device status: state = dfuIDLE, status = 0 dfuIDLE, continuing DFU mode device DFU version 011a Device returned transfer size 1024 DfuSe interface name: "Internal Flash " Downloading to address = 0x08002000, size = 26644 Download [=========================] 100% 26644 bytes Download done. File downloaded successfully dfu-util: Error during download get_status Failed to flash to /dev/serial/by-id/usb-Klipper_stm32g0b1xx_3E0009000A504B4633373520-if00: Error running dfu-util If the device is already in bootloader mode it can be flashed with the following command: make flash FLASH_DEVICE=0483:df11 OR make flash FLASH_DEVICE=1209:beba If attempting to flash via 3.3V serial, then use: make serialflash FLASH_DEVICE=/dev/serial/by-id/usb-Klipper_stm32g0b1xx_3E0009000A504B4633373520-if00 make: *** [src/stm32/Makefile:90: flash] Error 255

manotroll, 2024-04-28:
I found the solution to the problem in a video on YouTube, I'll put it here so you can see
There is an error in the PDF explanation in the manual on how to do it
https://www.youtube.com/watch?v=k8DmTrY2GgY

Thread 38 (2023-02-15):

Motor6 and Extruder config corrections

AmigaZoid, 2023-02-15:
Some of the settings in the Klipper config for Voron2 are incorrect.

Here are the lines affected with corrections

##	Z3 Stepper - Front Right on Motor6
[stepper_z3]
step_pin: PA10
dir_pin: PA14
enable_pin: !PA15

[tmc2209 extruder]
uart_pin: PD14

Thread 40 (2023-02-20):

Retract goes the same direction as extrude

mbruttig, 2023-02-20:
Hi,

I'm running a modified X5SA with an LGX large on a Manta M8P and for some reason my extruder retraction goes the same direction as extrude.  I've tried different motor ports, TMC2209 drivers, and plugging in a standard NEMA17 motor but when I do a G1 E-10 F300 the filament extrudes and does not retract.  Note, the "!" on dir_pin does not change the direction for either extrude or retract.  Here's my extruder config:

[extruder]
#Motor 6
step_pin: PA10
dir_pin: !PA14
enable_pin: !PA15
microsteps: 16
rotation_distance: 8
nozzle_diameter: 0.4
filament_diameter: 1.75
heater_pin: PE3 # HE0
sensor_pin: PA1 # T0
sensor_type: Generic 3950
min_temp: 0
max_temp: 450

[tmc2209 extruder]
uart_pin: PF8
run_current: 0.800
stealthchop_threshold: 999999

I've also tried without the TMC2209 settings and same issue.

Cheers

RandomUser2030, 2023-02-27:
Hi - I'm stuck and it's driving me nuts.   I have replaced multiple cables and motors, and change controller ports and dir_pin settings.  No matter what I do, the extract and retract always turn clockwise - both in always the same direction.  I've emailed BIQU but they haven't been able to resolve the issue yet.  Has anyone seen this before?  Thx

RezezRX79, 2023-03-09:
I know how you feel I am having the same issue with the manta M8p 1.1 card. I have been looking in to it and it and if you look at the board schematic it appears that stepper 6 is using a different component for its direction pin than all the other steppers. for now I just swapped the servo I was going to use on 6 to 8. If anyone can figure out the right pin call out (AKA PA14, PA15, PD15 or what ever) that would be great.
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

12voltnick, 2023-03-15:
I think I figured it out! when I was doing the config for the stepper motors I was looking at a V1.0 pinout, but i have a V1.1 board. the pinouts are similar but not the same! and some of the pins are used for other things. Check your pinout version against your board version and this should give you the correct pin labels for step, direction, enable, and uart pins.

RandomUser2030, 2023-03-15:
Hi 12voltnick - that was the problem.  I have a v1.0 board and all the pinouts are the same for both boards up to motor6, so I didn't make the connection.  I'm surprised BTT didn't make the connection.  I had put the project on hold until I read your post.  Thank you!

Thread 42 (2023-02-22):

Manta M8P + CM4 , no usb connection , not flashing from SD card

Erik-Erikson, 2023-02-22:
I have just installed a CM4 onto a (V1.0) M8P

I can SSH into the board just fine and have compiled the firmware.
When I use a SD card to first flash the firmware-usb.bin (renamed to firmware.bin) nothing happens.
I tried renaming the firmware-usb.bin to FIRMWARE.bin to no effect.

Further more when using the command : ls /dev/serial/by-id/* to list the MCU serial the responce is :
No such file or directory.

I have enabled the USB2.0 HUB in the config.txt
To check usb functionality I connected a SKR1.4 to the USB-A connection and running the command again it does find it
So the config.txt is edited Ok i think.
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

looxonline, 2023-02-26:
You may need to use the SWD interface to program the MCU.

looxonline, 2023-02-26:
Also, check that your OS is not dumping any hidden files onto your SD card. macOS does this sometimes and it messes with the bootloader.

QuinFromCanada, 2023-02-26:
Check what file system your SD card is formatted for.  I used a new SD card out of the box, and I didn't check and had the same issue.  after I formatted it to FAT32 it worked.

PSpiel, 2023-03-20:
Hello, Similar problem... though I had to find an old and smaller SD card (2GB) as my 32 GB new SD would not work.
Hope that helps others too.

Alexpanai, 2023-05-09:
I had the same issue. Defiantly a smaller card (not 64Gb as I tried for 2 days) formatted in FAT32 was the way to go. Strangely enough I didn't manage to format in FAT32 the bigger cards.

alex-crr, 2024-01-16:
I have a 2Gb FAT32 sd card, and it is still not working. When trying through DFU i have no serial Id created so I assume it is not working either. I have another board, MantaE3eZ for which it worked perfectly fine. Any more insights on how to solve?

manotroll, 2024-04-28:
I found the solution to the problem in a video on YouTube, I'll put it here so you can see
There is an error in the PDF explanation in the manual on how to do it
https://www.youtube.com/watch?v=k8DmTrY2GgY

DaveuRrr, 2025-03-30:
I am not sure if you are intending to use canbus but I was able to get it to work when flashing klipper at `0x08002000` address. I was using these instructions and as able to get my usb connection back `/dev/serial/by-id/`

[Manta M8P & BTT EBB SB22XX](https://forum.vorondesign.com/threads/manta-m8p-btt-ebb-sb22xx-setup.1697/)

Thread 43 (2023-02-22):

CB1 - Ethernet LAN port does not work

AChorostian, 2023-02-22:
Hi
I have a set Manta M8P + CB1.
Tried these images on CB1 from https://github.com/bigtreetech/CB1/releases
- 2.3.1 - Wifi works fine, USB A on Manta board also works - I have connected the USB camera and it's visible in web app. The Ethernet port doesn't work. LED is off
- 2.3.0 - only tried to install OS and see if ethernet works - the same situation, no Network, LED off
- 2.2.1 - only tried to install OS and see if ethernet works - same situation, no Network, LED off
- 2.2.1 Hurakan - only tried to install OS and see if ethernet works - same situation, no Network, LED off

Tried on PSU 24V and on VUSB
ifconfig gives me "lo" and "wlan0"

How to get Ethernet port working?

AChorostian, 2023-02-22:
related issue in CB1 repo:
https://github.com/bigtreetech/CB1/issues/32

AChorostian, 2023-05-07:
The issue with not working eth0 is fixed in 2.3.2

Closed 2023-05-07.

Thread 44 (2023-03-02):

Manta M8P v1.1 FAN4 Pin-Out error

ccfman2004, 2023-03-02:
"BIGTREETECH MANTA M8P V1.1 PinOut.png" lists two different Pin-Outs for FAN4. V1.0 has three 4-pin fan headers while v1.1 only has two. FAN4 in v1.1 is now a two pin header rather than the 4-pin in v1.0.

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

Thread 45 (2023-03-07):

Pinout Error Motor 8

BlackDiff, 2023-03-07:
M8 motor use PC6 for DIR pin, but this pin is already in use for RGB1 wiring, section 3.9.

I can use RGB wiring with PC6, but I don't know wich pin is it for M8 motor.

Closed 2023-03-07.

Thread 46 (2023-03-09):

Manta M9P 1.1 Motor 6 Direction?

RezezRX79, 2023-03-09:
I am having an issue with the manta M8p 1.1 card. I have been looking in to it and it and if you look at the board schematic it appears that stepper 6 is using a different component for its direction pin than all the other steppers. for now I just swapped the servo I was going to use on 6 to 8. If anyone can figure out the right pin call out (AKA PA14, PA15, PD15 or what ever) that would be great. It looks like M6DIR goes threw to SWCLK and that goes to pin PA14 But PA14 doesn't change the direction of the motor.
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

azhago, 2023-03-13:
Same issue here.
Sending a STEPPER_BUZZ stepper="the stepper on motor#6" : it goes only one way instead of changing direction at each buzz

12voltnick, 2023-03-14:
Same issue here! Just built a voron and have been banging my head against the wall trying to figure this out as m6 is my z3 stepper driver. WTF BTT this is bs.

12voltnick, 2023-03-15:
I think I figured it out! when I was doing the config for the stepper motors I was looking at a V1.0 pinout, but i have a V1.1 board. the pinouts are similar but not the same! and some of the pins are used for other things. Check your pinout version against your board version and this should give you the correct pin labels for step, direction, enable, and uart pins.

azhago, 2023-03-15:
Triple checked, i have 1.1 board and use 1.1 pinout.

sergelhr, 2023-03-23:
ran into same issue, klipper voron cfg error-->dir_pin: !PD15 instead !PA14 wtf

NAPCAL, 2023-04-01:
@sergelhr I just posted a pull request with a correct v1.1 Klipper cfg file.
[54](https://github.com/bigtreetech/Manta-M8P/pull/54)

Synapsis181, 2023-04-24:
I'm having the problem with Motor 8  using the  pin out I keep getting an error when i try a Stepper_buzz.
Can someone tell me the setting they used. Using with with RatOS.  Its not the first time, other had reported the same problem.

NAPCAL, 2023-04-24:
Is this what you have?

# Motor8
#[extruder3]
#step_pin: PD8
#dir_pin: PC6
#enable_pin: !PC7
#heater_pin: PE1 # HE3
#sensor_pin: PA4 # T3

Synapsis181, 2023-04-24:
Not at home right now have to check, i'm using it wth Rats as stepper Z2.

NAPCAL, 2023-04-24:
The v1.1 has different pin assignments for motors 6-8.

My sample M8P v1.1 cfg has been merged into BTT GitHub, you can find the correct pin assignments there.

Synapsis181, 2023-04-24:
I also have the V1.1, thanks i'll go take a look

Synapsis181, 2023-04-24:
Still cann't get it to work.  I have this as the base config
aliases:
# steppers
  x_step_pin=PE2,    x_dir_pin=PB4,    x_enable_pin=PC11,   x_uart_pin=PC10,   x_diag_pin=PF3,    x_endstop_pin=PF3,
  y_step_pin=PF12,   y_dir_pin=PF11,   y_enable_pin=PB3,    y_uart_pin=PF13,   y_diag_pin=PF4,    y_endstop_pin=PF4,
  z0_step_pin=PA10,  z0_dir_pin=PA14,  z0_enable_pin=PA15,  z0_uart_pin=PF8,   z0_diag_pin=null,
  z1_step_pin=PD11,  z1_dir_pin=PD9,  z1_enable_pin=PD15,  z1_uart_pin=PD14,  z1_diag_pin=null,
  z2_step_pin=PD8,  z2_dir_pin=PC6,   z2_enable_pin=PC7,   z2_uart_pin=PD10,   z2_diag_pin=null,
  # Voron 2.4 support
  #z3_step_pin=PC9,	 z3_dir_pin=PC8,	 z3_enable_pin=PD1,	  z3_uart_pin=PD0,   z3_diag_pin=null,
  e_step_pin=PD7,    e_dir_pin=PD6,    e_enable_pin=PF10,   e_uart_pin=PF9,    e_diag_pin=null,   e_heater_pin=PE3,  e_sensor_pin=PA1,
  stepper_spi_mosi_pin=PA7,  stepper_spi_miso_pin=PA6,  stepper_spi_sclk_pin=PA5,

Z2 is like you said above but when i do a stepper_buzz i get this error
"Unable to read tmc uart 'stepper_z2' register IFCNT"

looxonline, 2023-08-22:
@NAPCAL @azhago @sergelhr @RezezRX79 @12voltnick @Synapsis181

This issue was caused by the input voltage tolerance of one component connected to the 6th stepper driver being right on the edge of the 3V3 level that the MCU outputs. Some components accepted the level from the MCU and others did not.

If you guys have been affected by this issue then BTT would like to offer you a 15% compensation off the cost of your board. Please contact me using the "bttuniversity" handle on discord.

Thread 47 (2023-03-11):

CB1 light flashes and then turns off after printer is turned on.

Moosatronic, 2023-03-11:
have a new Manta M8p where the CB1 green light turns on for a sec upon turning on and then turns off (MCU being fine), but if i wait for a longer period before turning it on it stays on longer and then the MCU and CB1 lights begin flashing before the CB1 light goes out. Waiting overnight, turning on the Manta M8p resulted in a longer time the CB1 was active before turning off, the ACT light even flashing once before the CB1 lights turned off. Mostly just wondering if this might be something I can fix but I can't find this issue addressed anywhere.

Thread 48 (2023-03-13):

Neopixel do not work

MikeEitel, 2023-03-13:
I can't get any neopixel running on my mp8/cm4. Using klipper.
Rest works like a charm.

I defined both channels in printer.cfg with the probably correct pins. See them in the dashboard. There I can change colors. Also using macros change the color in dashboard.
But straps stay dark.
Measuring (both) dedicated pins with an oscilloscope shows no signal. Always stays ground.
Testing with a resistor to 5v doesn't show signal neither..

I'm wondering if there are wring pins in doc or I need special firmware.
Any ideas?

Thx in advance

MikeEitel, 2023-03-15:
Any idea?
Thx

qiyuanlu, 2023-04-29:
I have the same issue are you using an ebb2209 by any chance?

MikeEitel, 2023-04-29:
No
But I gave up to use neopixel.

As support from bigtreetech sucks

nineangel, 2023-06-06:
Double-check your word version. they changed PIN ID in v1.1
also make sure if led strip has lots of LEDs you need additional power connected in the middle or turn the brightest down. otherwise it draws too much current and shuts down the board.

ecob81, 2024-05-19:
Has anyone got this working yet? I can't for the life of me get neopixels working off the m8p. The toolhead neopixels work ok that are running off a Canbus board however there's nothing but darkness when trying to use the headers on the main board. Seems like the neopixel signal isn't even getting generated.

sajrashid, 2024-09-10:
I can't get Neopixels to work from RGB port (Voron [Daylight on a stick](https://www.aliexpress.com/item/1005005913975209.html?spm=a2g0o.order_list.order_list_main.65.794718023jJLQv))
first LED flashes for 0.2 seconds on boot or while changing colours from Klipper, I'm sure it's taunting me
Other than that no cigar 🚭 I'm afraid 😨.

Voltage is **OK**
GND is **OK**
Data - **no scope :(**

```
[neopixel my_RGB]
pin:PD15
chain count:18
color order: GRB
initial_RED: 0.2
initial_GREEN: 0.2
initial_BLUE: 0.2
```

@bigtreetech  help please ?

looxonline, 2024-09-10:
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

Some have reported that a series resistor helped them. Could be related to a long wiring path and that path needing a bit of damping due to parasitic inductance.

sajrashid, 2024-09-10:
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

Hi, Just tried 220K on the data line, exactly same behaviour I can make it flash for s fraction of sec while changing colour using the wheel in mainsail.

Seeing if I can find 100.

As for the wiring thing is I've tested from 1.5m of wire to less than 0.5m and nothing.

**Thankyou for the suggestion**

Contemplating, might just use an esp32 with moonraker 🤔

looxonline, 2024-09-11:
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

220k is way too high. You want something between 100 and 330ohms.

sajrashid, 2024-09-17:
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

Sorry, My bad I meant to write 220R - I also found a 100 ohm resistor no joy

This is what I have tried board is Manta M8p v2

- Inline resistor (data line) 220 and 100 ohms  😔
- Capacitor small value on the 5v line  😔
- 5v 6a SMPS with a shared ground 😔

I got to light up accidently as the ground was loose, but only about half lit up and did not respond to software changes (apart from a slight flicker)

So has the v2 gone backwards in the LED game

This whole thing  is suss - I mean if you sold an LED controller that did not work in how many situations ?

Thread 49 (2023-03-14):

ADXL on SPI1 will not allow boot

Tomadoggy, 2023-03-14:
With ADXL345 connected to SPI1 the board will not boot showing error: mcu 'mcu': unable to connect

Massive troubleshooting with Oliver Jean Eifler on the BTT Facebook but no resolution.  Lots of notes there to review.  If I attach ADXL after boot all works fine.  Others have this issue, believe it could be a bug somewhere.

Flavourdynamics, 2023-04-13:
I'm also experiencing this issue on v1.1.

Florian2406, 2023-08-07:
Sounds like the same issue as in #27
Is this a duplicate? Sadly there is no solution for the other issue either...

Thread 51 (2023-03-24):

Manta M8P TFT70 Touchscreen for Marlin

fiveorders, 2023-03-24:
Hi, We are trying to connect TFT70 on Manta M8P. We are using Marlin 2.1.bugfix firmware. Can somebody help? We couldn't find free RX and TX pins. Are we missing something or the Manta M8P is not compatible with TFT touchscreens by BTT?

Closed 2023-03-27.

Thread 52 (2023-03-26):

No power to CB1 VIA M8P Led on CB1. CB1 Powered and boots Via USB.

Zaskeller, 2023-03-26:
Having an issue where the CB1 will not boot via power from the M8p, M8P shows 12,5,3.3 volts are powered via the indication Led.

The CB1 does boot via USB and activates wifi and UI. but doesn't boot without USB power pass through. LED2 is powered on CB1 in both modes. there is also no LED for PIEFAN.

Zaskeller, 2023-03-26:
After Testing found that if the USB pass through for power is bridge then you turn on the M8P power, it will power the PIFAN pin once unplugged from the USB. this seems to jump start the board where power from just the m8p can't.

Zaskeller, 2023-03-26:
When Powering on the m8p the PIFAN pin may flash, and the pi will only boot when this led seems to be on.

dawesy72, 2023-12-20:
I have the same situation although I haven't tried booting from usb only yet.
Are you putting dip switch 3 or 4 to on or both. I've tried both as card slots too.

Thread 53 (2023-03-27):

Thermistor Reading Issues

Bingkokek, 2023-03-27:
I have connected working thermistors on the Manta M8P on THB and TH0 and they are reading 110.9 and 107.4 degrees even on off states (no heat applied). These work on my Octopus Pro 1.0 board. I don't know what is causing this issue.

Thread 55 (2023-04-06):

Latest (english) User Manual Pin-Out diagram is using old diagram

jpatrolla, 2023-04-06:
**Chapter 2.2** of the latest User Manual is using the old v1.0 Pin-Out Diagram. This threw me off and caused me hours of troubleshooting.

The diagrams within the /Hardware/ folder are correct, but are a bit hard to navigate if it's your first time upgrading and you don't know which board you have.

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

Thread 56 (2023-04-06):

Burn't Component Identification

S1L3NTANG3L, 2023-04-06:
Hi, does anyone know what the ic in the yellow block is called, I had my blower fan on fan4 die and it took that component with it, I'm hoping it is the only issue. I have a v1.0 board
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

S1L3NTANG3L, 2023-04-11:
Hi thanks for the reply sadly it is not, I blew out a tiny chip on the back of the board, although it might be worth checking U17 anyway.

Thread 57 (2023-04-06):

[Question] Manta M8p , CB1 and powering CB1.

cruzer619, 2023-04-06:
Is it possible to powerup the CB1 without power up the mainboard.  I'm used to having Pi on all the time.  So I can remote power up the printer via telegram or other remote tools and print remotely.  Is this possible.  I am aware of VUSB jumper but I have a feeling still powers the mainboard.

Roguyt, 2023-04-07:
I'm also interested in this option. It's a bit annoying to have to power off the PI and then power off the printer.

its-romo, 2023-05-26:
No there is no option to power the CB1 board separately from the mainboard, they are designed to be treated as a single component.

If you want to use the CB1 as a standalone device, you will need to purchase a PI4 Adapter from BTT or another vendor.

Thread 58 (2023-04-26):

Loss of power on m8p

Lazybones2319, 2023-04-26:
G’day all,
I recently got a mantra m8p with cb1 for my e5+ upgrade (overkill to the max) I managed to compile all the Pi os image and firmware for the boards got everything hooked up and began setting the config for my printer. Once I was done for the day I turned in went to bed with a smile on my face because everything was starting to work as it should. Well that smile turned to anger the next day when I switched the power back on for the printer and waited, waited a bit more then about 30 minutes later (after making a coffee and toast) I noticed the power LED near the hdmi plugs was non existent… in my mind I thought oh it must not have booted properly, so again off goes the switch and let it sit while I had a couple games of xdefiant and apex legends. Well switched it back on and waited 10 minutes…. Still…. No power to the mcu but everything else had power so I thought oh well I’ll jump onto my browser to open mainsail… nope nothing so I powered down the printer disconnect all the attached cables turned it back on and waited again with no luck….

rage boiled inside me as I’ve put so much effort into reviving this printer and making it how I want it. No harm came to any devices or printers unless you call running my ender 3v2 for a 29hr print harmful….

I have made multiple attempts to contact big tree tech now to try and find a solution or resolution of some sort… I may just be impatient as they haven’t responded yet.

my question is to the community, how many have experienced this or something similar? And what was the outcome as I don’t plan on spending money on another board (although it seems that may be the fastest way to get my printer operational again)

Rlinhos, 2024-02-26:
Did you find the solution? I'm having the same problem and the fuses are working perfectly. I'm desperate because I don't know what else I can do and the board is new.

dasboot58, 2024-08-08:
I have a similar issue... Yesterday, before I connected the extension cables to the rest of the machine, I was able to power up without issue. I am now getting only the 12V led. The board power led comes on briefly when first powered. If anyone has any advice, I would appreciate it. I am used to glass fuses, so if there is a particular board fuse I should check, I would appreciate the advice.

bigtreetech, 2024-08-08:
This can happen if both USB power and the main 24V power are applied to the board at the same time and the USB jumper is inserted. It would result in the two 5V supplies fighting it out and it could cause damage.

There are also other possible sources where damage could be caused but in general it would be from overloading the 5V regulator on the M8P. Other than the USB issue mentioned, it may also come from a wiring issue causing a short to GND or perhaps feeding another 5V source back into the M8P 5V rail.

dasboot58, 2025-02-07:
I was struggling with this for a while. I finally realized it was my end stops. The wiring my Ender 5+ (going from a SKR mini e3) required moving the contact in the “+5V” position to the “PF_” position.

Thread 59 (2023-05-02):

CSI port on underside of m8p

philgreenh22, 2023-05-02:
hi all

i have a manta M8P with CB1. i am trying to add a camera to it but as soon as the camera is inserted the board will not post.

i have searched for the /dev/video* but have no video folders to list.
i have searched for /dev/usb/by-id and only find the klipper mcu
i have searched  for /dev/serial/by-path but never find nything but the klipper mcu.
i have enabled legacy video in the bios

what have i missed???

please before i become completely bald....

any help appriciated

Phil
[klippy (3).log](https://github.com/bigtreetech/Manta-M8P/files/11376637/klippy.3.log)

looxonline, 2023-05-03:
The CB1 does not support CSI or DSI. Only USB cameras and HDMI/SPI displays are supported.

philgreenh22, 2023-05-04:
lol

shame i didnt see that before opting for a pnp solution.

at least i can chill now i know its not a me issue.

what is the point of including these ports i wonder?

thanx for the info. :)

Closed 2023-05-04.

Thread 60 (2023-05-05):

AS1117 wrong 5V

AdronTech, 2023-05-05:
Why is the 3v3 LDO AS1117 fused to the 5VIN net?
Should it not be that the LDO is fused to the 5V net?

Right now there is the problem:
If you connect 5V over USB it will take the following path to the MCU:
VBUS -> 5V -(reverse through efuse)-> 5VIN -> fuse -> LDO -> 3.3V -> STM32.
I think going backward through the efuse is not intended or good for the efuse.

(btw. the +5V net on the other side of the AS1117 fuse is not connected to anything)

Thread 61 (2023-05-16):

i2c

albielew, 2023-05-16:
Which pins support i2c?
I want to use a BDsensor that communicates using i2c and it's not in the manual

looxonline, 2023-06-05:
There is no i2c bus on the motherboard.

albielew, 2023-06-05:
There actually is, I've used it.
Took me ages to find it but it's there

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

looxonline, 2023-06-05:
> There actually is, I've used it. Took me ages to find it but it's there
> […](#)
> On Mon, 5 Jun 2023, 13:41 Luke, ***@***.***> wrote: There is no i2c bus on the motherboard. — Reply to this email directly, view it on GitHub <[#61 (comment)](https://github.com/bigtreetech/Manta-M8P/issues/61#issuecomment-1576717569)>, or unsubscribe <https://github.com/notifications/unsubscribe-auth/AM57WSLE2MXCMG4GU4LXRV3XJXHXNANCNFSM6AAAAAAYDGMVUU> . You are receiving this because you authored the thread.Message ID: ***@***.***>

There are a few options that could be used but none of them are intended for I2C. You would be hijacking another function.

real-artswan, 2025-03-07:
So, in the year 2025, on the Manta8P v2, how to use i2c? For example these pins from the official PDF?

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

What I've tried:
Looked in the klippy.log where I found

```
Loaded MCU 'mcu' 123 commands (v0.12.0-451-g730e5951b / gcc: (15:8-2019-q3-1+b1) 8.3.1 20190703 (release) [gcc-8-branch revision 273027] binutils: (2.35.2-2+14+b2) 2.35.2)
MCU 'mcu' config: ADC_MAX=4095 BUS_PINS_i2c1_PB6_PB7=PB6,PB7 BUS_PINS_i2c1_PB8_PB9=PB8,PB9 BUS_PINS_i2c2_PB10_PB11=PB10,PB11 BUS_PINS_i2c3_PA8_PC9=PA8,PC9 BUS_PINS_spi1=PA6,PA7,PA5 BUS_PINS_spi1a=PB4,PB5,PB3 BUS_PINS_spi2=PB14,PB15,PB13 BUS_PINS_spi2a=PC2,PC3,PB10 BUS_PINS_spi3a=PC11,PC12,PC10 BUS_PINS_spi4=PE13,PE14,PE12 BUS_PINS_spi5=PF8,PF9,PF7 BUS_PINS_spi5a=PH7,PF11,PH6 BUS_PINS_spi6=PG12,PG14,PG13 CANBUS_BRIDGE=1 CLOCK_FREQ=400000000 MCU=stm32h723xx PWM_MAX=255 RECEIVE_WINDOW=192 RESERVE_PINS_CAN=PD0,PD1 RESERVE_PINS_USB=PA11,PA12 RESERVE_PINS_crystal=PH0,PH1 STATS_SUMSQ_BASE=256 STEPPER_BOTH_EDGE=1
```

PA8 and PC9 looked like what I need so I tried config
```
[temperature_sensor chamber]
sensor_type: AHT10
#   Also use AHT10 for AHT20 and AHT21 sensors.
#i2c_address:
#   Default is 56 (0x38). Some AHT10 sensors give the option to use
#   57 (0x39) by moving a resistor.
i2c_mcu: mcu
i2c_bus: i2c3
#i2c_speed:
#   See the "common I2C settings" section for a description of the
#   above parameters.
#aht10_report_time:
#   Interval in seconds between readings. Default is 30, minimum is 5
```

i2c3 was not found by Klipper after reboot then I enabled it in the overlays via armbian-config and then system halted on boot almost all the time (~ 19 times from 20). So that I had to switch power until I got OS booted up and disabled that overlay.

real-artswan, 2025-03-07:
I also tried software i2c

```
[temperature_sensor chamber]
sensor_type: AHT10
#   Also use AHT10 for AHT20 and AHT21 sensors.
#i2c_address:
#   Default is 56 (0x38). Some AHT10 sensors give the option to use
#   57 (0x39) by moving a resistor.
i2c_mcu: mcu
# i2c_bus: i2c3_PA8_PC9
i2c_software_scl_pin: PA8
i2c_software_sda_pin: PC9
#i2c_speed:
#   See the "common I2C settings" section for a description of the
#   above parameters.
#aht10_report_time:
#   Interval in seconds between readings. Default is 30, minimum is 5
```

It seems no problem with booting but getting `MCU 'mcu' shutdown: I2C START NACK`

real-artswan, 2025-03-07:
Hm, it seems it was some connection issue, now it works with software i2c and you don't need any additional overlays.

oskarekxy, 2025-04-05:
@albielew Which pins did you use exactly? I have a Manta M8P V1.1. Did you take the pins from EXP1/2 or the display connector

Thread 62 (2023-05-19):

M8P - SPI mode - TMC5160 (Mellow external)

surikatec, 2023-05-19:
Hello guys,

why for me didn't work HW SPI mode pro TMC5160 (Mellow external)? Jumpers on motherboard have correctly. Works only SW SPI.

I had a version M8P 1.0, changed for 1.1 and still didn't work as I wish. :(
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

Thanks.

Michil783, 2023-06-08:
Have the same issue with TMC2130. SW SPI is working but nor with spi-bus parameter in config set to spi1

BR Michael

staticanime, 2023-09-08:
Try the below, that got 5160's working for me over SPI:
```
[tmc5160 stepper_x]
cs_pin: PF13
# spi_bus: spi1
spi_software_sclk_pin: PA5
spi_software_mosi_pin: PA7
spi_software_miso_pin: PA6
```

Thread 64 (2023-05-25):

USB C not working

rrgmaly, 2023-05-25:
When I hook up the HDMI7 to either of the USB 2.0 ports the HDMI unit works fine, If I connect it to the USB C port nothing happens (the jumper is off, btw), the USB C port also does not seem to have any power going out.  Is there a setting for the USB C port that I am missing or is the USB C port only for power in?  This is on a Manta MP8 v 1.1.

its-romo, 2023-05-26:
Try adding this line to the `/boot/config.txt` file

`dtoverlay=dwc2,dr_mode=host`

Let me know if it helps :)

rrgmaly, 2023-05-26:
Already added it after flashing the board.  The two USB 2.0 are working, it is only the USB C that is not working.

rrgmaly, 2023-06-07:
After some research, it appears that the USB C port is only for power and EEPROM flashing.

freakydude, 2025-03-04:
Tried it today on M8P V2.0 to connect my webcam - but as you said - it's not working for me either 👎🏼

looxonline, 2025-03-04:
The USB-C port is only for flashing the CB/CM and for serial debug. This information is available in the manual. USB-A ports are for peripherals.

Closed 2025-03-04.

Thread 65 (2023-06-08):

Using HDMI1 instead of HDMI0

Wakinyantanka, 2023-06-08:
How do you use HDMI1 for the touchscreen? Accidentally broke HDMI0 and would like to switch. When I plug into HDMI1 nothing happens.

Wakinyantanka, 2023-06-10:
So I emailed Bigtreetech technical support with this and according to them HDMI1 can only be used with the raspberry pi board. The CB1 is not able to utilize it. If anyone else has this happen you have to get another board.

Wakinyantanka, 2023-06-10:
Closing

Closed 2023-06-10.

Thread 66 (2023-06-08):

Camera using CSI let's CB1 stop working

Michil783, 2023-06-08:
Hello,

as soon as I have a camera connected to the ribbon caböe on the CSI port of the M8P board, the power LED on CB1 is off and CB1 isn't working anymore. If I unplugg the camera (ribbon caböe is still connected on the board, CB1 is starting normally.

Anything I made wrong?

Kind regards
Michael

idontknowtom, 2023-06-20:
@Michil783 The CB1 is not compatible with CSI port connected cameras. Same with DSI port and DSI displays.

Thread 67 (2023-06-09):

OS Intermittently Freezing and Corrupting SD Card

420noscope-exe, 2023-06-09:
I have a manta M8P mainboard with a CB1 installed onto it, running the provided klipper image.  I always leave my machine idling, powered on at all times.  Randomly, after about a week of idling, the web interface crashes.  I am unable to access it at all.
 I cannot ssh into the device either.  The only solution is to unplug the printer and plug it back it.  This has a high probability of corrupting my SD card, and I've had to re-image it about 4 times now.  Where do I start with this?

Peoplles, 2025-09-26:
Hello, I am having the same issue except it's daily.  What solution did you arrive at?

Closed 2023-06-13.

Thread 68 (2023-07-03):

Dead USB Hub

timmit99, 2023-07-03:
# USB Hub dead

## Hardware:
- BTT M8P
- Raspberry Pi CM4 2GB ram, 32GB eMMC
- Voron 2.4 printer

## Issue:
* M8P's onboard USB hub has died 48 hours after unboxing.

# Diagnosis:
I was going through my initial setup, had gotten the boards serial number for klipper, as well as another board via `lsusb` and `ls /dev/serial/by-id/*` and all was working fine. All of the sudden, after a `FIRMWARE_RESTART` to update a config value, the MCU couldn't connect.

Sure enough, upon further evaluation, LSUSB returned only a single item, the Linux root hub. It no longer saw the onboard Hub IC or thee camera/controllers connected to the board:
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

To check if the CM4 was damaged or the M8P, i powered down and swapped the CM4 over to my BTT PAD5 and sure enough, there, it detected all the devices plugged in:
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

This shows that the CM4 is working as intended and is not the issue. Inspection of the board shows no signs of damaged chips, burnt parts, lifted traces, etc.

looxonline, 2023-07-03:
First time I am hearing of this. I will skim through the schematic to see if there is anything that may have caused it.

timmit99, 2023-07-03:
Thanks, let me know what you want me to do for testing. Happy to try and diagnose this issue. I've done visual inspection with no obvious signs of damage and can upload more photos tonight.

timmit99, 2023-07-03:
## Board Overview Top
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
## CM4 Area Top
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
## CM4 Overview Bottom
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
## USB Hub IC
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

The USB Hub IC looks suspicious.

Twdiap, 2023-11-08:
I have the same problem, BTT told me the board is dead and refuse warranty...

looxonline, 2024-07-04:
> I have the same problem, BTT told me the board is dead and refuse warranty...

Hey there! I have just been speaking to timmit about this and I thought that I would come and search to see if anyone else was having this issue and I found you. I would like to offer to replace your M8P if you are still in possession of it and can show me the lsusb results. Please send me a mail at luke@bigtree-tech.com if you would like to take me up on the offer.

pokeygithub, 2024-07-28:
My problem is slightly different.  Mine is missing the 5vDC  On the usb ports.

Thread 69 (2023-07-06):

User Manual does not properly show HV input select for stepper motors

eightheads, 2023-07-06:
Section 3.2.5 of Pg 15 of the BIGTREETECH MANTA M8P V1.0&V1.1 User Manual.pdf does not properly show how to select the high voltage "Motor Power" input for each stepper driver. The 2 images seem to be duplicated and no description is given. Please reference a similar section of the Octopus Pro manual for a better example.

Thread 70 (2023-07-08):

Network issues. Cb1 v2.2. Ratos

marcged, 2023-07-08:
Hi there. I've had no trouble up until I had to turn the power off to my garage. Now when I turn my printer in, it connects to the network but it doesn't allow me to do anything. I can't access the web interface, I can't Ssh into it either. Ethernet or usb wifi dongles don't make a difference either. Is this a cb1 issue or a ratos issue?

Thanks,
Marc.

pOmelchenko, 2023-07-19:
>  Is this a cb1 issue or a ratos issue?

Did you try to connect directly to the motherboard? Do you have CB1 PI4B Adapter to check problems with M8P?

marcged, 2023-07-19:
>

So, It turns out my board has a loose sd card holder. It must have got corrupt because I cannot view any files (printer.cfg etc) in the sd card when  I try and read from it. I can access the system portion but not the part that stores cfg files. I just reflashed the board. I lost 3k hours of printing history but all I care about is I didn't need to buy another board.

pOmelchenko, 2023-07-21:
I use cb1 with flashed OS onto emmc so I forgot about sd cards, sorry

Thread 71 (2023-07-08):

DSI and CSI not working at the same time

Peviox, 2023-07-08:
im using my M8P with a CM4 4gb ram and 8gb eMMC with a PITFT 2.0 with DSI and a cheap raspicam over CSI.
If i connect the display alone it works fine and displays stuff. If i connect the camera as well, the camera works but the display stops displaying or reading touchinput, not even teh backlight turns on.
i installed the DSI driver according to the instruction.

waht could be the problem and solution here?

Pippowicz, 2023-08-26:
The same for me,

CM4, 8GB, 32Gb EMMC, no WiFi

hadesz, 2023-10-08:
I have the same problem. I can confirm, there's an i2c error in system log...

Tuxedo-VE, 2025-01-20:
I had the same problem. This is caused by an error in the schematic: the pin assignments for the 15-pin DSI header on the Manta are inverted when compared to the normal pin assignments on a Raspberry Pi's CSI header. Because of this, you cannot use the 15 conductor Type 2 FFC flat cable that comes with the Pi CAM module (exposed contacts are on opposite sides of the flat cable). You must use a Type 1 FFC cable with exposed contacts on the same side of the cable.

Tuxedo-VE, 2025-01-24:
> Yes, you are right, found the solution too b ut forgot to post.
>
> Type 1 FFC Cables are difficult to get, so have fun finding one :(

Ever heard of Amazon? I'm looking at one right now...
https://www.amazon.com/uxcell-Flexible-Cable-Ribbon-Player/dp/B07RWRX6YT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

hazama6, 2025-04-11:
You may not need a new cable. The m8p V2.0 has a connector that works both ways. Try flipping it and do a continuity tests with a multimeter

Pippowicz, 2025-04-11:
@Tuxedo-VE: You DO realize my Post is from one year ago AND i am from Germany so no luck here.

Either way it is a poor Design Decision from Bigtreetech.

Tuxedo-VE, 2025-04-11:
> You may not need a new cable. The m8p V2.0 has a connector that works both ways. Try flipping it and do a continuity tests with a multimeter

Thanks for the tip. I wish I had known that while I was building my printer. BTT should have mentioned this in their manual. That was a while ago... I bought and installed a reversed flat cable and everything works fine. It's no big deal though, the cable wasn't expensive. I'm just happy I didn't fry the CSI port on my Manta while hooking it up with reversed connections.

bigtreetech, 2025-04-11:
Sorry about this guys. We will update the manual to make mention of the reversible connector.

hazama6, 2025-04-18:
> > You may not need a new cable. The m8p V2.0 has a connector that works both ways. Try flipping it and do a continuity tests with a multimeter
>
> Thanks for the tip. I wish I had known that while I was building my printer. BTT should have mentioned this in their manual. That was a while ago... I bought and installed a reversed flat cable and everything works fine. It's no big deal though, the cable wasn't expensive. I'm just happy I didn't fry the CSI port on my Manta while hooking it up with reversed connections.

Had the same concern. Thought i had fried the port. Managed to ge things working eventually though

Thread 73 (2023-07-19):

Board/CB1 diagnostic?

Pleslin, 2023-07-19:
I just got a CB1 emmc, and I am unable to boot the combination CB1+M8P, is there a way to understand which is falty?
the 12V let is off, power supply is 24V, I tried connecting with USB power, and no result at all, led next to Reset button flash on start, and then stays off?
Also I've got TMC2240 motor driver, are they compatible with the m8p, preparing the configuration, I couldn't find support for those drivers??

thanks for your assistance.

Pleslin, 2023-07-23:
My bad, the SD card was corrupted, I flash the emmc, and all was fine.

Closed 2023-07-23.

Thread 74 (2023-07-21):

Sensitivity of 2209 sensorless homing

deonkretch, 2023-07-21:
Configuring sensorless homing on a trident with M8P + CM1 + SB2209.

During the setup of the sensorless homing I go through the recommended process to start the test by setting the sensitivity to max (255). In the manuals the toolhead should stop immediately, but in my case it keeps moving and slams into the side of the gantry.

This is the command:

`SET_TMC_FIELD FIELD=SGTHRS STEPPER=stepper_x VALUE=255`
followed by:
`G28 X0`

Printer config:

`#####################################################################
#   X/Y Stepper Settings
#####################################################################

##  B Stepper - Left
##  Connected to M1

[stepper_x]
step_pin: PE2
dir_pin: !PB4
enable_pin: !PC11
microsteps: 16
rotation_distance: 40
# endstop_pin: ^PA3
endstop_pin: tmc2209_stepper_x:virtual_endstop
position_endstop: 0
position_max: 235
position_min: 0
homing_speed: 40 #Max 100

homing_retract_dist: 0
homing_positive_dir: false

[tmc2209 stepper_x] #M1
uart_pin: PC10
diag_pin: ^!PA3
driver_SGTHRS: 255
run_current: 0.650
stealthchop_threshold: 999999`

Pins are bridged on the board as indicated in the BTT Manual to enable sensorless homing.

Any suggestions?

heemanshoe, 2023-09-11:
Did you figure this out? I am running into the same issue with tmc5160 (I am using SPI instead of UART though)

deonkretch, 2023-09-12:
I decided to use normal end-stop switches for this build.

suprchunk, 2024-06-10:
"driver_SGTHRS: 255"

Try a LOT LOWER, like 127, and adjust from there. 255 is the supposed most sensitive.

Thread 75 (2023-07-21):

U2C needed with M8P ?

Kostt3d, 2023-07-21:
Hi,
u2c is needed to configure the ebb42 can with manta m8p? i can plug the ebb to my laptop with usb c and finish install with port can on the manta ?

rbentoski2113, 2023-07-29:
yes for version 1.0 m8p at least, thats what i got. the 1.1 has a can header in the middle of the board.   the u 2 c is a pretty straight foward set up, highly recomend going with canboot.  currently my set up is m8p w cb1, u2c, with the fystec PITB(double 5160 can board) on one port and EBB36 on the other and it was simple to set up. i belive if i wanted to i can add like 2 more , also good thing about can is you can daisy chain if they have the ports on it, e.g PITB board

Thread 76 (2023-07-22):

BLTOUCH problem + motherboard + CB1 boot with it connected

sunnydrake, 2023-07-22:
I connected CREALITY CRTOUCH correctly - probe trying to pass tests but fail
Randomly it fails even to boot on 24V PSU not even trying to boot CB1 ...  as soon as i remove pins or place them incorrectly all boots ok
wiring is from bottom to top - 3(PWM,+5V,GND)control+2(GND,+)sensor.
Also TBB is only socket to read correctly heater trmistor for some reason. bed thermistor is on TB0

Thread 77 (2023-07-29):

new controlerboard BTT Manta M8P - non of the fans are working

kurtdj, 2023-07-29:
Hello,

After a lot of struggle, I got Klipper up and running, but none of the fans are working.

I have FAN0 (cooling parts) and FAN1 (heatsink) connected, and also FAN6 for controller-board cooling.
I’ve tested all fans externally and they are all working fine.  The jumpers are set correctly (24v) on the board.
When I connect a fan to the connector MOTOR FAN on the board (next to stepper motor connectors) the fan works, but is not controllable of course. Maybe for the fan for the heatsink I can use, but not the fan for cooling part, which needs to be controllable.
So the fans are working but it seems that the whole fan controller system on the new board is not working at all.  Non of the connectors are giving power (tested it wich a multi-meter).
Maybe a broken fuse?  I also tried switching the fuses and also replaced them with new ones so it's not that either.
I’ve just bought the controller board in April, received it in May, and now had the time to install it.
Anyone know what to do?
@bigtreetech --> can you help?

I also noticed that (in the corner) only the LED of 3.3v and 12v is on, and NOT the one of 24v.

Many thanks
Kind Regards
Kurt

kurtdj, 2023-07-29:
Checked my board and I noticed this (see attachments)
Could this be the reason that none of the fans are NOT working?

@bigtreetech --> please let me know what the next steps are!

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

Thread 78 (2023-09-13):

CB1: '/dev/serial/by-path/': No such file or directory

Morogorn, 2023-09-13:
**I lost serial connection.**

root@BTT-CB1:/home/biqu/klipper# ls /dev/serial/by-path/
ls: cannot access '/dev/serial/by-path/': No such file or directory

---
wget https://github.com/bigtreetech/Manta-M8P/blob/master/V1.0_V1.1/Firmware/M8P_bootloader.bin

dfu-util -d ,0483:df11 -R -a 0 -s 0x8000000:leave -D ./M8P_bootloader.bin

**Does not work**
---
**After click button [boot] + [reboot]:**
root@BTT-CB1:/home/biqu/klipper# dfu-util -d ,0483:df11 -R -a 0 -s 0x8000000:leave -D ./M8P_bootloader.bin
dfu-util 0.9

Copyright 2005-2009 Weston Schmidt, Harald Welte and OpenMoko Inc.
Copyright 2010-2016 Tormod Volden and Stefan Schmidt
This program is Free Software and has ABSOLUTELY NO WARRANTY
Please report bugs to http://sourceforge.net/p/dfu-util/tickets/

dfu-util: Invalid DFU suffix signature
dfu-util: A valid DFU suffix will be required in a future dfu-util release!!!
Opening DFU capable USB device...
ID 0483:df11
Run-time device DFU version 011a
Claiming USB DFU Interface...
Setting Alternate Setting #0 ...
Determining device status: state = dfuIDLE, status = 0
dfuIDLE, continuing
DFU mode device DFU version 011a
Device returned transfer size 1024
DfuSe interface name: "Internal Flash   "
Downloading to address = 0x08000000, size = 5045
Download        [=========================] 100%         5045 bytes
Download done.
File downloaded successfully
dfu-util: Error during download get_status
root@BTT-CB1:/home/biqu/klipper#
---
**Device "0483:df11" apears.**

root@BTT-CB1:/tmp# lsusb
Bus 008 Device 001: ID 1d6b:0001 Linux Foundation 1.1 root hub
Bus 004 Device 001: ID 1d6b:0002 Linux Foundation 2.0 root hub
Bus 007 Device 001: ID 1d6b:0001 Linux Foundation 1.1 root hub
Bus 003 Device 001: ID 1d6b:0002 Linux Foundation 2.0 root hub
Bus 006 Device 001: ID 1d6b:0001 Linux Foundation 1.1 root hub
Bus 002 Device 001: ID 1d6b:0002 Linux Foundation 2.0 root hub
Bus 005 Device 001: ID 1d6b:0001 Linux Foundation 1.1 root hub
_Bus 001 Device 003: ID 0483:df11 STMicroelectronics STM Device in DFU Mode_
Bus 001 Device 002: ID 1a40:0101 Terminus Technology Inc. Hub
Bus 001 Device 001: ID 1d6b:0002 Linux Foundation 2.0 root hub
-----

But, if reset:
"0483:df11 STMicroelectronics STM Device in DFU Mode" disapear.

@bigtreetech , how solve this?

Fionoz, 2024-03-18:
Any solution?

charchess, 2024-03-18:
Hi,

I had the exact same issue, they made me flash with the ST link and it went away

Regards

Morogorn, 2024-04-22:
> Hi,
>
> I had the exact same issue, they made me flash with the ST link and it solved the issue

Can share the link or procedure?

charchess, 2024-04-22:
[M8PV2 How to upate bootloader with ST LINK.docx](https://github.com/bigtreetech/Manta-M8P/files/15063599/M8PV2.How.to.upate.bootloader.with.ST.LINK.docx)

Here is the procedure they send me, hope it'll help

barrymathes, 2024-07-12:
@charchess   I looked at that doc but it doesn't show what the matching pin connections are between the board and the ST-Link?  i list the ones on the ST-Link but the wire colors don't match in the other pic and Biqu doesn't list the pins in the pinout description on any of their documents.

Thread 79 (2023-09-13):

Multiple EBBs for extruders

Infanticide0, 2023-09-13:
Hello, is possible to connect EBB board for each Extruder or only one can be used? I'm building custom multicolor printer.

I'm using M8P v1.1 with RPi CM4 module running Klipper.

olivbd, 2023-12-22:
Yes you can use multiple EBB boards.

CAN is a serial bus, you can connect multiple devices with a single cable. But the first and last device should have a 120R jumper shorted.

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

Thread 81 (2023-09-18):

RGB1 & RGB2: poor signal performance

MaffooClock, 2023-09-18:
I started with a Manta M8P v1.0 a year ago and had issues driving a 63-LED strip of SK6812 LEDs (RGBW).  The first 20 or so would illuminate as expected, but the LEDs after that would either not illuminate, or have the wrong color, or not turn off, etc.

I checked the wiring and everything seemed perfect -- 0.15Ω end-to-end on all three conductors.

I even opted to drive the LED strips with an external 5V power supply just in case the +5V in the RGB1/RGB2 headers wasn't able to supply enough power.  Of course, the negative from the external power supply was bonded to the GND in RGB1/RGB2 headers (so +5V in those headers was not used, only PA9/PB15 signal and GND).  No difference -- I had 5V all the way at the end of the run.

I put an oscilloscope onto the data lines and sent a pattern to sequentially illuminate one LED at a time at 30fps, and here's what I saw:

#### Channel 1 is connected at the RGB1/RGB2 header, Channel 2 is connected at the end of the wire, just before the LED strip:
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

As you can see, the signals are almost identical; the peak-to-peak is about 5V, as expected so this seems to prove that my wiring is fine.

#### Channel 1 is connected at the RGB1/RGB2 header, Channel 2 is connected after the last working LED in the strip (roughly 20 LEDs down the strip):
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

As shown here, the signal degrades to almost nothing.

As a test, I also tried wiring a strip of the SK6812 LEDs _still on the spool_ directly to the RGB1 and RGB2 headers and got exactly the same behavior!  So it's not the LED strip I'm using, and it's not the wiring.  Why does the signal look correct at the beginning of the LED strip, but then quickly degrades as it passes through each LED?

---

As a workaround, I abandoned the RGB1/RGB2 headers and loaded Klipper onto a [Seeed XIAO](https://www.seeedstudio.com/Seeeduino-XIAO-Arduino-Microcontroller-SAMD21-Cortex-M0+-p-4426.html) with a 3.3V-to-5V level shifter to drive my SK6812 LED strip, and it works perfectly -- same wiring and power supply.

As I said at the beginning, all of this was a year ago.  Fast-forward to today...

A couple of weeks ago, I wanted to implement CAN bus for my toolhead.  I quickly found out that my Manta M8P v1.0 did not support CAN, so I purchased a new v1.1 board that does.  Since I had the printer opened and disassembled anyway, and since I have a new board, I decided to test the RGB1/RGB2 headers again on the new board -- maybe my old v1.0 board was damaged or had some other problem?

Nope -- exactly the same behavior with the RGB ports on the v1.1 as the v1.0 Manta M8P.

---

Looking at [the schematics](https://github.com/bigtreetech/Manta-M8P/blob/1da6c13ace33dad1b21819599fafb4fe0e0d1c69/V1.0_V1.1/Hardware/BIGTREETECH%20MANTA%20M8P%20V1.1-SCH.pdf), I see the RGB ports are driven with a 74LVC1G17 Schmitt-trigger buffer, which seems like a clever way of converting the STM32's 3.3v output to a proper 5V signal while also ensuring a clean digital signal.

However, that's a generic part number, so I don't know which manufacturer's IC you actually used -- especially since the schematics show the use of a OE pin (output enable?) that none of the datasheets I looked at (TI, Nexperia, Diodes Incorporated, or NXP) described.  Since I don't know exactly which 74LVC1G17 is being used, I can't look up the timing characteristics for it.

The solution I used (with the dedicated XIAO board and the level shifter), the level shifter I used contains [BSS138](https://www.onsemi.com/pdf/datasheet/bss138-d.pdf) MOSFETs instead of the Schmitt-trigger buffer used on the Manta.

### So, here's the question:

Is the 74LVC1G17 the problem?  I'm using SK6812 LEDs (32-bit RGBW) instead of WS2812 (24-bit RGB), but that shouldn't matter (I don't have any WS2812 to test with).  In other words, why can I drive the same chain of LEDs with a different MCU perfectly fine, but the Manta M8P cannot?

mrstone14, 2023-10-30:
I am also having the same issue using my Disco on a Stick XXLs (WS2812B's) on RGB1/RGB2.  I have tested these to be working fine using WLED and esp32 devices running the same effects.  No oscilloscope to confirm either, unfortunately.

dotorg, 2023-10-31:
FWIW, this is normal behavior for WS2812B chips. Its why larger installations with them inject power every 50-60 LEDs. The chip uses VCC to produce the output signal, and voltage drops quickly, between high resistance in the strip and a general lack of available current in power supplies. The result is a color shift towards red, as the blue and green LEDs need more current, and eventually you get signal issues as the control chip doesn't have enough voltage left to keep the required level differentials at the next chip down the line.  WS2812B-5050s use about 60ma per LED at full brightness, so you're already at 5 amps when you get to 50.   RGBW LEDs are 80ma per, so the problem is 33% worse.

Given 5 amps is more than the Manta can provide, that's why you're getting drop-outs at around that point.

The controller chips in the LED are store-and-forward, so none of the signals you see past the first chip are coming from the Manta, they're coming from the previous chip. (You can see that if you run a 3.3V DIN to a WS2812B -- DOUT is re-transmitted at 5V)

MaffooClock, 2023-11-01:
> this is normal behavior for WS2812B chips

False.

Two of us have stated that we're using external power supplies.  The only connection between the Manta and the LED strip, then, are signal and ground (and the LED strip ground is bonded with the ground on the external 5V power supply, of course).

When we move that LED strip from the Manta to a separate MCU, but _changed nothing else_ -- same external 5V power supply, same wiring, same everything -- the entire LED strip works just fine.

> The controller chips in the LED are store-and-forward, so none of the signals you see past the first chip are coming from the Manta, they're coming from the previous chip.

Correct.

So it doesn't make sense that after the first 20 LEDs that the signal degrades like it does as shown in the second photo of my original post (still using the external power supply).  But then when I move the LED strip from the Manta to the external MCU, the signal out from each LED is perfect all the way to the end.  This makes me think there's something funky with using the 74LVC1G17 to drive the NeoPixel signaling.

> WS2812B-5050s use about 60ma per LED at full brightness, so you're already at 5 amps when you get to 50. RGBW LEDs are 80ma per, so the problem is 33% worse.

My SK6812's (which are RGBW) are supposedly 0.3W at full 4-color brightness, so that's 60mA each.  My run of 63 LEDs then only draws 3.78A.

My power supply is a [Mean Well RS-25-5](https://www.meanwell.com/Upload/PDF/RS-25/RS-25-SPEC.PDF), which can supply 5A @ 5V, so it's enough to drive my SK6812.

If they were 0.4W as you professed, then yes, that string would be pushing it on that power supply (5.04A), but I _rarely_ drive them at full color/brightness anyway (so I'm probably only pulling a couple amps when my chamber is just red @ 80% brightness, for instance).

But again, this is still off-point, as we've made it fairly clear that everything works fine when using an external MCU instead of the Manta, all other aspects being the same.

irebane, 2023-11-18:
Having exactly the same issue with chain of 42 SK6812 LEDs, noticed that it's not working specifically when I am printing. When printer is 1st booted all seems to be working fine. Tried both power from LED 1 or 2 headers or with external PSU.

anthobreizh, 2023-12-09:
Hi everyone,
 I have exactly the same problem on a MANTA M8P V1.2 with SK6812 and WS2812B leds.

irebane, 2023-12-09:
It would be very nice if BTT engineers could share some information and release instruction for hardware fix or modification that we can make in order to fix this problem. I personally have 0 issues to get it done myself as it's better than having not working feature.

NegussugeN, 2023-12-20:
Just chiming in to say I believe I'm experiencing the same issue, except I'm only using 18 led Disco Sticks. It works fine about 80% of the time when switching colors, but that other 20% will have the last 3-5 LEDs in the chain turn a random color.

Foose83, 2023-12-22:
J'ai également le même problème avec ma manta M8P v1.1. Problème que je n'avais pas avec ma carte Octopus v1.1.

ajaytanna, 2024-02-19:
Can the LEDs be connected to any other spare available output port on the Manta M8P V1. for expected reliable operation?

irebane, 2024-02-19:
> Can the LEDs be connected to any other spare available output port on the Manta M8P V1. for expected reliable operation?

I have tried other headers same result.

NegussugeN, 2024-02-19:
> Can the LEDs be connected to any other spare available output port on the Manta M8P V1.1 for expected reliable operation?

I tried this as well with the same exact result.  I ended up abandoning the RGB ports on my M8P v1.1 and started handling it all through a klipper expander, which works flawlessly.

ajaytanna, 2024-02-19:
What's a Klipper expander please?

NegussugeN, 2024-02-19:
> What's a Klipper expander please?

http://lmgtfy2.com/?q=Klipper+expander

ajaytanna, 2024-02-19:
Just couldn't resist could you? I realised soon after I typed but I before I could clean the grease off my hands you had made the killing. Thanks for the suggestion, but I will try something simpler and report back if it works.

NegussugeN, 2024-02-19:
> Just couldn't resist could you? I realised soon after I typed but before I could clean the grease off my hands you had made the killing. Thanks for the suggestion, but I will try something simpler and report back if it works.

I couldn't. 😂 I've been using the expander board for about a month and have had zero issues. They're super cheap and only take about 5 minutes to set up. Hardest part is figuring out where to mount it.  So if all else fails, I'd say to give one a try.

Vazs, 2024-02-19:
M8P v2 has the same 74LVC1G17 shifter and I had the same problem with it, first LED worked completely randomly, it didn't even count in the chain, and the rest of the leds worked with wrong color order, like the first part of the signal get lost somewhere. A simple 220ohm resistor in the data line right after the board solved it.

irebane, 2024-02-20:
> M8P v2 has the same 74LVC1G17 shifter and I had the same problem with it, first LED worked completely randomly, it didn't even count in the chain, and the rest of the leds worked with wrong color order, like the first part of the signal get lost somewhere. A simple 220ohm resistor in the data line right after the board solved it.

Tried it, didn't' worked for me on M8P v1.1

NegussugeN, 2024-02-20:
> M8P v2 has the same 74LVC1G17 shifter and I had the same problem with it, first LED worked completely randomly, it didn't even count in the chain, and the rest of the leds worked with wrong color order, like the first part of the signal get lost somewhere. A simple 220ohm resistor in the data line right after the board solved it.

Same for me. I tried about half a dozen values from 100ohms to 1.4k ohms on both ends of the data line and the result was the same. :(

Foose83, 2024-02-26:
Comment avez vous alimenté le klipper extendeur?
5 volt ou 24v? J'ai alimenté le mien en 5 volt et je n'ai que 16 LEDs sur 60 qui s'allume. Alimentation meanwell 5v.

oMTEo, 2024-03-18:
Also I have the same LED-Port-Bug and Im very frustrated about it :( Searching for some solutions since days....

ajaytanna, 2024-03-31:
Yesterday I connected a 19 element RGBW SK6825 strip to the manta m8p v1.1 rgb port 1. Worked as expected using julian schill's guthub as a guide. No issues so far. Planning to do 2 of these strips. Will report how that goes.

bigtreetech, 2024-04-03:
It seems that there are different issues being reported:

1.) Signal fails after a particular number of LEDs. This can be a certain number when not printing and this number may reduce when printing starts.
2.) Signal is not output correctly into the first LED and LEDs after the first work but are not the right colour.
3.) Some users don't have any LEDs working at all.

1.) The OP is experiencing point 1 and so are many others. This is a limitation of the CPU being used on any given board. The protocol used for RGB LEDs is bit banged. This means that each bit is manually timed within the MCU and then the IO is toggled. Each new LED in the chain requires 24 new bits which in turn requires 48 new IO transitions. All transitions must take place within one main loop of the klipper cycle on the MCU. The MCU on a motherboard is a very busy one. It must handle all stepper signalling, temperature sampling and control and all other functions being driven from the board. Much of these functions should happen once within every single execution of the main loop within klipper. This leaves only a limited amount of resources available for manual bit banging of an IO. When the LED strip turns off after a certain number it is because the maximum number of LEDs that are supported by the CPU has been reached. This is also why a user reported that this number would vary based on whether or not he was printing (CPU load varies). When the OP saw the signal dying it was because there was simply nothing left to relay by the last LED. The chain that was output by the MCU had ended. Note that the signal at the final LED will not match that at the start of the chain because each LED slices off what it needs and then buffers and repeats the remaining bits. This causes a 1 LED (24 bits x bitrate) delay in the signal after each LED. Expansion boards that are not handling much config at all will be able to handle a far greater number of LEDs.

TLDR for point 1: If you are limiting after a certain number of LEDs then that is simply the max that the CPU can handle with your config.

2.) If the first LED is giving an error and the rest are showing wrong colours then it means that there are bit errors when passing the signal to the first LED. If you look at the scope signals from the OP you will notice that ringing has appeared on the LED end of the signal after it travels through the harness. Ringing is an effect caused by parasitic inductance and capacitance that appears on the harness. With too much ringing, the bits can become so distorted that the first LED in the chain cannot even understand them properly. A series resistor acts as a damper and reduces ringing which is why this has worked for some people. To reduce parasitic components you must ensure that the wire path is as short as possible with no coils in the wire and that you are not running the wire in parallel with other noisy wires such as motor wires for long distances.

3.) For users who can get no output at all from the LED strip, ensure that you are not using too many LEDs in the chain (remember that there is a limit of about 50 LEDs if you are powering from the M8P and this limit reduces further if you are also using the M8P to power any other external, high current devices). Also check your config and check the LED strip (test using another, shorter strip if you have one). If you still cannot get any output at all then we recommend that you open a ticket using the ticketing tool on the website or send an email to the support email address listed on the website.

MaffooClock, 2024-04-03:
> 1.) The OP is experiencing point 1 and so are many others. This is a limitation of the CPU being used on any given board.

This behavior was observed on an idle system -- all motors off, all fans off, no heaters -- nothing active except LEDs.

> The MCU on a motherboard is a very busy one... This leaves only a limited amount of resources available for manual bit banging of an IO.

You're saying a 64MHz STM32 on the Manta M8P v1.1 can't run more than about 20 LEDs while otherwise idle?  [Someone else](#issuecomment-1953084379) reported this issue on their new v2.0 board, so a 550MHz STM32 isn't good enough, either?

I don't buy your explanation, as adding in a separate MCU for LEDs (the [Xiao](https://wiki.seeedstudio.com/Seeeduino-XIAO/), with 48MHz SAMD21 in my case) solved the problem instantly.  I could understand having incomplete RGB cycles for layered animations or complicated patterns at high frame rates, but in this case, even a simple "all LEDs on" signal fails on an idle machine.

It feels like we're not being taken seriously.  The response from @bigtreetech comes off (to me) as "there's no way we have a bug in our hardware, you all are just not smart enough to use it correctly."  I felt like I did more than my own due diligence in diagnosing and reporting the problem, the least BTT could do is the same -- why not test this in your own lab?

ajaytanna, 2024-04-23:
Since I was busy building and all I did not pay much attention to the LEDs. Initially they worked when printer was not doing anything, but none of the other actions like heating, probing calibrating etc. work as expected. Some LEDs at the end of the chain do not work as observed earlier. Seems I too have to go in for the secondary MCU option

ajaytanna, 2024-05-09:
After extensive testing on arduino nano decided to revert to the Manta M8P ports after adding a 680 ohm 0.25W through hole resistor per julianschill's advice to each data line on the strips (23 pixels of SK6812 RGBW X 2 strips) The entire set does work as expected. So until it acts up again I consider it working. Need a few days to make a video since I have the printer inverted for beeper and other wiring. Once I put the julianschill led effects through its paces and am satisfied all is ok I hope to make the video.
The LEDs are wired as 19 pixels each on top frame L+R and 4 pixels each bottom frame L+R with 24awg silicon wire twisted together running to the electronics bay about 0.5 meter each line.

ajaytanna, 2024-05-13:
Additional observations: When the printer is idle i.e. the MCU on board the manta is not super busy, all LEDs connected to the RGB ports work as expected every time smoothly and flawlessly. Only when it starts doing anything like homing, levelling printing etc., the lights choke up. Any animated effect glitches out since the MCU is not able to send the requisite data perhaps. Static effects work at whatever colour and brightness they are set at. What has me stumped are the very unpredictable results I got on an arduino nano. I will see if I can lay my hands on a klipper expander.

bigtreetech, 2024-09-09:
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

See the additional comments on this thread which validate this. While I appreciate that you put effort into your investigation, I am afraid that I cannot change the facts to suit the desire for a different outcome. The explanation that I have provided is entirely factual and is the reality of what is happening. The MCU is simply unable to keep up given the bit-banging nature of the comms and the large overhead for each new LED.

MaffooClock, 2024-09-09:
Alright, @bigtreetech, message received loud and clear: BTT is not interested in standing by their products at all (I've heard that support is a joke, and now I see why).  My interest in future BTT products will be minimal.

looxonline, 2024-09-09:
> Alright, @bigtreetech, message received loud and clear: BTT is not interested in standing by their products at all (I've heard that support is a joke, and now I see why). My interest in future BTT products will be minimal.

Sorry to hear that. I'm not sure what else you are expecting. Again, we cannot change the reality of what is happening and have already explained it. There is no hardware bug. It is simply the MCU hitting the maximum limit of what it is able to push out within a single klipper operating cycle. We have both confirmed this in empirical testing and with the klipper developers.

Foden7, 2024-09-15:
I have the same setup and abandoned the M8P controlling the LED's and now use WLED with an ESP32 board. PITA as I'd still like to controll the LED's via the M8P

sajrashid, 2024-09-17:
This is what I have tried board is Manta M8p v2

- Inline resistor (data line) 220 and 100 ohms  😔
- Capacitor small value on the 5v line  😔
- 5v 6a SMPS with a shared ground 😔

I got to light up accidently as the ground was loose, but only about half lit up and did not respond to software changes (apart from a slight flicker)

So has the v2 gone backwards in the LED game

This whole thing  is suss - I mean if you sold an LED controller that did not work in how many situations ?

Foden7, 2024-09-18:
Yep, the Octopus could handle it. The M8P is a good board, so I would cut your losses and do LED via WLED like I did

looxonline, 2024-09-18:
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

And you are sure that your LED strip is good? I am running two M8P V2 boards and both don't skip a beat when driving strips of 60 WS2812B LEDs.

Also, do you have a scope or even a multimeter? You could set the LED output pin as a standard IO and drive it high and low to measure it on the multimeter to see that signals are making it through.

Closed 2024-09-09.

Thread 82 (2023-09-19):

Accidentally shorted 24v to 12v, how to reset e-fuse

Person1873, 2023-09-19:
Hi team, was trying to connect 12V fans and accidentally touched a 24V terminal with metal tweezers.
I see that U21 is an E-fuse for the 12v line, could you please advise me how to reset this?

PaulKolbeck, 2023-09-24:
I have a similar problem where an old fan caused a short. Now the 12V lamp of the board is no longer lit and unfortunately I do not know how to reset the board.
I can't see any visible damage and therefore I assume that the E-fuse is also triggered.

Thread 85 (2023-09-23):

M8P v2.0 boot loader issue and problems configuring CAN

Ram-85, 2023-09-23:
I am having issues configuring CAN BUS with this board, it seems the bootloader is trashed and I unable to flash firmware via sd card

abo974, 2023-10-21:
I have same issue. There's different information from EEB Can and M8P config file document ( we have to use Canbus PB0/PB1 or PD0/PD1 ?). I follow the EBB SB2240 guide and now I can't upload any firmware on M8P... and it doesn't work :/

BobArctor82, 2023-11-01:
someone have a solution ? same probleme after the ebb sb2240 guide

abo974, 2023-11-02:
> someone have a solution ? same probleme after the ebb sb2240 guide

You can flash the board without the sd card... Mine work great, except the undervoltage of the TMC2240 :/.
On both the SB2240 and M8P you've to flash Canboot and Klipper, copy the uuid in your printer.cfg. When you flash the board you can't access to the serial port...
I read a lot of tutorial, and you can find some command in the file below. Make sure you have select communication port PD0/PD1  to flash the Manta board and select communication port PB0/PB1 for the SB2240.
[flashing_Manta_v2_SB2240.txt](https://github.com/bigtreetech/Manta-M8P/files/13236982/flashing_Manta_v2_SB2240.txt)

nero-dv, 2024-01-14:
I had the same problem. I ended up messing up the bootloader on the M8P, and my CM4 could not see the M8P board when I ran the lsusb command. What I ended up doing was flashing the bootloader available in the repo ([link](https://github.com/bigtreetech/Manta-M8P/blob/master/V2.0/Firmware/M8P_V2_H723_bootloader.bin)) with dfu-util

1. Press and hold the boot button of M8P and then click the reset button to make M8P boot into DFU mode.
2. While logged into the CM4/CB1, run `lsusb` to check the MCU's USB-DFU address.
3. Run the following command on the Terminal of CB1/CM4 to write the bootloader to the chip:

`sudo dfu-util -d ,0483:df11 -a 0 --dfuse-address 0x8000000:force:mass-erase -D ./M8P_V2_H723_bootloader.bin`

After this, I set up the can0 interface:

`sudo nano /etc/network/interfaces.d/can0`

Add the following:

```
allow-hotplug can0
iface can0 can static
    bitrate 1000000
    up ifconfig $IFACE txqueuelen 1024
```

Then I power cycled the device and then logged back in via SSH, then I ran:

```
cd ~/klipper
make menuconfig
```

I used the following settings:

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

Then I ran make, rebooted into DFU mode again, then:

`make flash FLASH_DEVICE=0483:df11`

After that finished, I reset the MCU by clicking the reset button on the board and verified that the M8P showed a CAN address:

`python3 ~/klipper/lib/canboot/flash_can.py -q`

After this, I followed a [guide](https://mpx.wiki/flash-m8p-v2-and-ebb-sb-toolboard) on flashing Katapult and Klipper onto the tool-head board I'm using (SB2209 RP2040).

One thing to note is that a lot of guides mention shorting the 120R terminator resistor, but they don't specify that it has to be done on **_both_** the Manta and the tool-head PCB.

Drath1995, 2024-04-08:
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

Twice now you've saved my bacon with these instructions. I cannot thank you enough, praying theres not a 3rd time, but if there is i've at least download this page and got it backed up in multiple locations

charchess, 2024-04-08:
Hi,

you need 2 resistor terminators, no less, no more. One should be on the motherboard and the other on the other side (EBB)

I had issues with that CAN thing and followed https://canbus.esoterical.online which is really comprehensive and got juste the pictures you need. It then worked like a charm, it's really the only guide you need for the CANbus,

hope it'll help

Space-Stick, 2025-03-06:
Thank you Nero-DV, was looking to unbrick my M8P and you helped me not only do that but get can working at the same time. Legendary.

Thread 86 (2023-10-01):

M8P V1.1 - Not going into DFU mode.

deonkretch, 2023-10-01:
Manta M8P refuses to go into DFU mode.

The board is powered via USB with the CB connected. I can SSH to the CB1.

**I have tried:**

- Hold BOOT, Click RESET (the run 'lsusb'), nothing.
- Removed CB1, downloaded M8__bootloader.bin. Renamed to firmware.bin and loaded to the MCU SD card slot. Boot the M8P and left for a couple of minutes. The firmware.bin has not been renamed to firmware.cur
- Remove power. Hold BOOT, connect USB power, release boot. Nothing
- Removed the CB1 and reseated it to ensure that it is connected.

When SSH to the board and running the `lsusb` command this is the output:

`biqu@BTT-CB1:~$ lsusb
Bus 008 Device 001: ID 1d6b:0001 Linux Foundation 1.1 root hub
Bus 004 Device 001: ID 1d6b:0002 Linux Foundation 2.0 root hub
Bus 007 Device 001: ID 1d6b:0001 Linux Foundation 1.1 root hub
Bus 003 Device 001: ID 1d6b:0002 Linux Foundation 2.0 root hub
Bus 006 Device 001: ID 1d6b:0001 Linux Foundation 1.1 root hub
Bus 002 Device 002: ID 1a40:0101 Terminus Technology Inc. Hub
Bus 002 Device 001: ID 1d6b:0002 Linux Foundation 2.0 root hub
Bus 005 Device 001: ID 1d6b:0001 Linux Foundation 1.1 root hub
Bus 001 Device 001: ID 1d6b:0002 Linux Foundation 2.0 root hub`

**Question:**

1. Is there a way to force reset the M8P?
2. Is there another way to get the M8P into DFU mode?

SarcasmRules, 2023-10-22:
Same problem here, need to get it into dfu mode to reset/reflash the mcu/booloader.
Anyone???

celticapatchanka, 2023-10-22:
Having the same issue.
The CB1 stopped communicating with the mcu and no devices appear anymore when I run the command ls /dev/serial/by-id/ so I wanted to try and reset the mcu

deonkretch, 2023-10-23:
> Same problem here, need to get it into dfu mode to reset/reflash the mcu/booloader. Anyone???

Nothing yet...

ijanda, 2023-11-20:
I have the same problem. I've been trying to install the Manta m8p V2 for three days. No chance - it won't go into DFU mode. It is therefore not possible to flash the Klippy.bin because it also does not work via SD card.

elindgren, 2024-02-04:
Same problem here! Have tried flashing via the SD-card method but no luck (pressing the reset button does nothing), and nothing shows up under `/dev/serial`.

SarcasmRules, 2024-02-05:
I don't think that BTT cares enough to fix this issue, they rather have you buy a new one? 🤷🏼‍♂️
Right now it's a paperweight, not a cheap one at that

elindgren, 2024-02-06:
> Same problem here! Have tried flashing via the SD-card method but no luck (pressing the reset button does nothing), and nothing shows up under `/dev/serial"

"Solved" the issue by rolling back to a previous version of klipper, using the rollback functionality of `kiuah`

Fionoz, 2024-03-18:
@deonkretch Did you manage to fix it?

SarcasmRules, 2024-03-19:
> > Same problem here! Have tried flashing via the SD-card method but no luck (pressing the reset button does nothing), and nothing shows up under `/dev/serial"
>
> "Solved" the issue by rolling back to a previous version of klipper, using the rollback functionality of `kiuah`

What version did you go back to?

elindgren, 2024-03-19:
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

I don't remember the specific version from the top of my mind, but I went back to the second-to-last release tag available in the git repository. You can find the tags by running `git tag -l`. I then took the git hash of the release and rolled back to that commit

kmjr20, 2024-07-21:
I am having the same problems with all of a sudden the machine can't see the mcu. attempts to reinstall everything have failed, and you now cant even get it to go into DFU mode. I am frustrated as it started with not being able to set up the 2 z motors getting a UART pin error no matter what I did. Then after rebooting when I added the new TFT70 V3, the mcu stopped working and running any command about serial port results in not finding any, nor the MCU. The manual makes a lot of assumptions that you are a programmer and can fill in the blanks in the directions. Also, the TFT70 v3 shows EXP cables, but there are none on the M8P V2 board. Nothing about how to get it to run. Suggestions about rolling back to previous versions to fix the problems are not realistic as the V2 comes with V2 software. No previous versions for the V2 are on the github website.Does anyone know what I can do. I have been trying to upgrade my TRONXY VEHO 1000 printer, which never worked right out of the box. I have tried reaching out to BTT, and as of yet I have never been able to get anyone or responses from the emails.

Thread 87 (2023-10-05):

Suggested document update for rpi Boot mode

justinhardin, 2023-10-05:
In the file: BIGTREETECH MANTA M8P V1.0&V1.1 User Manual.pdf
On page 28
Step 2
It says 'Push the DIP switch 4 (USB OTG) and 3 (RPIBOOT) to ON to enter BOOT mode.'

I discovered that there is another step possibly required...
there is a micro-switch to the right of the CM4 slot, between the USB C connector and the HDMI 1 connector, that must be in the correct position. (In the USB-OTG position I believe) before the Raspberry CM4 eMMC will show up in RPI Boot.

I spent several hours troubleshooting this, thought I had a bad CM4 board, did a bunch of debugging...then flipped that switch and rpi boot brought the eMMC storage right up.

igiannakas, 2024-03-23:
THANK YOU!!🙏🏻

been hitting my head against a brick wall with this. Flipped that switch to the uart to USB setting and it was recognised straight away.

vikcious, 2025-06-02:
I've been to hell and back till the moment I discovered on my own that damn switch and (out of desperation!) I've switched its position to **"UART-to-USB"** from the default "USB-OTG" and MIRACLE: CM4 eMMC was recognized by rpiboot.exe and I was able to flash the Mainsail 2.0 x64 image.

bigtreetech, 2025-06-02:
It's the opposite. It should be in USB-OTG mode but maybe the drawing makes the dark and light spots seem like it is in the opposite orientation.

vikcious, 2025-06-02:
> It's the opposite. It should be in USB-OTG mode but maybe the drawing makes the dark and light spots seem like it is in the opposite orientation.
Could you please confirm which position this really is. It might be a great deal of help for the others.
So for me, the switch was on the opposite position, so it came by default set. And now, only in this position my CM4 eMMC eventually became available to be flashed. Thank you!
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

bigtreetech, 2025-06-02:
No, I think it is the light and dark spots in the manual which are confusing. The dark indicates the switch position so right is UART to USB and left is USB-OTG.

vikcious, 2025-06-02:
Ok. I would read it the opposite way... since white is the smaller surface on the magenta area BUT thanks for the clarification.
I've been banging my head against the wall for the past 48 hours not knowing what i do wrong and planned to even return my Manta M8P to Amazon on such grounds.
Can I kindly ask you to **add a phrase detailing this pre-requisite of this switch being in the right position** for the CM4 eMMC flashing (page 24). There are, as of today, zero references inn the whole manual about this switch and trust me other forums are filled with people fumbling on not being able to get their CM4 eMMC recognized and flashed. **Thanks a lot!**

bigtreetech, 2025-06-02:
We will need to update the manual with a drawing that is less confusing. I will get the guys who work on the manuals to do this as soon as they are back from the dragon boat festival tomorrow.

vikcious, 2025-06-02:
> We will need to update the manual with a drawing that is less confusing. I will get the guys who work on the manuals to do this as soon as they are back from the dragon boat festival tomorrow.

**Thanks!** So the update needs to target:
1) the drawing explanation & colors need be updated (drawing on page 8)
2) this phrase, on page 24, needs to be updated from:
_"2. Toggle switches 4 (USBOTG) and 3 (RPIBOOT) to ON to enter BOOT mode."_ should read **_"2. Toggle switches 4 (USBOTG) and 3 (RPIBOOT) to ON to enter BOOT mode AND confirm that SW2 switch is in "USB-OTG" position and not in "UART-to-USB"."_**

Thread 88 (2023-10-19):

Pin issue

dunbard0401, 2023-10-19:
I've prepped an OS image for my Manta M8P w/ CB1 (no eMMC), added the "generic-bigtreetech-manta-m8p-V2_0.cfg" config file, and i get this error on startup:
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

dunbard0401, 2023-10-19:
this is the config file:

# This file contains common pin mappings for the BIGTREETECH Manta M8P V2.0
# To use this config, the firmware should be compiled for the
# STM32H723 with a "128KiB bootloader" "25 MHz crystal"
# and "USB (on PA11/PA12)", "CAN bus (on PD0/PD1)" or Serial (on USART1 PA10/PA9).

# See docs/Config_Reference.md for a description of parameters.

# Motor1
[stepper_x]
step_pin: PE6
dir_pin: PE5
enable_pin: !PC14
microsteps: 16
rotation_distance: 40
endstop_pin: ^PF4
position_endstop: 0
position_max: 235
homing_speed: 50

# Motor2
[stepper_y]
step_pin: PE2
dir_pin: PE1
enable_pin: !PE4
microsteps: 16
rotation_distance: 40
endstop_pin: ^PF3
position_endstop: 0
position_max: 235
homing_speed: 50

# Motor3
[stepper_z]
step_pin: PB8
dir_pin: !PB7
enable_pin: !PE0
microsteps: 16
rotation_distance: 8
endstop_pin: ^PF2
position_endstop: 0
position_max: 270
position_min: -5.0
homing_speed: 8
second_homing_speed: 3
homing_retract_dist: 3

## Motor4
# The M8P only has 4 heater outputs which leaves an extra stepper
# This can be used for a second Z stepper, dual_carriage, extruder co-stepper,
# or other accesory such as an MMU
#[stepper_]
#step_pin: PB4
#dir_pin: PB3
#enable_pin: !PB6
#endstop_pin: ^PF1
#...

# Motor5
[extruder]
step_pin: PG13
dir_pin: PG12
enable_pin: !PG15
microsteps: 16
rotation_distance: 33.500
nozzle_diameter: 0.4
filament_diameter: 1.75
heater_pin: PA0 # HE0
sensor_pin: PB0 # T0
sensor_type: Generic 3950
control: pid
pid_Kp: 22.2
pid_Ki: 1.08
pid_Kd: 114
min_temp: 0
max_temp: 250

## End-Stop 5
#[filament_switch_sensor material_0]
#switch_pin: PF0

## Motor6
#[extruder1]
#step_pin: PG9
#dir_pin: PD7
#enable_pin: !PG11
#heater_pin: PA1 # HE1
#sensor_pin: PC5 # T1
#...

## End-Stop 6
#[filament_switch_sensor material_1]
#switch_pin: PC15

## Motor7
#[extruder2]
#step_pin: PD4
#dir_pin: PD3
#enable_pin: !PD6
#heater_pin: PA3 # HE2
#sensor_pin: PC4 # T2
#...

## Motor8
#[extruder3]
#step_pin: PC7
#dir_pin: PC8
#enable_pin: !PD2
#heater_pin: PA5 # HE3
#sensor_pin: PA7 # T3
#...

[heater_bed]
heater_pin: PF5
sensor_pin: PB1 # TB
sensor_type: ATC Semitec 104GT-2
control: watermark
min_temp: 0
max_temp: 130

#[fan_generic soc-fan]
#pin: host:gpio79  #CB1
#pin: host:gpio26  #CM4

# Fan0
[fan]
pin: PF7

## Fan1
#[heater_fan fan1]
#pin: PF9

## Fan2
#[heater_fan fan2]
#pin: PF6

## Fan3
#[heater_fan fan3]
#pin: PA8

## Fan4
#[heater_fan fan4]
#pin: PA4

## Fan5
#[heater_fan fan5]
#pin: PA6
#tachometer_pin: PC2

## Fan6
#[heater_fan fan6]
#pin: PA2
#tachometer_pin: PC1

[mcu]

serial: /dev/serial/by-id/usb-Klipper_stm32g0b1xx_0E00290009504B4633373520-if00

[printer]
kinematics: cartesian
max_velocity: 300
max_accel: 3000
max_z_velocity: 5
max_z_accel: 100

########################################
# TMC2209 configuration
########################################

## Motor1
#[tmc2209 stepper_x]
#uart_pin: PC13
##diag_pin: PF4
#run_current: 0.800
#stealthchop_threshold: 999999

## Motor2
#[tmc2209 stepper_y]
#uart_pin: PE3
##diag_pin: PF3
#run_current: 0.800
#stealthchop_threshold: 999999

## Motor3
#[tmc2209 stepper_z]
#uart_pin: PB9
##diag_pin: PF2
#run_current: 0.650
#stealthchop_threshold: 999999

## Motor4
#[tmc2209 stepper_]
#uart_pin: PB5
##diag_pin: PF1
#run_current: 0.650
#stealthchop_threshold: 999999

## Motor5
#[tmc2209 extruder]
#uart_pin: PG14
#run_current: 0.800
#stealthchop_threshold: 999999

## Motor6
#[tmc2209 extruder1]
#uart_pin: PG10
#run_current: 0.800
#stealthchop_threshold: 999999

## Motor7
#[tmc2209 extruder2]
#uart_pin: PD5
#run_current: 0.800
#stealthchop_threshold: 999999

## Motor8
#[tmc2209 extruder3]
#uart_pin: PC6
#run_current: 0.800
#stealthchop_threshold: 999999

########################################
# TMC2130 configuration
########################################

## Motor1
#[tmc2130 stepper_x]
#cs_pin: PC13
#spi_software_mosi_pin: PG6
#spi_software_miso_pin: PG7
#spi_software_sclk_pin: PG8
##diag1_pin: PF4
#run_current: 0.800
#stealthchop_threshold: 999999

## Motor2
#[tmc2130 stepper_y]
#cs_pin: PE3
#spi_software_mosi_pin: PG6
#spi_software_miso_pin: PG7
#spi_software_sclk_pin: PG8
##diag1_pin: PF3
#run_current: 0.800
#stealthchop_threshold: 999999

## Motor3
#[tmc2130 stepper_z]
#cs_pin: PB9
#spi_software_mosi_pin: PG6
#spi_software_miso_pin: PG7
#spi_software_sclk_pin: PG8
##diag1_pin: PF2
#run_current: 0.650
#stealthchop_threshold: 999999

## Motor4
#[tmc2130 stepper_]
#cs_pin: PB5
#spi_software_mosi_pin: PG6
#spi_software_miso_pin: PG7
#spi_software_sclk_pin: PG8
##diag1_pin: PF1
#run_current: 0.800
#stealthchop_threshold: 999999

## Motor5
#[tmc2130 extruder]
#cs_pin: PG14
#spi_software_mosi_pin: PG6
#spi_software_miso_pin: PG7
#spi_software_sclk_pin: PG8
#run_current: 0.800
#stealthchop_threshold: 999999

## Motor6
#[tmc2130 extruder1]
#cs_pin: PG10
#spi_software_mosi_pin: PG6
#spi_software_miso_pin: PG7
#spi_software_sclk_pin: PG8
#run_current: 0.800
#stealthchop_threshold: 999999

## Motor7
#[tmc2130 extruder2]
#cs_pin: PD5
#spi_software_mosi_pin: PG6
#spi_software_miso_pin: PG7
#spi_software_sclk_pin: PG8
#run_current: 0.800
#stealthchop_threshold: 999999

## Motor8
#[tmc2130 extruder3]
#cs_pin: PC6
#spi_software_mosi_pin: PG6
#spi_software_miso_pin: PG7
#spi_software_sclk_pin: PG8
#run_current: 0.800
#stealthchop_threshold: 999999

[board_pins]
aliases:
    # EXP1 header
    EXP1_1=PE7, EXP1_2=PG1,
    EXP1_3=PG0, EXP1_4=PF15,
    EXP1_5=PF14, EXP1_6=PF13,    # Slot in the socket on this side
    EXP1_7=PF12, EXP1_8=PF11,
    EXP1_9=<GND>, EXP1_10=<5V>,

    # EXP2 header
    EXP2_1=PE13, EXP2_2=PE12,
    EXP2_3=PE15, EXP2_4=PE11,
    EXP2_5=PE10, EXP2_6=PE14,      # Slot in the socket on this side
    EXP2_7=PE8, EXP2_8=<RST>,
    EXP2_9=<GND>, EXP2_10=<NC>

# See the sample-lcd.cfg file for definitions of common LCD displays.

#[adxl345]
#cs_pin: PA15
#spi_bus: spi3a

#[bltouch]
#sensor_pin: PD13
#control_pin: PD12

## Proximity switch
#[probe]
#pin: PD8

#[output_pin ps_on_pin]
#pin: PD14

#[neopixel my_neopixel_1]
#pin: PD15

#[hall_filament_width_sensor]
#adc1: PC0
#adc2: PF10

Thread 89 (2023-10-19):

Power on problem Manta M8P V1.1

FiViSt82, 2023-10-19:
When power is applied, the indicators of the 12, 5 and 3.3 volt stabilizers light up. The power indicator at the bottom blinks once and does not light up. Turning it on and off doesn't give any result. If the power is turned on again immediately after the red indicator of the stabilizers goes out (4-5 seconds after turning off), then the indicator at the bottom of the board lights up and the board starts up and Klipper loads.

https://youtu.be/e1HaChP5kSg

Thread 90 (2023-10-25):

DWIN LCD on Manta m8p (MARLIN)

mtate-00, 2023-10-25:
I am attempting to use a DWIN LCD (the one that came with my e3 v2) on a manta board, and cannot get it to boot.

I am wanting to run marlin, probably with octoprint, and have followed [guides](https://www.smith3d.com/skr-mini-e3-v2-v3-on-ender-3-v2-ender-3-s1-lcd-dwin-knob-screen/) on connecting the screen to other BTT boards, such as the skr mini e3, with no avail. I have additionally attempted to figure out mapping for myself, again to no avail.

The screen turns on (ie receives power), but no marlin loading screen appears.

My SERIAL_PORT is set to 2, and baud rate set to 115200, which I assume is correct. The screen is connected to EXP1, either straight in, or using F-M Dupoint cables, as shown [here (same link as above).](https://www.smith3d.com/skr-mini-e3-v2-v3-on-ender-3-v2-ender-3-s1-lcd-dwin-knob-screen/)

I have attempted various different combinations of pins, with no luck. I would appreciate any suggestions you have

Thread 91 (2023-10-30):

Manta M8P 1.0 3rd USB 2 port not working?

Shahid-Manzar, 2023-10-30:
I have been attempting to connect a camera via the 4-pin USB port that is clearly labeled in the manual. I see the pin layout is as shown below (relabelled in green for visibility) but nothing I do seems to work. I tried switching the D+ and D- pins but still no dice. I was wondering if anyone has gotten this to work.

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

jonmeredith, 2023-12-30:
I also failed with an M8P 2.0. I tried wiring D+/D- both ways but no luck.

Thread 92 (2023-11-06):

Homing failed due to printer shutdown

fish1942, 2023-11-06:
I'm getting "Homing failed due to printer shutdown."  or "Unable to write tmc spi 'stepper_x' register GCONF" when trying to home custom Vorom 2.4. I've checked motor wiring and all checks out
Running TMC5160 drivers
Hermit Crab/canbus

I'm stuck

printer.cfg

# This file contains common pin mappings for the BIGTREETECH Manta M8P
# To use this config, the firmware should be compiled for the
# STM32G0B1 with a "8KiB bootloader" and USB communication.

# See docs/Config_Reference.md for a description of parameters.
[include Hermit Crab.cfg]
[include nozzle_scrub.cfg]
[include mainsail.cfg]
[virtual_sdcard]
path: /home/biqu/printer_data/gcodes
on_error_gcode: CANCEL_PRINT

[mcu]
canbus_uuid=63514f1fd4c8
##	[X in MOTOR0] - B Motor
##	[Y in MOTOR1] - A Motor
##	[E in MOTOR6] - Extruder
##	Obtain definition by "ls -l /dev/serial/by-id/" then unplug to verify
##--------------------------------------------------------------------
##serial: /dev/serial/by-id/usb-Klipper_stm32g0b1xx_3D003F0011504B4633373520-if00
#restart_method: command
##--------------------------------------------------------------------

[printer]
kinematics: corexy
max_velocity: 300
max_accel: 3000    			#Max 4000
max_z_velocity: 15 			#Max 15 for 12V TMC Drivers, can increase for 24V
max_z_accel: 350
square_corner_velocity: 5.0

[temperature_sensor MCU]
sensor_type: temperature_mcu

[temperature_sensor SoC]
sensor_type: temperature_host

######################### POWER CONTROLLER ###########################
[output_pin PS_ON_OFF]
pin: PC3
value: 1
#####################################################################

# ######################### BEACON SCANNER ###########################
[beacon]
 serial: /dev/serial/by-id/usb-Beacon_Beacon_RevD_45FABF8D4E4B333448202020FF0A0621-if00
x_offset: -1.719 # update with offset from nozzle on your machine
y_offset: -73.239 # update with offset from nozzle on your machine
mesh_main_direction: x
mesh_runs: 1

[bed_mesh]
speed: 420
horizontal_move_z: 12
mesh_min: 40, 30
mesh_max: 340, 280
probe_count: 6, 6
#---------------------------------------------------------------------------
[idle_timeout]
timeout: 1800

[safe_z_home]
##	XY Location of the Z Endstop Switch
##	Update -10,-10 to the XY coordinates of your endstop pin
##	(such as 157,305) after going through Z Endstop Pin
##	Location Definition step.
home_xy_position: 275,275 #257,350 ################################################################ Z Home #########################################################
speed:500
z_hop: 3 #10
z_hop_speed: 5

[quad_gantry_level]
##	Use QUAD_GANTRY_LEVEL to level a gantry.
##	Min & Max gantry corners - measure from nozzle at MIN (0,0) and
##	MAX (250, 250), (300,300), or (350,350) depending on your printer size
##	to respective belt positions

#--------------------------------------------------------------------
gantry_corners:
	-60,-10
	410,410
#	Probe points
points:
	50,25
	50,275
	300,275
	300,25
#--------------------------------------------------------------------
speed: 1000
horizontal_move_z: 10
retries: 5
retry_tolerance: 0.0075
max_adjust: 10

#####################################################################
# 	X/Y Stepper Settings
#####################################################################
## X Stepper on Motor1(B Motor)
[stepper_x]
step_pin: PE2
dir_pin: PB4
enable_pin: PC11
microsteps: 16
rotation_distance: 40
endstop_pin: tmc5160_stepper_x:virtual_endstop #PC1    #X End Stop
position_min: 0
##--------------------------------------------------------------------
##	Uncomment for 350mm build
position_endstop: 550
position_max: 550

##--------------------------------------------------------------------
homing_speed: 25   #Max 100
homing_retract_dist: 5
homing_positive_dir: true

##	Make sure to update below for your relevant driver (2208 or 2209)
[tmc5160 stepper_x]
#uart_pin: PC10
cs_pin: PC10
spi_bus: spi1
interpolate: True
run_current: 1.130
hold_current: 0.5
sense_resistor: 0.075
stealthchop_threshold: 999999
driver_SGT: 20
diag0_pin: ^PF3

## Y Stepper on Motor2 (A Motor)
[stepper_y]
step_pin: PF12
dir_pin: !PF11
enable_pin: !PB3
microsteps: 16
rotation_distance: 40
endstop_pin: tmc5160_stepper_y:virtual_endstop #PC1    #Y End Stop
position_min: 0

##--------------------------------------------------------------------

##	Uncomment for 250mm build
#position_endstop: 250
#position_max: 250

##	Uncomment for 300mm build
#position_endstop: 300
#position_max: 300

##	Uncomment for 350mm build
position_endstop: 550
position_max: 550

##--------------------------------------------------------------------
homing_speed: 25  #Max 100
homing_retract_dist: 5
homing_positive_dir: true

##	Make sure to update below for your relevant driver (2208 or 2209)
[tmc5160 stepper_y]
cs_pin: PF13
spi_bus: spi1
interpolate: True
run_current: 1.130
hold_current: 0.5
sense_resistor: 0.075
stealthchop_threshold: 999999
driver_SGT: 20
diag0_pin: ^PF4

#####################################################################
# 	Z Stepper Settings
#####################################################################
## Z0 Stepper - Front Left on MOTOR3_A
[stepper_z]
step_pin: PD7
dir_pin: PD6
enable_pin: !PF10
rotation_distance: 40
gear_ratio: 80:16
microsteps: 16
endstop_pin: ^PF5
#position_endstop: 550
position_max: 550
##--------------------------------------------------------------------

#position_endstop: -5 # Remove for Probe
#position_max: 340
position_min: -20
homing_speed: 8
second_homing_speed: 3
homing_retract_dist: 3
#----------------------------- For Beacon -------------------------------
endstop_pin: probe:z_virtual_endstop # use beacon as virtual endstop
homing_retract_dist: 0 # beacon needs this to be set to 0
#----------------------------- For Beacon -------------------------------

##	Make sure to update below for your relevant driver (2208 or 2209)
[tmc5160 stepper_z]
cs_pin: PF9
spi_bus: spi1
interpolate: true
run_current: 1.130
hold_current: 0.5
sense_resistor: 0.075
stealthchop_threshold: 999999

##	Z1 Stepper - Rear Left on Motor4
[stepper_z1]
step_pin: PD3
dir_pin: !PD2
enable_pin: !PD5
rotation_distance: 40
gear_ratio: 80:16
microsteps: 16

##	Make sure to update below for your relevant driver (2208 or 2209)
[tmc5160 stepper_z1]
cs_pin: PD4
spi_bus: spi1
interpolate: true
run_current: 1.5
hold_current: 0.130
sense_resistor: 0.075
stealthchop_threshold: 999999

##	Z2 Stepper - Rear Right on Motor5
[stepper_z2]
step_pin: PC9
dir_pin: PC8
enable_pin: !PD1
rotation_distance: 40
gear_ratio: 80:16
microsteps: 16

##	Make sure to update below for your relevant driver (2208 or 2209)
[tmc5160 stepper_z2]
cs_pin: PD0
spi_bus: spi1
interpolate: true
run_current: 1.5
hold_current: 0.130
sense_resistor: 0.075
stealthchop_threshold: 999999

##	Z3 Stepper - Front Right on Motor6
[stepper_z3]
step_pin: PD11
dir_pin: !PD9
enable_pin: !PD15
rotation_distance: 40
gear_ratio: 80:16
microsteps: 16

##	Make sure to update below for your relevant driver (2208 or 2209)
[tmc5160 stepper_z3]
cs_pin: PF8
spi_bus: spi1
interpolate: true
run_current: 1.130
hold_current: 0.5
sense_resistor: 0.075
stealthchop_threshold: 999999

#####################################################################
# 	Bed Heater
#####################################################################

[heater_bed]
##	SSR Pin - BED_OUT
heater_pin: PE3
sensor_type: ATC Semitec 104GT-2
sensor_pin: PA1
##	Adjust Max Power so your heater doesn't warp your bed
max_power: 1.0
min_temp: -100 #----------- Change ----------------
max_temp: 120
control: pid
pid_kp: 58.437
pid_ki: 2.347
pid_kd: 363.769

#####################################################################
# 	Probe
#####################################################################

# [probe]
# ##	Inductive Probe
# ##	This probe is not used for Z height, only Quad Gantry Leveling
# ##  NPN and PNP proximity switch types can be set by jumper
# pin: !PC13
# x_offset: 0
# y_offset: 25.0
# z_offset: 0
# speed: 10.0
# samples: 3
# samples_result: median
# sample_retract_dist: 3.0
# samples_tolerance: 0.006
# samples_tolerance_retries: 3

#####################################################################
# 	Fan Control
#####################################################################

[fan]
##	Print Cooling Fan - CNC_FAN0
# pin: PE4
# kick_start_time: 0.5
# ##	Depending on your fan, you may need to increase this value
# ##	if your fan will not start. Can change cycle_time (increase)
# ##	if your fan is not able to slow down effectively
# off_below: 0.10

# [multi_pin my_enable_pin]
# pins: PC12, PE5

# [controller_fan PS_Fan]
# pin: PE5
# max_power: 1.0
# shutdown_speed: 1.0
# kick_start_time: 0.100
# fan_speed: 1.0
# idle_timeout: 30
# idle_speed: 1.0
# heater: heater_bed

[temperature_fan SoC_fan]
pin: PE5
control: watermark
max_power: 1.0
max_delta: 3.0
sensor_type: temperature_host
min_temp: 25
max_temp: 55
target_temp: 42

#####################################################################
# 	LED Control
#####################################################################

#[output_pin caselight]
# Chamber Lighting - HE1 Connector (Optional)
#pin: PB5
#pwm:true
#shutdown_value: 0
#value:1
#cycle_time: 0.01

#####################################################################
# 	Macros
#####################################################################

[gcode_macro G32]
gcode:
    BED_MESH_CLEAR
    G28
    QUAD_GANTRY_LEVEL
    G28
    ##	Uncomment for for your size printer:
    #--------------------------------------------------------------------
    ##	Uncomment for 250mm build
    #G0 X125 Y125 Z30 F3600

    ##	Uncomment for 300 build
    #G0 X150 Y150 Z30 F3600

    ##	Uncomment for 350mm build
    #G0 X175 Y175 Z30 F3600
    #--------------------------------------------------------------------

[gcode_macro PRINT_START]
#   Use PRINT_START for the slicer starting script - please customise for your slicer of choice
gcode:
    G32                            ; home all axes
    G1 Z20 F3000                   ; move nozzle away from bed

[gcode_macro PRINT_END]
#   Use PRINT_END for the slicer ending script - please customise for your slicer of choice
gcode:
    M400                           ; wait for buffer to clear
    G92 E0                         ; zero the extruder
    G1 E-10.0 F3600                ; retract filament
    G91                            ; relative positioning
    G0 Z1.00 X20.0 Y20.0 F20000    ; move nozzle to remove stringing
    TURN_OFF_HEATERS
    M107                           ; turn off fan
    G1 Z2 F3000                    ; move nozzle up 2mm
    G90                            ; absolute positioning
    G0  X125 Y250 F3600            ; park nozzle at rear
    BED_MESH_CLEAR

## 	Thermistor Types
##   "EPCOS 100K B57560G104F"
##   "ATC Semitec 104GT-2"
##   "NTC 100K beta 3950"
##   "Honeywell 100K 135-104LAG-J01"
##   "NTC 100K MGB18-104F39050L32" (Keenovo Heater Pad)
##   "AD595"
##   "PT100 INA826"

#[bltouch]
#sensor_pin: PB2
#control_pin: PB1

# Proximity switch
#[probe]
#pin: PF6

#[output_pin ps_on_pin]
#pin: PC3

#[neopixel my_neopixel_1]
#pin: PC6

#[neopixel my_neopixel_2]
#pin: PA9

#[hall_filament_width_sensor]
#adc1: PC5
#adc2: PB0

#*# <---------------------- SAVE_CONFIG ---------------------->
#*# DO NOT EDIT THIS BLOCK OR BELOW. The contents are auto-generated.
#*#
#*# [beacon model default]
#*# model_coef = 1.6608428511917357,
#*# 	  1.9745952494640426,
#*# 	  0.7200836160048609,
#*# 	  0.285690029242561,
#*# 	  0.19719624157334922,
#*# 	  0.23351270546898684,
#*# 	  -0.07208060378410051,
#*# 	  -0.256286396259256,
#*# 	  0.09528598741574935,
#*# 	  0.16611288795613285
#*# model_domain = 3.296938592977582e-07,3.3478753749769333e-07
#*# model_range = 0.200000,5.000000
#*# model_temp = 49.271195
#*# model_offset = 0.00000
#*#
#*# [bed_mesh default]
#*# version = 1
#*# points =
#*# 	-0.223671, -0.167909, -0.187913, -0.171787, -0.175397, -0.165027
#*# 	-0.190403, -0.144021, -0.160173, -0.156289, -0.163816, -0.147125
#*# 	-0.179681, -0.164370, -0.185062, -0.169769, -0.175827, -0.173186
#*# 	-0.212819, -0.194417, -0.220745, -0.210980, -0.215077, -0.202902
#*# 	-0.192705, -0.165309, -0.186978, -0.169542, -0.174999, -0.157046
#*# 	-0.239936, -0.194208, -0.202588, -0.177917, -0.185569, -0.167155
#*# x_count = 6
#*# y_count = 6
#*# mesh_x_pps = 2
#*# mesh_y_pps = 2
#*# algo = lagrange
#*# tension = 0.2
#*# min_x = 40.0
#*# max_x = 340.0
#*# min_y = 30.0
#*# max_y = 280.0

rafous, 2023-11-28:
I have the same problem, did you find a solution?

fish1942, 2023-11-29:
No I went back to the 2209's

BelgarionNL, 2024-05-24:
old but for anyone the config is completely wrong. for tmc5160 stepper_X etc.

Thread 93 (2023-11-07):

Unable to flash Manta M4P

Gabriel121217, 2023-11-07:
I am having difficulty flashing the MCU of the manta M4P. I have tried the following
- compiling klipper myself and using SD card slot (full size SD card)
- used the precompiled bin file on the github (full size SD card)
- tried using DFU mode (not sure how exactly to put into DFU mode)

I am quite stumped and not sure what else to do. It was powered by 24V bench top power supply. The CB1 i am using has been flashed and I can access the online GUI of mainsail.

fish1942, 2023-11-07:
Make sure you are using the correct SD card slot
or try using kiah https://github.com/bigtreetech/kiauh

Gabriel121217, 2023-11-07:
i have tried flashing from both SD card slots. which one should be the correct one?

fish1942, 2023-11-09:
The one on the top of the board

alexnagelberg, 2025-01-09:
I went through two boards before I figured out what was going on. It doesn't sound like it will resolve the OPs since they used the full-size SD card, but for others, the 'hurakan' firmware that's preloaded wouldn't work with DFU flashing, and it didn't even occur to me there were two SD card slots. Loaded new klipper firmware on full size as firmware.bin with a fat32 filesystem, restarted the MCU, then was able to use DFU mode with the latest klipper on it.

Thread 95 (2023-11-15):

Manta M8P with CM4 not found the CSI Pi Global Shutter Camera and no working CSI Display

Magic2991, 2023-11-15:
I have problems with the CSI ports for camera and display. Neither the PI Global Shutter Camera nor the display connected to the CSI port work with the Manta M8P+CM4. With an HDMI display it works without any problems, with CSI it stays dark.

looxonline, 2023-11-22:
You need to install the overlays on the CM4 to enable the camera and the screen which has nothing to do with the manta. https://www.raspberrypi.com/documentation/computers/compute-module.html#sources

NegussugeN, 2023-11-28:
> I have problems with the CSI ports for camera and display. Neither the PI Global Shutter Camera nor the display connected to the CSI port work with the Manta M8P+CM4. With an HDMI display it works without any problems, with CSI it stays dark. I usw the pi OS Bullseye.

Did you ever make any progress on this? Having the same issue myself.

Superflyron, 2023-12-30:
I wanted to thank you very much, I tried everything possible for two days without success. Your solution worked right away, you should forward it to bigtreetech, because it is wrong in the description.

Turge08, 2023-12-31:
> I wanted to thank you very much, I tried everything possible for two days without success. Your solution worked right away, you should forward it to bigtreetech, because it is wrong in the description.

I notified them about the error. It's related to a change in the newest version of Raspbian btw (bookworm).

Thread 96 (2023-12-09):

Manta 8p V2.0 DFU mode

sergelhr, 2023-12-09:
I'm looking for some info regardinf DFU mode, usualy boot + reset then release reset. on that  board version we have  boot 0 and boot 1 so which one one i need to use for klipper ? No information witin pdf as usual.
Br
Serge

szabieable, 2023-12-17:
Boot0

olivbd, 2023-12-19:
I confirm, it's BOOT0.

edev-us, 2024-01-07:
So what is Boot1 used for?

olivbd, 2024-01-08:
> So what is Boot1 used for?

According to STM32 technical doc, it's used to boot on embedded SRAM.

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

I don't think it's actually used by Klipper firmware.

Thread 97 (2023-12-12):

Manta M8P V2.0 Schematics

olivbd, 2023-12-12:
Where can I find schematics for this board?

There are only schematics for V1.0 and V1.1.

mykepredko, 2023-12-15:
I'm also looking for them.

Please notify when they're available.

mink007, 2023-12-19:
https://github.com/bigtreetech/Manta-M8P/blob/master/V2.0/Hardware/BIGTREETECH%20MANTA%20M8P%20V2.0-SCH.pdf

olivbd, 2023-12-19:
> https://github.com/bigtreetech/Manta-M8P/blob/master/V2.0/Hardware/BIGTREETECH%20MANTA%20M8P%20V2.0-SCH.pdf

Thanks!!

I close this issue.

Closed 2023-12-19.

Thread 98 (2023-12-13):

Canbus marked incorrectly on the pinout diagram

Pneumanifest, 2023-12-13:
On the M8P V2 pinout diagram the canbus pins are marked as TX and RX. This is the wrong protocol and and does not translate to over to canbus High and Low.

Recommend to update pinout and add schematic to prevent user confusion.

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

olivbd, 2023-12-19:
I confirm that these pins should be marked "CANH"/"CANL" (or "CANL/CANH" ?)

There is a transceiver on this board (SN65HVD1050D), you can check it on schematics.

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

dhazelett, 2023-12-21:
TX = CAN Low, RX = CAN High. I discovered this a while ago by flipping the board over, woulda been very helpful to have it labeled correctly in the pinout.

Pneumanifest, 2023-12-21:
Patrick Myrseth
reacted to your message:

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

Pneumanifest, 2023-12-21:
Patrick Myrseth
reacted to your message:

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

Thread 100 (2023-12-20):

M8P v2 + CB1 + ADXL345 troubleshooting

Twdiap, 2023-12-20:
Got ff vs e5 as always. The board doesn't recognize the accel chip no matter what.
Tried uncomment the spidev0.0 then specify in config, and it's not a wiring problem because it worked on my M8P V1.0 and V1.1 and is still working on my old M4P
Tried hooking a multimeter and power is okay... I think there's a problem with SPI on this board
Can't configure anything without breaking the whole config... No one responding to my email ... I'm really tired of BTT rn.

Config:

[adxl345]
spi_software_mosi_pin: PC12
spi_software_miso_pin: PC11
spi_software_sclk_pin: PC10
cs_pin: PA15

Twisted-FPV, 2024-04-14:
has you figured this out? im currently having the same exact problem. cant find anything for the v2.0

Thread 101 (2023-12-20):

Stealthchop mode

theprintingpress, 2023-12-20:
How do I use stealthchop mode with tmc2209? I uncommented the tmc2209 config section but when I try to do a homing, mainsail gives me this error:

Unable to read tmc uart 'stepper_y' register IFCNT
Once the underlying issue is corrected, use the
"FIRMWARE_RESTART" command to reset the firmware, reload the
config, and restart the host software.
Printer is shutdown

Thread 102 (2024-01-07):

Manta M8P V2.0 tmc2130 config add interpolate: False

GregNuspel, 2024-01-07:
Please add `interpolate: False` to the configuration for the TMC2130 drivers in the  example file. It will prevent people having the issue of slanted prints. It may be necessary in other stepper drivers as well.

Thread 103 (2024-01-10):

Manta M8P V2 PWM fans not working

mrstone14, 2024-01-10:
Trying to run Noctua 12V fans off the PWM pins, but the fans never kick on.  12v jumpers are correctly installed.  I had success with the Manta M8P V1.1, but not on the V2.0.  I am getting the following error from Klipper:

"MCU 'mcu' shutdown: Not a valid PWM pin"

My fan config:

[fan_generic exhaust]
pin: PC1
max_power: 1.0
shutdown_speed: 1.0
kick_start_time: 0.5
tachometer_pin: PA2
hardware_pwm: True
cycle_time: 0.00004 # 25 kHz

If I turned hardware_pwm to "false", the klipper error goes away but the fan still doesn't run.  Per the documentation, PWM fans should be pin PC1 and PC2.

mrstone14, 2024-01-10:
Figured out the problem:

The PWM pins and Tachometer pins on the V2 pinout jpeg are reversed.  When viewing the 3D file provided by BTT, you can see the pins labeled on the bottom of the PCB, which are swapped compared to the jpeg file.  I have reversed the pins in my Klipper config and all is working.

This appears to be the case for Fan 4, Fan 5 and Fan 6. I have confirmed this is working for Fan 5 and Fan 6, but have not tested Fan 4.

Posting photos to help anyone else.  Suggested Klipper config:

FAN 4 (not confirmed)
pin: PA4

FAN 5 (confirmed)
pin: PA6
tachometer_pin: PC2

FAN 6 (confirmed)
pin: PA2
tachometer_pin: PC1

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

jurassicplayer, 2024-01-19:
Could probably leave this issue open, since it's still an issue with their documentation (threw me for a loop too xD).

Closed 2024-01-10.

Thread 104 (2024-01-14):

M8P V2 with CM4 -> no connection

HighControl, 2024-01-14:
Translated from German to English using Google:

Hello from Germany,
I put the CM4 on the board. First I pressed right and then left until the clicks came and it didn't work any further. DIP switches 3+4 are set to ON. The board is supplied with 24V power. Jumper for VUSB is not inserted. The LEDs for 12V, 5V, 3.3V light up on the board and PWR lights up next to the CM4. When connecting the PC to the UBS-C port, nothing happens and RPIBOOT writes "waiting". I tried another PC as a test, also a different USB cable. What else could I test or what am I doing wrong?

HighControl, 2024-01-14:
ok, i found the original cable and this works fine.

HighControl, 2024-01-14:
ok, i found the original cable and this works fine.

Thread 105 (2024-01-14):

CAD Model for V2.0 is incorrect

nero-dv, 2024-01-14:
My guess is that it is the V1 board that has been uploaded here since the CAN connector and its paired 120R termination resistor are missing from the board.

I'll have to measure the distances between the mounting holes as well since a the v2 main board did not align with a case I designed where I had used your CAD model as a reference point.

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

Thread 106 (2024-01-22):

Typo in User Guide 6.3.3

OnAdditive, 2024-01-22:
There's a small typo in the English user guide on page 36 in section 6.2.3. The word "klipper" is mispeleled as "kliiper" in one of the commands given.

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

Thread 107 (2024-02-06):

CAN to USB missing after flashing bootloader

garethbradley, 2024-02-06:
Board: Manata M8P v2
MCU: CB1 with eMMC

After flashing the M8P board with a new klipper config, I lost connectivity with my EBB42 v1.2. So, I reflashed the bootloader as stated here and lost the OpenMoko usb device. I'm now completely unable to boot klipper or cannect to the can0 socket

```
biqu@BTT-CB1:~$ lsusb
Bus 008 Device 001: ID 1d6b:0001 Linux Foundation 1.1 root hub
Bus 004 Device 001: ID 1d6b:0002 Linux Foundation 2.0 root hub
Bus 007 Device 001: ID 1d6b:0001 Linux Foundation 1.1 root hub
Bus 003 Device 001: ID 1d6b:0002 Linux Foundation 2.0 root hub
Bus 006 Device 001: ID 1d6b:0001 Linux Foundation 1.1 root hub
Bus 002 Device 001: ID 1d6b:0002 Linux Foundation 2.0 root hub
Bus 005 Device 001: ID 1d6b:0001 Linux Foundation 1.1 root hub
Bus 001 Device 002: ID 1a40:0101 Terminus Technology Inc. Hub
Bus 001 Device 001: ID 1d6b:0002 Linux Foundation 2.0 root hub
```

```
biqu@BTT-CB1:~/klipper$ python3 ~/katapult/scripts/flash_can.py -q
ERROR:root:Flash Error
Traceback (most recent call last):
  File "/home/biqu/katapult/scripts/flash_can.py", line 487, in run_query
    self.cansock.bind((intf,))
OSError: [Errno 19] No such device

During handling of the above exception, another exception occurred:

Traceback (most recent call last):
  File "/home/biqu/katapult/scripts/flash_can.py", line 615, in main
    loop.run_until_complete(sock.run_query(intf))
  File "/usr/lib/python3.9/asyncio/base_events.py", line 642, in run_until_complete
    return future.result()
  File "/home/biqu/katapult/scripts/flash_can.py", line 489, in run_query
    raise FlashCanError("Unable to bind socket to can0")
FlashCanError: Unable to bind socket to can0
```

Any ideas? I've seen others saying the board is now bricked...

michmerr, 2024-04-04:
I'm having the same issue. In my case, I accidentally flashed the EBB toolhead images to the M8P, which started the problem. Flashing the M8P v2 bootloader and klipper images didn't seem to help. I get the same flash_can.py output, and the OpenMoko device is no longer in the lsusb output. I still have the can0 device config, but can0 doesn't show up in 'ip a' output, nor (predictably) can it be explicity started.

michmerr, 2024-04-04:
...and now I think I've resolved the issue.

Here's my deduced timeline.

- Flashed stock M8P with Klipper (successful)
- Flashed M8P with canboot and Klipper _intended for the EBB_ (successful flash, wrong target)
- Flashed EBB with canboot and Klipper (successful flash, validation script failed)
- Flashed M8P with V2 bootloader from this repo (successful)
- No can0 interface
- Flashed M8P with Klipper (incorrectly!)
- No can0 interface

Upon review, I _think_ that my last flash of Klipper to the M8P was misconfigured. Instead of configuring the communication interface to "USB to CAN bus bridge (USB on PA11/PA12)", I think might have set it to "CAN bus (on PD0/PD1)". Maybe. (The config was overwritten by the one for the EBB image, and I could not remember what the previous day's config had been for sure.)

I just rebuilt the Klipper image for the M8P, making sure to set the communication interface to "USB to CAN bus bridge (USB on PA11/PA12)" and the CAN bus interface (which only shows up in the config after setting the communication interface to "USB to CAN bus bridge (USB on PA11/PA12)") to "CAN bus (on PD0/PD1)".

On flash later, and can0 is visible again, and the validation scripts dump the uuids for both the M8P and EBB nodes of the CAN bus.

Hopefully this helps anyone else that got into the same condition via the same set of mistakes.

charchess, 2024-04-05:
Hi,
not sure about your issue but I found this about canbus : https://canbus.esoterical.online
I was struggling with can, can to bridge and so (EBB42 and M8P) and ...this is just THE guide on how to make it work, I went thoruhg this step by step and ...it just finally worked, this guide is amazing and should be put forward for anyone that want to do some CAN bus implementation,

hope it'll help

garethbradley, 2024-04-05:
I'm glad you got it sorted @michmerr - I was just coming on here to confirm that it is fixable (at least I got it working again) but failed to keep any notes as to how!

manotroll, 2024-04-28:
I don't want to use can mode just usb standard mode

manotroll, 2024-04-28:
I found the solution to the problem in a video on YouTube, I'll put it here so you can see
There is an error in the PDF explanation in the manual on how to do it
https://www.youtube.com/watch?v=k8DmTrY2GgY

TheBinaryLoop, 2024-05-12:
None of the solutions above solved it for me. I still can't see the device as an usb device (canbus disabled). Any other helpful tips?

Thread 108 (2024-02-24):

Trying to use M8P as canbus, but it seems that canbus firmware overwrites the M8P firmware each time, followed a guide to fix it, but it is no longer working

EarlyMorningDesigns, 2024-02-24:
Currently struggling with the canbus output on the M8P. At this point, I am planning on getting a U2C and using the M8P as just the main board. Whenever I follow the guide, it seems like the Canbus Klipper firmware overwrites the firmware for the board itself, turning it into just a giant U2C board. I followed this [guide](https://klipper.discourse.group/t/problems-with-btt-manta-m8p-bootloader/9159/3) to fix it, and it would work until I flashed the canbus firmwares as per the BTT github guide, and then my config file would no longer work until I fixed it with the bootloader guide. Now it's not working at all.  Is my board bricked? Do I contact BTT? Did anyone else have this issue and work through it?

stigmat4j, 2024-03-13:
Some problem

Thread 110 (2024-03-18):

手册中的修订历史未反映文档的变更 / Revision Log in manuals does not reflect changes to documents

brianredbeard, 2024-03-18:
在 9edb249b 中,对 v2.0 手册的两个版本都进行了更改,但这些更改并未反映在修订历史中。 当您未能更新文档时,修订历史就变得毫无意义。它在文档版本之间没有任何有意义的表达,用户也无法知道他们是否拥有文档的最新版本。

-----

In 9edb249b changes were introduced to both versions of the v2.0 manual and are not reflected in the Revision Log/修订历史.
When you fail to update the document it makes the Revision Log/修订历史 pointless.  It expresses nothing meaningful between versions of the document and users have no idea if they have the latest revision of the document.

Thread 111 (2024-03-31):

Manta M8P V2 -PWM / Tach-Pins swapped-

oMTEo, 2024-03-31:
While Im on setting up PWM-Fans on my new Manta-M8P-V2 I´ve found 2 wrong pin-definitions in the manual for FAN5 and FAN6.

PWM and Tacho-pins are swapped ! (I´ve cross-checked with the schematics)

Please check and correct all files and give me some salary for hours of exploring bugs on your products :)

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

oMTEo, 2024-04-01:
Dear BTT, you forgot page 19...

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

looxonline, 2024-04-02:
Fixed

bigtreetech, 2024-04-02:
Docs updated. Thanks for pointing this out.

Closed 2024-04-02.

Thread 112 (2024-04-14):

M8p v2 + CB1 v2.2 bootloader issues; no serial connection

cribbageSTARSHIP, 2024-04-14:
Good day.

I can get the cb1 to boot but the firmware.bin is never picked up by the sdcard reader. I've tried DFU mode but it always errors out:

`biqu@BTT-CB1:~/klipper$ sudo dfu-util -a 0 -D ~/klipper/out/klipper.bin --dfuse-address 0x08000000:force:mass-erase -d 0483:df11
dfu-util 0.9

Copyright 2005-2009 Weston Schmidt, Harald Welte and OpenMoko Inc.
Copyright 2010-2016 Tormod Volden and Stefan Schmidt
This program is Free Software and has ABSOLUTELY NO WARRANTY
Please report bugs to http://sourceforge.net/p/dfu-util/tickets/

dfu-util: Invalid DFU suffix signature
dfu-util: A valid DFU suffix will be required in a future dfu-util release!!!
Opening DFU capable USB device...
ID 0483:df11
Run-time device DFU version 011a
Claiming USB DFU Interface...
Setting Alternate Setting #0 ...
Determining device status: state = dfuIDLE, status = 0
dfuIDLE, continuing
DFU mode device DFU version 011a
Device returned transfer size 1024
DfuSe interface name: "Internal Flash   "
Performing mass erase, this can take a moment
Downloading to address = 0x08000000, size = 29308
Download	[=========================] 100%        29308 bytes
Download done.
File downloaded successfully
biqu@BTT-CB1:~/klipper$ make flash FLASH_DEVICE=0483:df11
  Flashing out/klipper.bin to 0483:df11
sudo dfu-util -d ,0483:df11 -R -a 0 -s 0x8020000:leave -D out/klipper.bin

dfu-util 0.9

Copyright 2005-2009 Weston Schmidt, Harald Welte and OpenMoko Inc.
Copyright 2010-2016 Tormod Volden and Stefan Schmidt
This program is Free Software and has ABSOLUTELY NO WARRANTY
Please report bugs to http://sourceforge.net/p/dfu-util/tickets/

dfu-util: Invalid DFU suffix signature
dfu-util: A valid DFU suffix will be required in a future dfu-util release!!!
Opening DFU capable USB device...
ID 0483:df11
Run-time device DFU version 011a
Claiming USB DFU Interface...
Setting Alternate Setting #0 ...
Determining device status: state = dfuIDLE, status = 0
dfuIDLE, continuing
DFU mode device DFU version 011a
Device returned transfer size 1024
DfuSe interface name: "Internal Flash   "
Downloading to address = 0x08020000, size = 29308
Download	[=========================] 100%        29308 bytes
Download done.
File downloaded successfully
dfu-util: Error during download get_status

Failed to flash to 0483:df11: Error running dfu-util

If the device is already in bootloader mode it can be flashed with the
following command:
  make flash FLASH_DEVICE=0483:df11
  OR
  make flash FLASH_DEVICE=1209:beba

If attempting to flash via 3.3V serial, then use:
  make serialflash FLASH_DEVICE=0483:df11

make: *** [src/stm32/Makefile:111: flash] Error 255
`

manotroll, 2024-04-28:
It even records but even restarting it doesn't exit UFD mode

manotroll, 2024-04-28:
I found the solution to the problem in a video on YouTube, I'll put it here so you can see
There is an error in the PDF explanation in the manual on how to do it
https://www.youtube.com/watch?v=k8DmTrY2GgY

Ivzo, 2024-05-16:
same, no serial after flashing bootloader.

MBOKjr, 2024-06-26:
Same here, I even tried what the video showed to do that @manotroll posted.

I'm using CANBus so the UUID took it's place, but the fact that we still can't get it persists.

royalfifty8, 2024-06-27:
Also having issue. Video posted by @manotroll helps, kinda. But does not solve the issue. Tried reaching out to BIGTREETECH but never got a reply.

lavidaesrecorta, 2024-12-17:
I know I'm kinda late but I had the same problem. It was the CB1 not well seated.

I realized this when I was not able to see any USB serial, so I gave a little tap to the CB1 on the side next to the mini-HDMI ports and dmesg showed that I had connected (and immediatly disconnected) varoius USB devices.

Use `dmesg -HW` and connect a USB device to the M8P ports, if nothing shows you might have to re-seat the board.

After re-seated, I could still not see the `/dev/serial` directory, but I could see `Terminus Technology Inc. Hub` using `lsusb` (It was not available before re-seating). If you see that, you can follow the method shared by @manotroll.

Because the video is in german and I don't want people to fry their boards, here is what you have to do (Or you can watch the [video](https://youtu.be/k8DmTrY2GgY?si=LaNvqh3wWt9HQ9PF&t=463) and follow like me, he does this at 7:45):

1.- Put the MCU in DFU mode (Hold BOOT0 and tap the RESET). You may want to use `dmesg -HW` in the CB1 via SSH before doing so, that way you can see the MCU connecting in DFU mode to the CB1

2.- Get the Internal Flash Address using `dfu-util -l`. This was my output:
`
Found DFU: [0483:df11] ver=0200, devnum=3, cfg=1, intf=0, path="2-1.4", alt=1, name="@Option Bytes   /0x5200201C/01*88 e", serial="364A37693331"
Found DFU: [0483:df11] ver=0200, devnum=3, cfg=1, intf=0, path="2-1.4", alt=0, name="@Internal Flash   /0x08000000/8*128Kg", serial="364A37693331"
`
As you can see, the Internal Flash Address is 0x08000000.

3.- Flash the board using the internal address that you got in the previous step:
`dfu-util -R -a 0 -s 0x08000000:mass-erase:force -D ~/klipper/out/klipper.bin`

4.- Power off and on again, after the reset you should be able to see the /dev/serial directory.

NOTE: After flashing and resetting, I get this new device in `lsusb`:
`Bus 002 Device 003: ID 1d50:614e OpenMoko, Inc. stm32h723xx`

If you see this device and still not seeing the /dev/serial directory, it may be an OS problem. It was not my case.

Good luck to everybody!

hiddengerbil, 2025-03-08:
> I found the solution to the problem in a video on YouTube, I'll put it here so you can see There is an error in the PDF explanation in the manual on how to do it https://www.youtube.com/watch?v=k8DmTrY2GgY

I don't speak any German, so this can't help me. Any English landguage solutions?

DaveuRrr, 2025-03-14:
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

I found myself in the same boat and followed the same steps as mentioned above but for me it did not work. The video was helpful since it mentions `dmesg -HW` and you can see your Manta board go into DFU mode.

My Manta was previous working but after doing maintenance to it (changing out the nozzle) it all of a sudden can't see the MCU. Is there a way to test to see if whatever communication method the Manta is using to communicate works? Flashing to DFU Mode seems like it's working but I still can't see it via `ls /dev/serial/by-id/*`

Not sure what else to do here, I don't want to buy a new board and end up with the same issue. :(

```linux
daveurrr@mainsail:~ $ sudo dfu-util -a 0 -D ./M8P_bootloader.bin --dfuse-address 0x08000000:force:mass-erase -d 0483:df11
dfu-util 0.9

Copyright 2005-2009 Weston Schmidt, Harald Welte and OpenMoko Inc.
Copyright 2010-2016 Tormod Volden and Stefan Schmidt
This program is Free Software and has ABSOLUTELY NO WARRANTY
Please report bugs to http://sourceforge.net/p/dfu-util/tickets/

dfu-util: Invalid DFU suffix signature
dfu-util: A valid DFU suffix will be required in a future dfu-util release!!!
Opening DFU capable USB device...
ID 0483:df11
Run-time device DFU version 011a
Claiming USB DFU Interface...
Setting Alternate Setting #0 ...
Determining device status: state = dfuIDLE, status = 0
dfuIDLE, continuing
DFU mode device DFU version 011a
Device returned transfer size 1024
DfuSe interface name: "Internal Flash   "
Performing mass erase, this can take a moment
Downloading to address = 0x08000000, size = 8064
Download        [=========================] 100%         8064 bytes
Download done.
File downloaded successfully
```

DaveuRrr, 2025-03-30:
I was able to get my M8P to work after following [Manta M8P & BTT EBB SB22XX](https://forum.vorondesign.com/threads/manta-m8p-btt-ebb-sb22xx-setup.1697/)

Since I am using CAN BUS, I need to flash my EBB36 and my Manta M8P but I am also using a U2C. When looking at the instructions and referencing back from what I remember, I only flashed the Manta M8P once when I set up CAN BUS for the first time with canboot. I flashed not really knowing what I was doing but following the thread mentioned above I was able to get my Manta working again. We are flashing in 2 spots. `0x08000000` which is for katapult / canboot and `0x08002000` is for klipper on the Manta. Once I did that it all started working again. It would be great if tutorials would explain what the commands are doing. Most of us are just copy & pasta'ing code / commands and expecting things to just work without understanding the context of the command. Oh well.

I hope someone finds the link useful as it worked for me.

Thread 113 (2024-04-23):

m8p / cb1   extruder not working

lkelley52, 2024-04-23:
can not get the extruder to work. if i plug the extruder motor in to one of the axis’s motor it moves . so motor is good. i have the extruder plugged into motor 5 on the board. i have checked wiring. no breaks and wired correctly, board pins good.

Motor5
[extruder]
step_pin: PG13
dir_pin: PG12
enable_pin: !PG15
microsteps: 16
rotation_distance: 33.500
full_steps_per_rotation:200
nozzle_diameter: 0.4
filament_diameter: 1.75
heater_pin: PA0 # HE0
sensor_pin: PB0 # T0
sensor_type: Generic 3950
control: pid
pid_Kp: 22.2
pid_Ki: 1.08
pid_Kd: 114
min_temp: 0
max_temp: 250

[klippy (3).log](https://github.com/bigtreetech/Manta-M8P/files/15082675/klippy.3.log)

Seriy2103, 2024-11-02:
I have same issue. Stepper motor and wiring are good but on M5-M8 extruder not working. Any one have some solutions ?

royalfifty8, 2024-11-02:
Have you done your configuration checks? Looking at klippy log, it looks like your extruder is not hot enough. As a safety feature Klipper wont allow extruder to work below a certain temp. You can check to see that the motor is working by verifying your tepper motors. Use STEPPER_BUZZ command. For extruder it will be (STEPPER=extruder). Make sure there is no filament loaded before doing so. Otherwise ring up your heater to extruder temps and then try extruding some material.b

royalfifty8, 2024-11-02:
@Seriy2103  When setting up Klipper. This step is important, as it allows you to safely verify everything is working without damaging your printer and/or its components.
https://www.klipper3d.org/Config_checks.html

Seriy2103, 2024-11-04:
I did everything as described in the guide, nothing helped. Most likely, something is wrong with the pins step_pin, dir_pin and enable_pin. Everything else works correctly.

rhiz0matic, 2025-05-26:
Same issue but with cb2 has anyone figured it out?

rhiz0matic, 2025-05-26:
I figured it out

There are 8 stepper motor drivers
BUT there are 9 stepper motor ports/plugs for a stepper z/1 on driver 3

So to correct it, corresponding stepper motor plugs go
- Plug 1 Driver 1 Motor 1 Stepper x
- Plug 2 Driver 2 Motor 2 Stepper y
- Plug 3 Driver 3 Motor 3a Stepper z
- Plug 4 Driver 3 Motor 3b Stepper z1
- Plug 5 (NA)     Motor 4 (Stepper NA)
- Plug 6 Driver 5 Motor 5 Stepper Extruder

So I plugged my Motor 5 into Plug 5 but it should go into Plug 6

Thread 114 (2024-05-06):

Manta m8p v1.1+ cb1 errno 100

Skipperin0, 2024-05-06:
I am currently trying to make canbus work on my bigtreetech m8p with cb1 and the sb 2209. While following online guides I am able to follow every step succesfully (so I think) untill it's time to run the command to get the UUID: ~/klippy-env/bin/python ~/klipper/scripts/canbus_query.py can0
 When I run this command I get this response:
biqu@BTT-CB1: ~/klipper$  ~/klippy-env/bin/python ~/klipper/scripts/canbus_query.py can0
Traceback (most recent call last):
  File "/home/biqu/klippy-env/lib/python3.9/site-packages/can/interfaces/socketcan/socketcan.py", line 679, in _send_once
    sent = self.socket.send(data)
OSError: [Errno 100] Network is down

During handling of the above exception, another exception occurred:

Traceback (most recent call last):
  File "/home/biqu/klipper/scripts/canbus_query.py", line 64, in <module>
    main()
  File "/home/biqu/klipper/scripts/canbus_query.py", line 61, in main
    query_unassigned(canbus_iface)
  File "/home/biqu/klipper/scripts/canbus_query.py", line 25, in query_unassigned
    bus.send(msg)
  File "/home/biqu/klippy-env/lib/python3.9/site-packages/can/interfaces/socketcan/socketcan.py", line 658, in send
    sent = self._send_once(data, msg.channel)
  File "/home/biqu/klippy-env/lib/python3.9/site-packages/can/interfaces/socketcan/socketcan.py", line 681, in _send_once
    raise can.CanError("Failed to transmit: %s" % exc)
can.CanError: Failed to transmit: [Errno 100] Network is down

I am obviously missing something, but I can't seem to find out what I'm doing wrong. Is there anybody who can point me in the right direction?

Closed 2024-05-09.

Thread 115 (2024-05-13):

Forcing motor movement seems to have an impact on the I2C connection.

linw1995, 2024-05-13:
board: manta-m8p v2

```cfg
## Z0 Stepper - Front Left on MOTOR3_A
[stepper_z]
step_pin: PB8
dir_pin: PB7
enable_pin: !PE0
# Rotation Distance for TR8x8 = 8, TR8x4 = 4, TR8x2 = 2
rotation_distance: 8
microsteps: 128
endstop_pin: probe:z_virtual_endstop
##  Z-position of nozzle (in mm) to z-endstop trigger point relative to print surface (Z0)
##  (+) value = endstop above Z0, (-) value = endstop below
##  Increasing position_endstop brings nozzle closer to the bed
##  After you run Z_ENDSTOP_CALIBRATE, position_endstop will be stored at the very end of your config
## All builds use same Max Z
position_max: 250
position_min: -5
homing_speed: 8.0 # Leadscrews are slower than 2.4, 10 is a recommended max.
second_homing_speed: 3
homing_retract_dist: 3

##	Make sure to update below for your relevant driver (2208 or 2209)
[tmc2209 stepper_z]
uart_pin: PB9
interpolate: false
run_current: 0.9
sense_resistor: 0.110
stealthchop_threshold: 0

##	Z1 Stepper - Rear  on Motor6
[stepper_z1]
step_pin: PG9
dir_pin: PD7
enable_pin: !PG11
# Rotation Distance for TR8x8 = 8, TR8x4 = 4, TR8x2 = 2
rotation_distance: 8
microsteps: 128

##	Make sure to update below for your relevant driver (2208 or 2209)
[tmc2209 stepper_z1]
uart_pin: PG10
interpolate: false
run_current: 0.9
sense_resistor: 0.110
stealthchop_threshold: 0

##	Z2 Stepper - Front Right on Motor7
[stepper_z2]
step_pin: PD4
dir_pin: PD3
enable_pin: !PD6
# Rotation Distance for TR8x8 = 8, TR8x4 = 4, TR8x2 = 2
rotation_distance: 8
microsteps: 128

##	Make sure to update below for your relevant driver (2208 or 2209)
[tmc2209 stepper_z2]
uart_pin: PD5
interpolate: false
run_current: 0.9
sense_resistor: 0.110
stealthchop_threshold: 0

[temperature_sensor 打印仓-Corner]
sensor_type: BME280 # BMP388
i2c_address: 119
i2c_software_scl_pin: PA8
i2c_software_sda_pin: PC9
```

After completing the printing of large part models, Klippy unexpectedly entered shutdown mode as I was moving the build plate away from the bed. Interestingly, this issue doesn't occur when printing smaller models.

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

```
Klippy changed state to shutdown
MCU 'mcu' shutdown: soft_i2c NACK
```

Thread 116 (2024-06-03):

M8P v2 + CB1 file system read only

Kiri11ll, 2024-06-03:
Good afternoon
I'm still assembling my printer. I discovered a problem that the operating system often detects partitions in read-only mode after shutting down or rebooting. Please tell me how to deal with this.
I usually turn it off with the command "sudo shutdown".

Thread 117 (2024-06-26):

MANTA M8P V2.0 | UART and DIAG Pinouts Missing/Not Clearly Called out

MBOKjr, 2024-06-26:
UART pins:

- Not called out in the BIGTREETECH MANTA M8P V2.0 User Manual.pdf Pin Description diagram sheet 8
- These pins ARE called out in the generic-bigtreetech-manta-m8p-V2_0.cfg file for all motors

**Are these UART pins being called out in the BIGTREETECH MANTA M8P V2.0 User Manual.pdf Pin Description as "CS"?**

---

DIAG pins:

- Not called out in the BIGTREETECH MANTA M8P V2.0 User Manual.pdf Pin Description diagram sheet 8
- These pins ARE called out in generic-bigtreetech-manta-m8p-V2_0.cfg for M1 through M4, but NOT for M5 and M6

**Are these DIAG pins the same pins being called out in the BIGTREETECH MANTA M8P V2.0 User Manual.pdf Pin Description as the PF pins shown in the END-STOP table?**

- M1 DIAG pin matches END-STOP pin PF4
- M2 DIAG pin matches END-STOP pin PF3
- M3 DIAG pin matches END-STOP pin PF2
- M4 DIAG pin matches END-STOP pin PF1
- M5 DIAG pin could be END-STOP pin PF0?
- M6 DIAG pin could be END-STOP pin PC15?
- M7 DIAG pins = none on the board
- M8 DIAG pins = none on the board

---

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

Thread 118 (2024-06-26):

CanBus with Hermit Crab 2.0

Silvered87, 2024-06-26:
Hi.
I flashed Katapult with no problems.
Problem occurs when I try to detect can device:
`biqu@BTT-CB1:~/katapult/scripts$ python3 flashtool.py -i can0 -q`
Instead of device UUID i get:
`ERROR:root:Flash Error
Traceback (most recent call last):
  File "/home/biqu/katapult/scripts/flashtool.py", line 491, in run_query
    self.cansock.bind((intf,))
OSError: [Errno 19] No such device

During handling of the above exception, another exception occurred:

Traceback (most recent call last):
  File "/home/biqu/katapult/scripts/flashtool.py", line 619, in main
    loop.run_until_complete(sock.run_query(intf))
  File "/usr/lib/python3.9/asyncio/base_events.py", line 642, in run_until_complete
    return future.result()
  File "/home/biqu/katapult/scripts/flashtool.py", line 493, in run_query
    raise FlashCanError("Unable to bind socket to can0")
FlashCanError: Unable to bind socket to can0`
What do I do now?
120R Jumper is put on both boards.

Thread 119 (2024-07-02):

Controlling Pi Fan with CB2 and M8P V2

cin3m, 2024-07-02:
Is anyone running the configuration with an CB2 and the M8P V2? Currently I'm trying to control the speed of the Pi Fan through Klipper.

Sadly according to the documentation of both boards the required Pin should be **gpiochip0/gpio19**.

The mcu is installed as required for the access of the GPIO pins.

Klipper is also listed in the output of **gpioinfo**

Regardless of the configuration the fan runs at 100% speed.

Life0fBrian, 2024-07-16:
I have a M8P v2 and CB2 running and after your post here it get it working.
My CB2 is defined as
```
[mcu CB2]
serial: /tmp/klipper_host_mcu

```
and the PI-fan:
```
[fan_generic pi_fan]
pin: CB2: gpiochip0/gpio19
max_power: 1.0
kick_start_time: 0.5
cycle_time: 0.02

```
This works fine and lets me control the fan if needed.

Thread 120 (2024-07-21):

Manta M8P V2.0 CAD file has wrong dimensions for stepper sockets

NuclearKitty, 2024-07-21:
The stepper sockets in the M8P V2.0 CAD file are drawn in as being 8.5mm tall, while in the real world there are 11mm tall sockets on the board.

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

This has lead to a cooling shroud I was designing for the board not fitting in real life due to the drivers sitting 2.5mm higher then in the CAD file.

Thread 121 (2024-07-25):

M8P V2.0 3D is not V2.0 board, shows F429

K2AAE, 2024-07-25:
While looking at the STEP file for M8P V2.0 it has F429 on the CPU - It should be H723, I can not find ANY version of M8P with a F429 - if it has the wrong CPU what else?

NuclearKitty, 2024-08-25:
The CAD has multiple issues. Wrong MCU identifier (but right dimensions), wrong pin header height for stepper drivers, wrong power terminals. But it doesnt look like BTT cares about it...

Thread 122 (2024-07-31):

make fans work on m8p

kmjr20, 2024-07-31:

kmjr20, 2024-07-31:
I have followed the klipper directions and can't seem to get the fans to rturn on. Sometimes it says error PB1 already used, or heater already used when i try to hook up the dual extruder with hotend and hot end fan

kmjr20, 2024-07-31:
I have followed the klipper directions and can't seem to get the fans to turn on. Sometimes it says error PB1 already used, or heater already used when i try to hook up the dual extruder with hotend and hot end fan

Thread 123 (2024-08-08):

Powering CM4 on Manta M8P v2.0

tekknix, 2024-08-08:
Hi,

i've a short question about powering the CM4 on the Manta M8P V2.0 via USB (I've set the USB-PowerJumper).

With a 5v only Powersupply i can run and program the CM4 without any issues (some undervolting-Messages from the CM4 but in general it's working).

After finish, programming and setup to go live in my Printer, i've put everything underneath my Printer (Exchange my existing LDO Leviathan with Pi5) and tried again to power it up via USB. But with the Pi5 PowerSupply. Nothing happens. It seems that every Power-Supply which delivers more as 5V only will lead to no power at all.

I've tried again 3 different PowerSupplies with PD and QD/QC and no one powers up the CM4 and Board. If i use the simple 5V-only PowerSupply it starts up.

Any thoughts on this?

Regards
MoS-tekknix

bigtreetech, 2024-08-08:
Definitely won't work with the Pi 5 supply. That supply won't work with most things other than a Pi 5. I am not sure what negotiation they have within it but it seems as if it will only ever put out a voltage if there is a PD chip on the other end and it is set to negotiate to the voltage and power levels that the Pi 5 expects. The M8P series does not have a PD chip for negotiation (the 5V rail should never have more than 5V on it otherwise, boom) and it is not really designed to be powered primarily from the USB port. That is a convenience included for programming. It is designed to be powered from the main voltage input via a step down regulator.

Closed 2024-08-08.

Thread 124 (2024-08-08):

New Manta M8p v2.0 CAN not working

tekknix, 2024-08-08:
Hi,

i've exchanged my LDO Leviathan v1.2 Board against the Manta M8p V2.0

Before the Leviathan i've had running a Manta M8p v1.0 and U2c V2.1 and an EBB36 v1.2 via CAN.

Flashing the Manta with Katapult and Klipper was no problem. The Can-Bridge is working and i can see the UUID of the Manta.

I've tried to connect the EBB36 flashed with Katapult, but the Manta will not detect the Toolhead-Board.

I've tried to flash the EBB36 PreCompiled Firmware but this leads to the Problem, that after Connecting the CAN-Bus UUID of the Manta will also not shown up.

Output of LSUSB:

```
Bus 001 Device 004: ID 1d50:606f OpenMoko, Inc. Geschwister Schneider CAN adapter
Bus 001 Device 003: ID 04d8:e72b Microchip Technology, Inc. Beacon RevH
Bus 001 Device 002: ID 1a40:0101 Terminus Technology Inc. Hub
Bus 001 Device 001: ID 1d6b:0002 Linux Foundation 2.0 root hub
```

Out of canbus-Query:

```
tekknix@Reborn2Pro:~ $ ~/klippy-env/bin/python ~/klipper/scripts/canbus_query.py can0
Total 0 uuids found
```

Directly after PowerOn i can see the UUID at least from Manta but after a few seconds it's gone:

```
Last login: Thu Aug  8 14:03:26 2024 from 192.168.1.12
tekknix@Reborn2Pro:~ $ python3 ~/klipper/lib/canboot/flash_can.py -q
Resetting all bootloader node IDs...
Checking for canboot nodes...
Detected UUID: 212fadcb00b4, Application: Klipper
Query Complete
tekknix@Reborn2Pro:~ $ python3 ~/klipper/lib/canboot/flash_can.py -q
Resetting all bootloader node IDs...
Checking for canboot nodes...
Detected UUID: 212fadcb00b4, Application: Klipper
Query Complete
tekknix@Reborn2Pro:~ $ python3 ~/klipper/lib/canboot/flash_can.py -q
Resetting all bootloader node IDs...
Checking for canboot nodes...
Query Complete
tekknix@Reborn2Pro:~ $ python3 ~/klipper/lib/canboot/flash_can.py -q
Resetting all bootloader node IDs...
Checking for canboot nodes...
Query Complete
```

Any help i appreciate.

Regards
MoS-tekknix

bigtreetech, 2024-08-08:
UUIDs will disappear as soon as the klipper service uses them. This is documented in the klipper documentation.

If you have these UUIDs listed in the cfg file then they will disappear. They will still be accessible by the katapult flashtool though.

tekknix, 2024-08-08:
Please don't close Issues which are not solved. That's not the Idea.

Anyhow, i know how to switch off klipper before trying to list my CAN-Bus Devices (sudo systemctl stop klipper.service)

And additional without getting an UUID of the Board i'm not able to flash it via katapult, cause it can't reset to bootloader.

```
tekknix@Reborn2Pro:~/klipper $ python3 ~/klipper/lib/canboot/flash_can.py -q
Resetting all bootloader node IDs...
Checking for canboot nodes...
Query Complete
```

`~/klippy-env/bin/python ~/katapult/scripts/flashtool.py -i can0 -u 212fadcb00b4 -r
`

Where 212fadcb00b4 is the uuid the board offers directly after restart before it's gone away.

Therefore either the CAN-Mapping of PD0/PD1 as CAN - PINs is wrong for my Manta M8p V2.0 or the CAN isn't working at all.

Regards
MoS-tekknix

bigtreetech, 2024-08-08:
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

CAN is working by virtue of the fact that it appears after boot. Even stopping the klipper service will not cause it to reappear. Once it has been consumed, it is consumed. You need to remove it from the klipper config and reboot.

tekknix, 2024-08-08:
Thanks for Reopening this Issue.

I've removed the MCU-Entries completely from my printer.cfg but the issue will be the same.

Maybe you've an additional idea?

I've meassure the correct wiring from my Can-Cable, everything is right. As soon as i disconnect the EBB36, the UUID of the Manta will not disappear.

And i've 2 working EBB36 to test with. I've tried both of them, Flashed the orignal Firmware for CAN-Usage (Firmware_can.bin) via STM32.

bigtreetech, 2024-08-08:
Ensure that you have your termination resistors correctly installed.

tekknix, 2024-08-08:
I've set the Jumper on EBB36 and also the Manta

bigtreetech, 2024-08-08:
Running through a CAN bridge can be tricky. You can't program your motherboard directly using Katapult because it will register as a USB device as soon as it enters the bootloader. I have also noticed that even using the -r command parameter sometimes results in the board jumping straight back into the application as soon as it enters katapult and the only way I can get new firmware onto it is by using DFU mode.

As for the UUIDs disappearing when you plug in the EBB, that does sound as if they are being found and consumed. Try removing klipper completely using KIAUH (saving your configs), rebooting and then seeing if the UUIDs can be seen.

Also ensure that you used the correct communication settings for both katapult and the main firmware on the EBB and the mainboard (Mainboard should be USB in katapult and CAN in the main klipper fw. EBB should be CAN in both). Ensure that the buffer is 1024 in length within the linux config file and that the baud in the config file matches the baud in all firmware config.

Aside from those points, there could be a number of unique implementation issues. Github is not an official support channel for our products. It is a place where we monitor for firmware bugs, feature requests and confirmed hardware issues. For support please contact support003@biqu3d.com and quote this link.

tekknix, 2024-08-08:
Hi, unfortunately i'm getting back an Error-Message that this Email-Adresse either does not exists or that i'm not allowed to send something to you:

host mxbiz1.qq.com [103.86.78.3:25] said: Mailbox unavailable or access
              denied
              [MM26xUelqNM/GlHlV5vGWiq4eeKDisoOC/0PK741IdkZHDYFes8lK5M=
               IP: 81.169.146.217].
              https://open.work.weixin.qq.com/help2/pc/20057.

bigtreetech, 2024-08-08:
> Hi, unfortunately i'm getting back an Error-Message that this Email-Adresse either does not exists or that i'm not allowed to send something to you:
>
> host mxbiz1.qq.com [103.86.78.3:25] said: Mailbox unavailable or access denied [MM26xUelqNM/GlHlV5vGWiq4eeKDisoOC/0PK741IdkZHDYFes8lK5M= IP: 81.169.146.217]. https://open.work.weixin.qq.com/help2/pc/20057.

Pop a ticket off. It's easier than email: https://biqu3d.com/pages/submit-a-ticket

tekknix, 2024-08-08:
I like to try, but

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

bigtreetech, 2024-08-08:
Doh! I'll get the ticketing system fixed as soon as people are in at the office tomorrow morning.

bsivley, 2025-01-13:
was there ever a resolution to this IM having a very similar issue

looxonline, 2025-01-13:
> was there ever a resolution to this IM having a very similar issue

If you follow the thread you'll notice that the UUIDs disappearing was not a flaw but rather how the functionality is supposed to work. The Klipper and Katapult are great resources for this kind of documentation.

Closed 2024-08-08.

Thread 125 (2024-08-08):

Please don't close Issues which are not solved. That's not the Idea.

tekknix, 2024-08-08:
Please don't close Issues which are not solved. That's not the Idea.

Anyhow, i know how to switch off klipper before trying to list my CAN-Bus Devices (sudo systemctl stop klipper.service)

And additional without getting an UUID of the Board i'm not able to flash it via katapult, cause it can't reset to bootloader.

```
tekknix@Reborn2Pro:~/klipper $ python3 ~/klipper/lib/canboot/flash_can.py -q
Resetting all bootloader node IDs...
Checking for canboot nodes...
Query Complete
```

`~/klippy-env/bin/python ~/katapult/scripts/flashtool.py -i can0 -u 212fadcb00b4 -r
`

Where 212fadcb00b4 is the uuid the board offers directly after restart before it's gone away.

Therefore either the CAN-Mapping of PD0/PD1 as CAN - PINs is wrong for my Manta M8p V2.0 or the CAN isn't working at all.

Regards
MoS-tekknix

_Originally posted by @tekknix in https://github.com/bigtreetech/Manta-M8P/issues/124#issuecomment-2275731460_

bigtreetech, 2024-08-08:
Duplicate of #124

Closed 2024-08-08.

Thread 126 (2024-08-28):

Manta M8P v1.1 BTT-CB1 2.3.3 Bullseye Linux 5.16.17-sun50iw9 does not update MCU

AdeilnAcinrst, 2024-08-28:
I tried to update using make flash and SD card, no way to have it updated.

```MCU Protocol error

This is frequently caused by running an older version of the
firmware on the MCU(s). Fix by recompiling and flashing the
firmware.

Your Klipper version is: v0.12.0-286-g81de9a861
MCU(s) which should be updated:
CB1: Current version v0.11.0-241-gffb5105b
adxl: Current version rampon_anchor
Up-to-date MCU(s):
mcu: Current version v0.12.0-286-g81de9a861

Once the underlying issue is corrected, use the "RESTART"
command to reload the config and restart the host software.

mcu 'adxl': Command format mismatch: query_adxl345 oid=%c rest_ticks=%u vs query_adxl345 oid=%c clock=%u rest_ticks=%u
```

I have these versions showing on mainsail:

mcu(stm32g0b1xx)
Version: v0.12.0-286-g81de9a861
Load: 0.01, Awake: 0.00, Freq: 64 MHz,

mcu CB1(linux)
Version: v0.11.0-241-gffb5105b
Load: 0.02, Awake: 0.00, Freq: 50 MHz,

Host(aarch64, 64bit)
Version: v0.12.0-286-g81de9a861
OS: Debian GNU/Linux 11 (bullseye)
Load: 0.41, Mem: 297.6 MB / 986.9 MB , Temp: 49°C
wlan0 (192.168.0.125) : Bandwidth: 2.4 kB/s , Received: 1.8 MB , Transmitted: 26.3 MB

I tried to follow the manual instructions:

```biqu@BTT-CB1:~/klipper$ make
make: Nothing to be done for 'all'.
biqu@BTT-CB1:~/klipper$ ls -ltra /dev/serial/by-id/
total 0
lrwxrwxrwx 1 root root 13 Aug 28 10:17 usb-Anchor_Rampon-if00 -> ../../ttyACM0
drwxr-xr-x 4 root root 80 Aug 28 10:17 ..
lrwxrwxrwx 1 root root 13 Aug 28 10:39 usb-Klipper_stm32g0b1xx_10001A000E504B4633373520-if00 -> ../../ttyACM1
drwxr-xr-x 2 root root 80 Aug 28 10:39 .
biqu@BTT-CB1:~/klipper$ make flash FLASH_DEVICE=/dev/serial/by-id/usb-Klipper_stm32g0b1xx_10001A000E504B4633373520-if00
  Flashing out/klipper.bin to /dev/serial/by-id/usb-Klipper_stm32g0b1xx_10001A000E504B4633373520-if00
Entering bootloader on /dev/serial/by-id/usb-Klipper_stm32g0b1xx_10001A000E504B4633373520-if00
Device reconnect on /sys/devices/platform/soc/5200000.usb/usb2/2-1/2-1.4/2-1.4:1.0
sudo dfu-util -p 2-1.4 -R -a 0 -s 0x8002000:leave -D out/klipper.bin

dfu-util 0.9

Copyright 2005-2009 Weston Schmidt, Harald Welte and OpenMoko Inc.
Copyright 2010-2016 Tormod Volden and Stefan Schmidt
This program is Free Software and has ABSOLUTELY NO WARRANTY
Please report bugs to http://sourceforge.net/p/dfu-util/tickets/

dfu-util: Invalid DFU suffix signature
dfu-util: A valid DFU suffix will be required in a future dfu-util release!!!
Opening DFU capable USB device...
ID 0483:df11
Run-time device DFU version 011a
Claiming USB DFU Interface...
Setting Alternate Setting #0 ...
Determining device status: state = dfuIDLE, status = 0
dfuIDLE, continuing
DFU mode device DFU version 011a
Device returned transfer size 1024
DfuSe interface name: "Internal Flash   "
Downloading to address = 0x08002000, size = 30880
Download	[=========================] 100%        30880 bytes
Download done.
File downloaded successfully
dfu-util: Error during download get_status

Failed to flash to /dev/serial/by-id/usb-Klipper_stm32g0b1xx_10001A000E504B4633373520-if00: Error running dfu-util

If the device is already in bootloader mode it can be flashed with the
following command:
  make flash FLASH_DEVICE=0483:df11
  OR
  make flash FLASH_DEVICE=1209:beba

If attempting to flash via 3.3V serial, then use:
  make serialflash FLASH_DEVICE=/dev/serial/by-id/usb-Klipper_stm32g0b1xx_10001A000E504B4633373520-if00

make: *** [src/stm32/Makefile:111: flash] Error 255
```

It errors as mentioned in the manual, but ignoring it doesn't solve the issue, the firmware is not updated.

I formatted a SD card using FAT with compiled firmware renamed to firmware.bin and it doesn't update. I tried to press BOOT and RESET buttons, no success.

Thread 127 (2024-09-08):

LEDs, Strip lights, Neopixels

KD-4-Lyfe, 2024-09-08:
Need to know if i need an external PSU or not.

What is the Max amps allowed by the manta M8P V2

was planning running  2 lots of about 30 RGBW WS2812B down either side of my printer and maybe  smaller progress bar.

bigtreetech, 2024-09-09:
Don't go over 2A since that rail is also powering the SBC.

KD-4-Lyfe, 2024-09-09:
Much appreciated, I'll run an external PSU, could I advise that be added the documentation also.

bigtreetech, 2024-09-09:
Good point. @BTTJUSTIN let's get this added to the manual. The specification is how much current the user can draw from the 5V rail.

oMTEo, 2024-09-09:
Dont Forget to look into this -> https://github.com/bigtreetech/Manta-M8P/issues/81

bigtreetech, 2024-09-09:
> Dont Forget to look into this -> #81

The provided response still stands. It is 100% accurate in spite of what the OP may think.

Closed 2024-09-09.

Thread 129 (2024-11-09):

Audio Hat compatibility

KanduWorkshop, 2024-11-09:
If I am using the pi CM4, will any of the audio hats work? I was looking at the Raspberry Pi DigiAMP+, but i think the power supply may be an issue, i may look at the Raspberry Pi DAC (pro maybe) for this board if the Raspberry Pi DigiAMP+ power connection will not work and use a separate amplifier to run my speakers. I use audio queues from klipper if the printer cancels or has issues.

bigtreetech, 2024-11-11:
The 40 pin GPIO output is according to the RPi standard so it should work. The PSU can supply around 1.5 - 2A of continuous current.

Closed 2024-11-11.

Thread 130 (2024-11-14):

Z3 issue with V1 Voron v2 Config

Hobbss27, 2024-11-14:
##	Z3 Stepper - Front Right on Motor6
[stepper_z3]
step_pin: PA10
dir_pin: !PD15
enable_pin: !PA15
rotation_distance: 40
gear_ratio: 80:16
microsteps: 16

BUt the dir_pin should be !PD14

Thread 133 (2025-02-07):

M8Pv2+CB2 Tmc2130 steps problem

djlukes, 2025-02-07:
Hi I have a problem with tmc2130 v3 drivers.
I pulled from stock these drivers running in SPI mode.
The problem manifests itself as follows, if I start printing, the printer homes and makes a Z-tilt (3 motors on the Z axis).
Within a few minutes when using the Z hop the drivers start to run and you can see that the layer is getting taller and thinner. After cancelling the print and restarting the Z-tilt I find that the difference is more than 0.15mm. When I pulled the TMC2209 drivers from the other printer the problem disappeared.
The same problem manifested itself on the XY, it is an AWD drive and there was a gradual shift so large that the step was skipped.
Thank you for any ideas on how to solve the problem.

Thread 135 (2025-02-12):

dev/serial/by-id/': No such file or directory"

Karl-Marx-666, 2025-02-12:
I'm having a issue with my m8p v2 with a cb2 and sb2209 usb. I can run through the setup process and everything goes well until I get to flashing the m8p. The klipper.bin is changed to firmware.bin but doesn't change when Insert the sd card, ans when I run serial by ID I get this "dev/serial/by-id/': No such file or directory". Any help would be greatly appreciated I'm ripping my hair out at this point

DaveuRrr, 2025-03-30:
Hello!

I found this thread a couple weeks back and was able to get my Manta up and running with the `dev/serial/by-id/`. Hopefully you find it helpful. [Manta M8P & BTT EBB SB22XX](https://forum.vorondesign.com/threads/manta-m8p-btt-ebb-sb22xx-setup.1697/)

The take away here was We are flashing in 2 spots. `0x08000000` which is for katapult / canboot and `0x08002000` is for klipper on the Manta.

Thread 137 (2025-03-03):

How to use Manta M8P v2 with 12864 display

WayneManion, 2025-03-03:
I have a Sovol SV08. I want to convert it to use a Manta M8P v2 that I already have. I don't like touch screens. I don't want to run KlipperScreen. I want to use an old-school 12864 display and control wheel.

What do I need to buy to be able to connect a 12864 display to this board? It doesn't have the normal EXP1+EXP2 connectors. As far as I can tell, the same pins are accessible through some kind of ribbon connector. How do I break this out to connect it to the normal EXP1+EXP2 connectors?

royalfifty8, 2025-03-05:
Yes you can use EXP connectors or I2C(only V2.0 for the old school's. You need to purchase either a CB1, CB2 or Raspberry Pi compute model or raspberry Pi 3,4, or 5. You will not being able to use HDMI or CSI interface otherwise. You can always remote from your computer as well. I do highly recommend grabbing yourself the CB1 at least. It's equivalent to the Raspberry Pi 3. Operating the board by itself tends to be a bit sluggish.

P.S. You might run into some speed bumps when flashing the board, If it gives you trouble with the boot loader, check out Dr.Klipper, he has a great step by step guide.

WayneManion, 2025-03-05:
After more research that should have been needed, I think I found the most straightforward solution.

BTT Mini12864 v2.0 displays have the same 18-pin 1.0mm-pitch FPC connector as the M8P. So the most elegant solution is to get a BTT Mini12864 v2.0 display and an 18-pin  1.0mm-pitch FPC cable and connect them that way.

I only have a couple Fysetc Mini 12864 v2.1 displays and several stock Ender 3 12864 displays on hand and none of them have the FPC connector. The product listing on Amazon for the BTT Mini12864 v2.0 doesn't show the FPC connector on the back (if you look closely at the Amazon listing's picture, it is screen printed "BIGTREETECH MINI12864 v1.0").

I believe all this to be true after squinting and counting pins on the M8P's FPC connector, measuring the width of the ribbon cable opening, and dividing the width by the pin count. This would have been a lot easier if BTT wrote better documentation. The docs for the M8P v2 and  the Mini12864 v2.0 both just call the connector an "FPC", leaving it to the user to count pins and measure pitches themselves.

royalfifty8, 2025-03-06:
I was going to mention I've tried messing with the Ender displays but ended up with the same issue and wasted time. And yes, I agree. Unfortunately, BTT's literature and CS don't possess the same grandeur as their boards do. Lol. Looking forward to what you come up!

WayneManion, 2025-03-11:
The BTT Mini12864 board does come with an 18-pin FPC 1mm-pitch cable that works with the Manta M8P.

Sadly, the included cable was too short for my application. I can't fault BTT for that. This printer is huge and I have the mainboard mounted at the back of the printer. I bought some longer cables on Amazon and confirmed that 18-pin, 1-mm pitch is the secret sauce. I had to order a 400mm cable from AliExpress for my printer.  The only one I could find in the US was from Digi-Key and it was $12 plus shipping.

Use this to get it working:
```
[display] # BTT Mini12864 v2.0 connected via FPC cable
lcd_type: uc1701
cs_pin: PG0
a0_pin: PF15
rst_pin: PF14
encoder_pins: ^PE10, ^PE15
click_pin: ^!PG1
contrast: 63
spi_software_miso_pin: PE13
spi_software_mosi_pin: PE14
spi_software_sclk_pin: PE12

[output_pin beeper]
pin: PE7

[neopixel mini12864] #	control Neopixel RGB in mini12864 display
pin: PF13
chain_count: 3
initial_RED: 0.1
initial_GREEN: 0.5
initial_BLUE: 0.0
color_order: RGB

##	Set RGB values on boot up for each Neopixel.
##	Index 1 = display, Index 2 and 3 = Knob
[delayed_gcode setdisplayneopixel]
initial_duration: 1
gcode:
  SET_LED LED=mini12864 RED=0 GREEN=1 BLUE=1 INDEX=1 TRANSMIT=0
  SET_LED LED=mini12864 RED=0 GREEN=1 BLUE=1 INDEX=2 TRANSMIT=0
  SET_LED LED=mini12864 RED=0 GREEN=1 BLUE=1 INDEX=3
```

Thread 138 (2025-03-06):

No matter what I do, Klipper install hangs with CB2

LiamWabbit, 2025-03-06:
Klipper works as as far as typing sudo nand-sata-install but I get past the format stage and it just hangs on counting files.
This is really winding me up now. I can't find any trouble shooting for this at all.
It klipper from BIQU itself. It should take 15 mins to install, I've wasted a day with it. Just trying to to find out how to fix it.
I've tried different SD cards. Even USB doesn't work with the manta. it read a port device, but the software from your site wont do any firmware stuff written in your instructions. Is there a fix for is, or should I send £150 worth of tech back!
It is not meant to be this difficult! Install klipper to the emmc and then install the firmware for manta board using klipper and ssh
The time I've spent on this is costing me money

bigtreetech, 2025-03-06:
Just a heads up that this is not related to installing klipper. It sounds like this is OS related. Please provide info about exactly what OS image you are trying to use and, if possible, even a picture of where you see it hanging.

In terms of manuals, we don't produce video manuals for most products. We produce written form documentation.

royalfifty8, 2025-03-06:
@LiamWabbit This should help. Along with a few other tabs on his website.

https://www-drklipper-de.translate.goog/doku.php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

Thread 139 (2025-03-24):

Unable to write tmc spi 'stepper_x' register CHOPCONF

Vicxke, 2025-03-24:
I am having an issue connecting my TMC2130 drivers to the M8P V2 board using SPI. I am getting the follwing error but I can't figure out why it's giving out this message "Unable to write tmc spi 'stepper_x' register CHOPCONF". I would think it has something to do with the communication but I can't find why. Anyone who had the same problem?

This is my config for the x axis:
`# X Axis with Sensorless Homing
[stepper_x]
step_pin: PE6
dir_pin: PE5
enable_pin: !PC14  # FIXED: No conflict
microsteps: 16
rotation_distance: 40
homing_speed: 50
homing_retract_dist: 3
endstop_pin: tmc2130_stepper_x:virtual_endstop  # Virtual endstop
endstop_pin: PF4
position_endstop: 0
position_max: 150

[tmc2130 stepper_x]
cs_pin: PC13
#spi_bus: spi1  # Use hardware SPI bus
spi_software_mosi_pin: PG6
spi_software_miso_pin: PG7
spi_software_sclk_pin: PG8
run_current: 2
stealthchop_threshold: 999999
spi_speed: 5000000
driver_SGT: 5
diag1_pin: PF4  # REQUIRED for virtual endstop
`

Closed 2025-03-26.

Thread 140 (2025-03-28):

Power BC2 separately on Manta m8p v2

LazaroFilm, 2025-03-28:
I am trying to keep my CB2 module on even when the 24v PSU to the Manta m8p v2 is off.
That would allow me to keep Klipper on to load gcodes and power the printer remotely with a relay lol I was doing with my old board and separate Pi (I had isolated the 5v line in the USB cable)
Is that possible? And if so how?

I have considered adding a 5V PSU (with common ground to the 24v PSU) to the GPIO.

Thread 141 (2025-04-21):

Issues with 48 power supply

gilbertorconde, 2025-04-21:
I've a manta m8p v2 on a voron 2.4. If im using the same 24v power supply on all board and motors everything works fine. If i add a 48v to the A/B Motors whenever the toolhead starts moving i get a disconnection error. Sometimes from the toolhead, sometimes from the scanner (carthographer, btw). I have a CM4 emmc and TMC5160T PRO for the A/B motors all the rest is basically the stock from the formbot kit.
Btw, the toolhead starts moving, the disconnection always happens but only after some secconds. Some times it gets to home one of the axis.
Im wondering if any one here had the same issues and possible any help on debugging.
My printer works fine without the 48v, im just messing around to learn more about all of this.
My 48v power supply is this one:
https://aliexpress.com/item/1005005474634071.html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

bigtreetech, 2025-04-21:
There are a few options for what could be causing this but they all lead back to EMI interference.

1. Your new PSU is electrically noisy and generating noise that is interfering with the communication signal to your toolboard. Check for parts of the wiring where the AB motor wires may run close to the comms wires.
2. The higher voltage being sent to the motors is creating larger electric fields around the AB wires which could also contribute towards EMI.

Are you using CAN or USB?

gilbertorconde, 2025-04-21:
I'm using usb.
Yeah I kinda suspected something like that. Do you know if add some sort of shield to these cables will work? Im using a drag chain from the gentry to the bottom of the print. Re routing the motor cables away from the USB one would be a big pain.
Many tks for your quick reply.

gilbertorconde, 2025-04-22:
its confirmed, going to close this issue. Many tks

Closed 2025-04-22.

Thread 143 (2025-07-04):

Weird hybrid board. Which config?

restinpieces, 2025-07-04:
So I purchased a Voron kit that came with a Mana M8P board. But the board is neither a V1(.1) nor a V2. For example The MCU is  STM32G0B1 indicating that it is a V1(.1) However the CAN socket is where you would expect it on the V2 version. Many other connectors also mimic the V2 board layout.

So which board do I have and which config should I use?
