bigtreetech/Manta-M8P/V2.0/Hardware/BIGTREETECH MANTA M8P V2.0-SCH.pdf

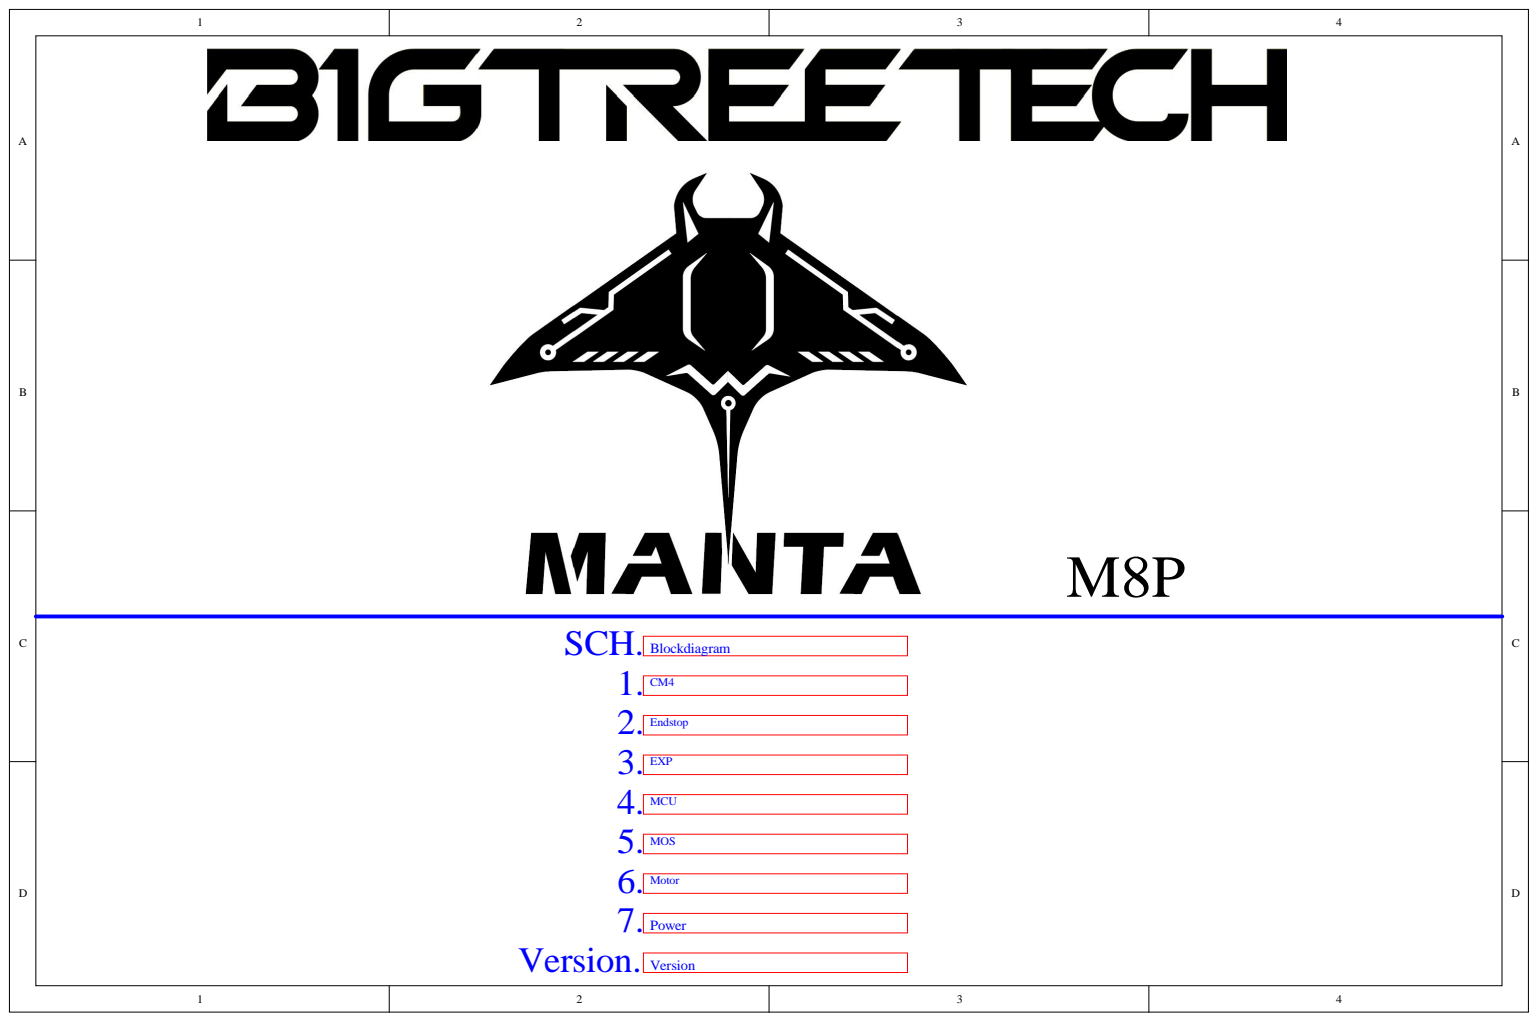
[picture p7: page 1]

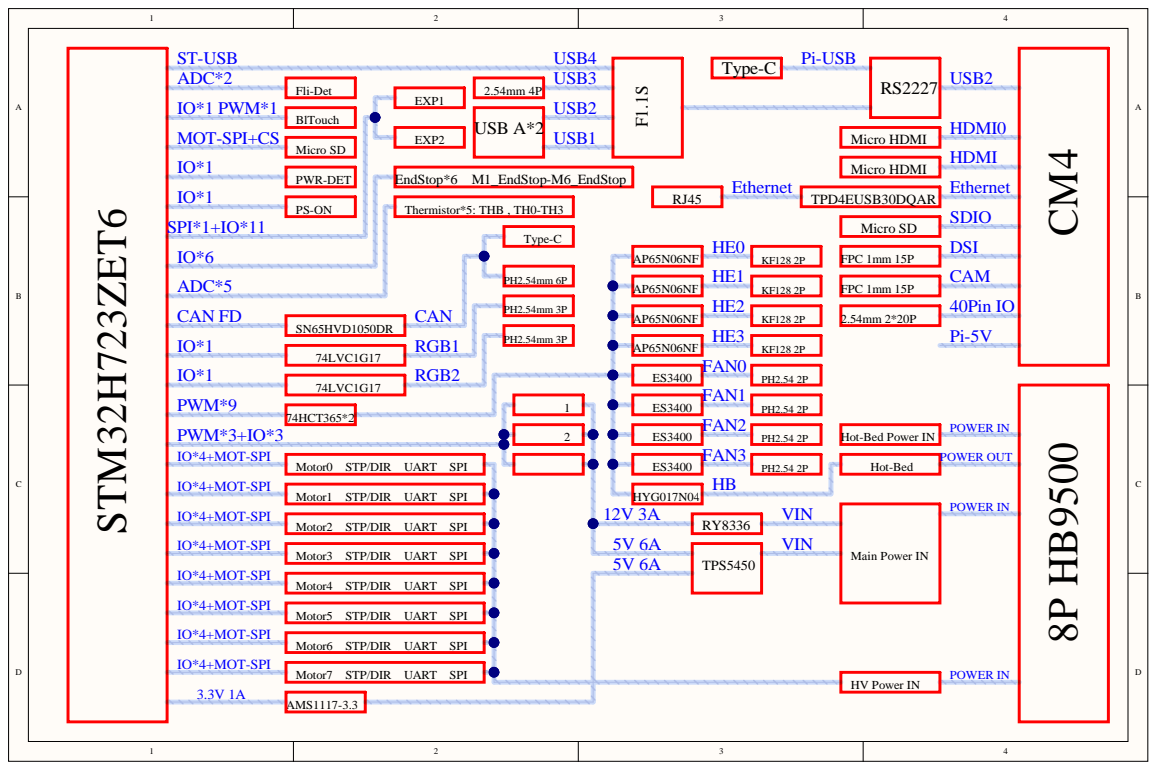
[picture p8: page 2]

Hot-Bed Power IN

Motor0 STP/DIR UART SPI

Motor1 STP/DIR UART SPI

Motor2 STP/DIR UART SPI

Motor3 STP/DIR UART SPI

Motor4 STP/DIR UART SPI

Motor5 STP/DIR UART SPI

Motor6 STP/DIR UART SPI

Motor7 STP/DIR UART SPI

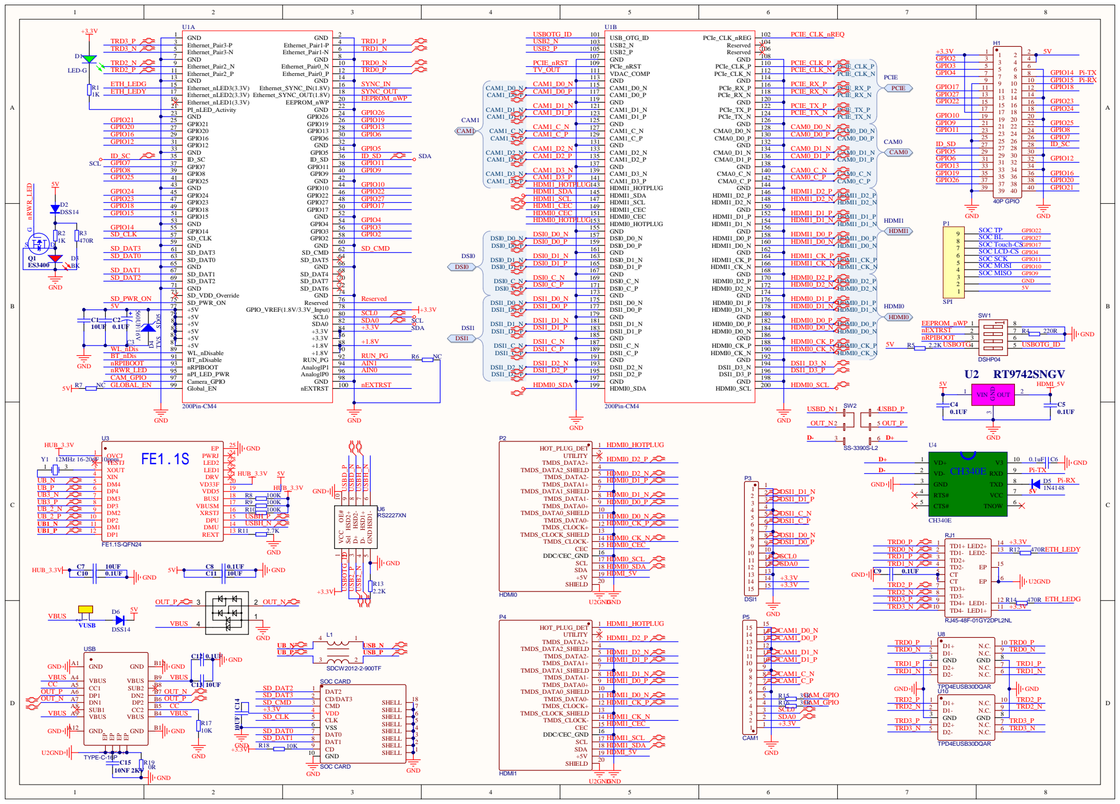
[picture p9: page 3]

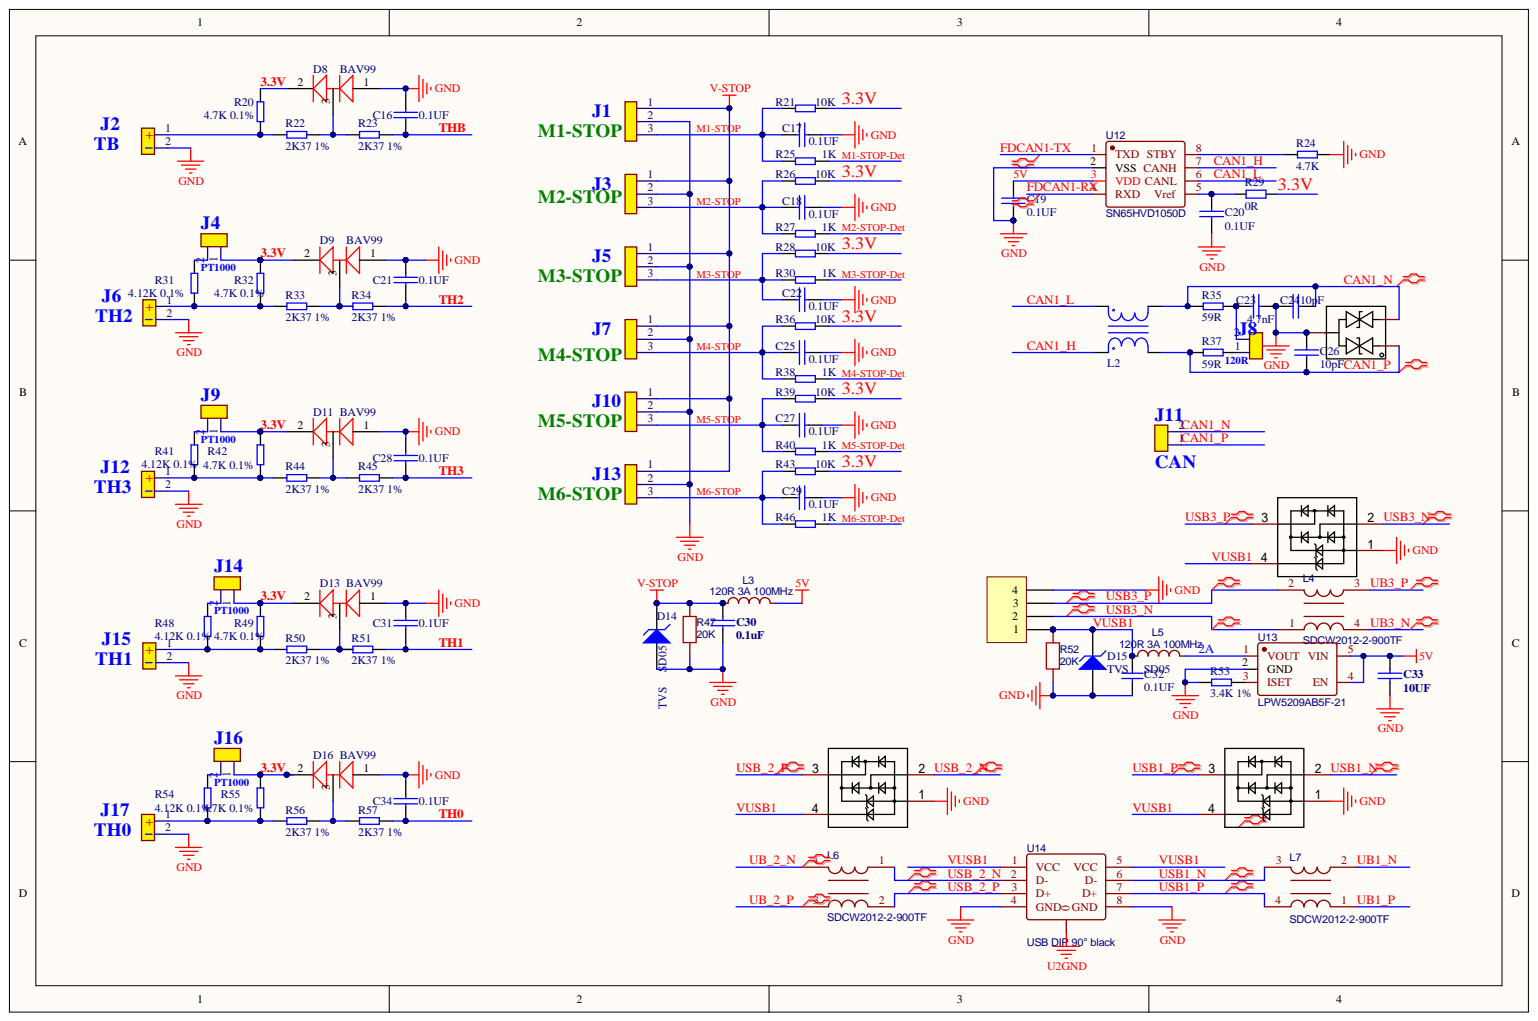
[picture p10: page 4]

2 | M2-STOP

2 | M3-STOP

2 | M4-STOP

2 | M5-STOP

VUSB1

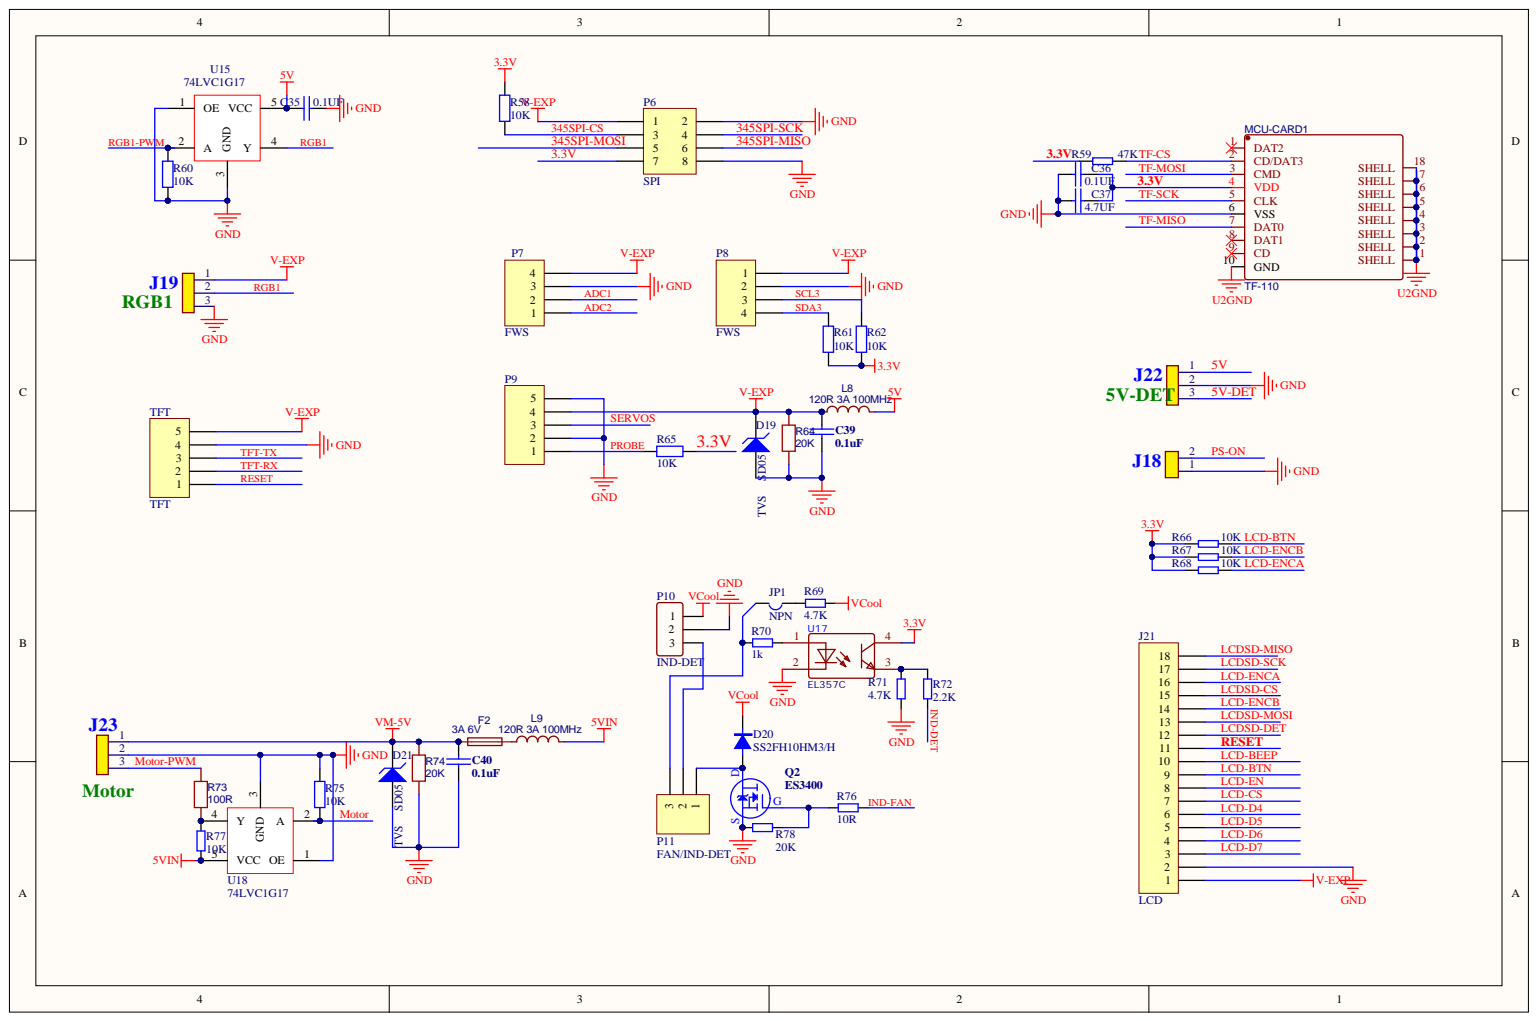
[picture p11: page 5]

3 Motor-PWM

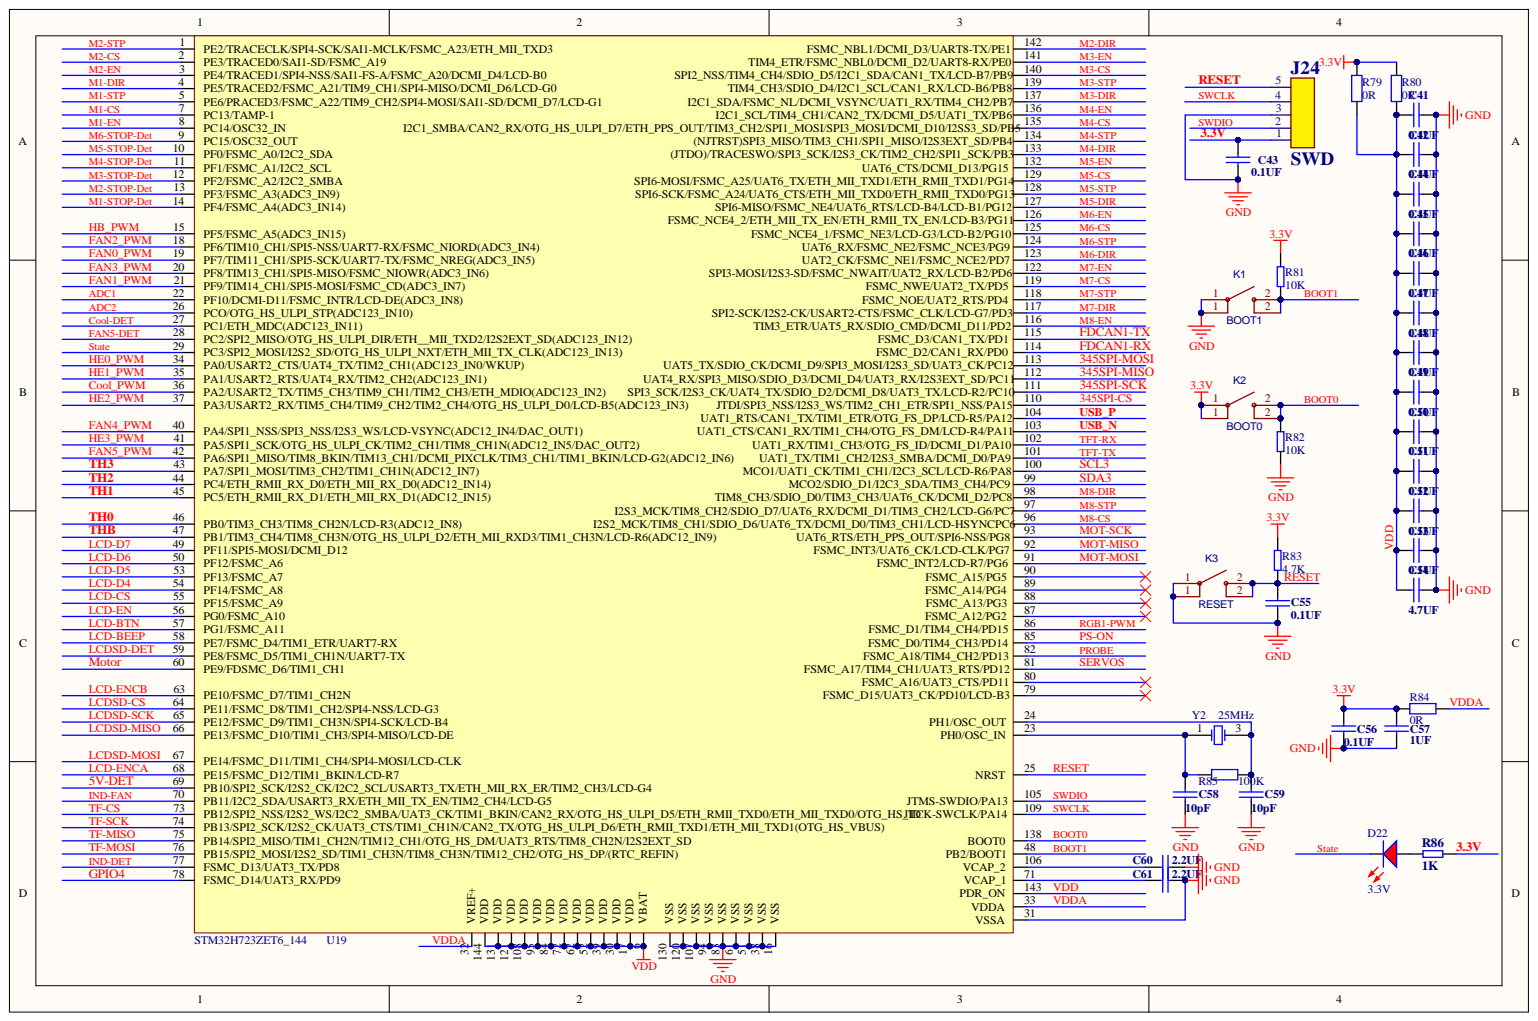
[picture p12: page 6]

M7-STP
MOT-MOSI MOT-SCK MOT-MISO FDCAN1-T

7 1 C 6 1 | 2.2 U
143 VDD VDDA

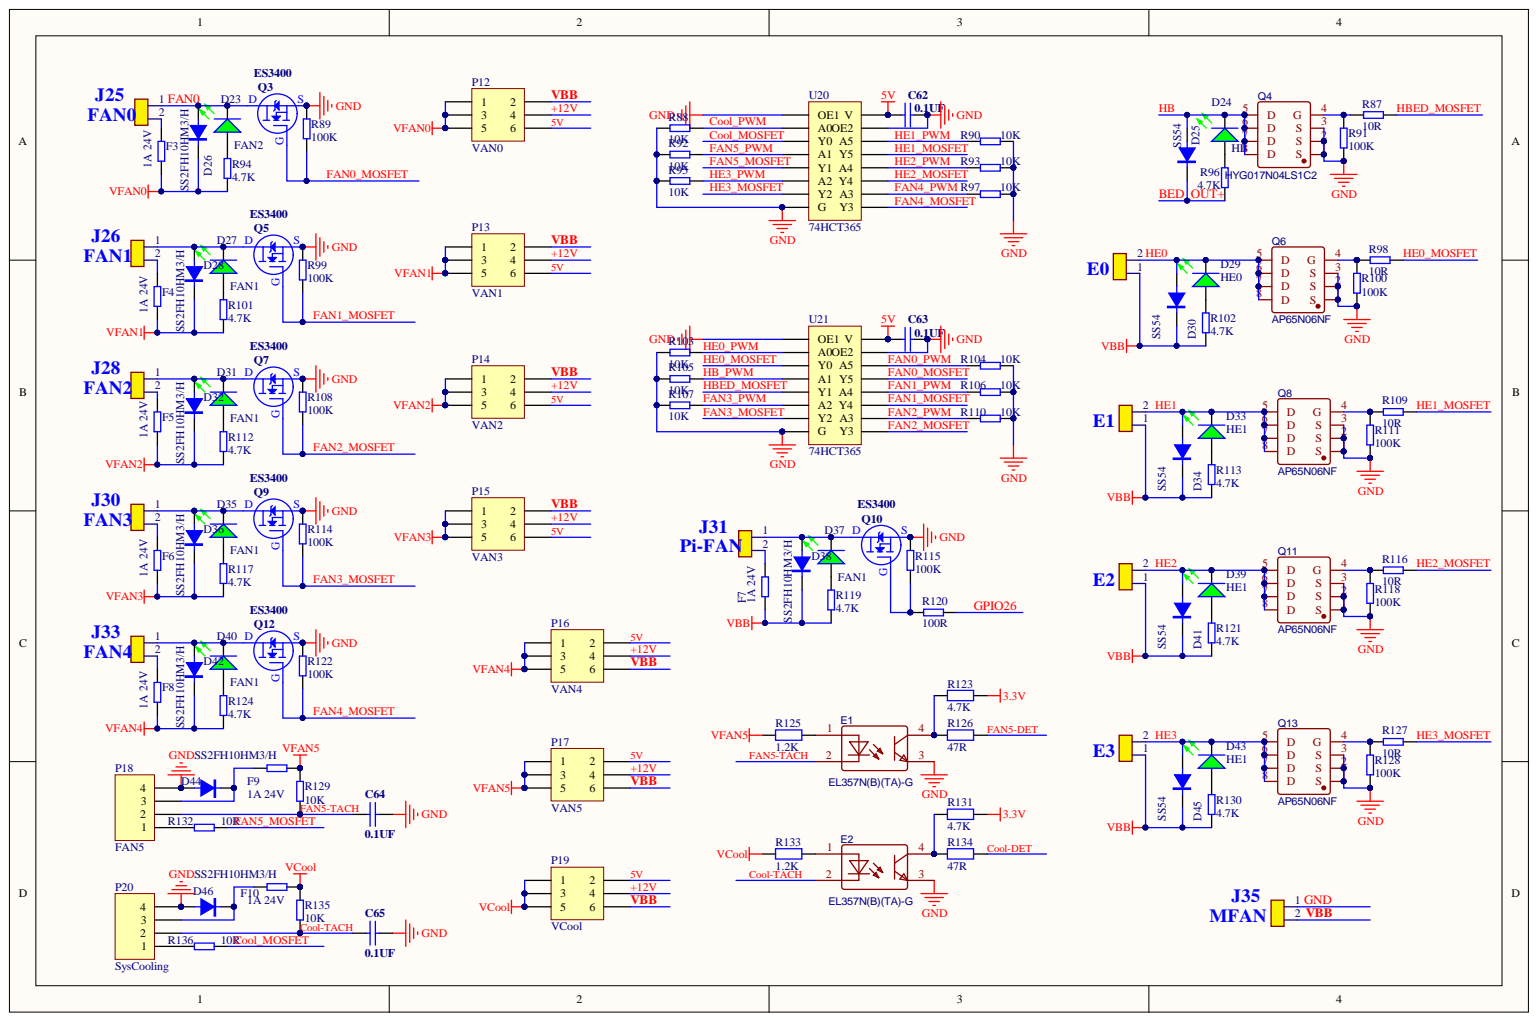
[picture p13: page 7]

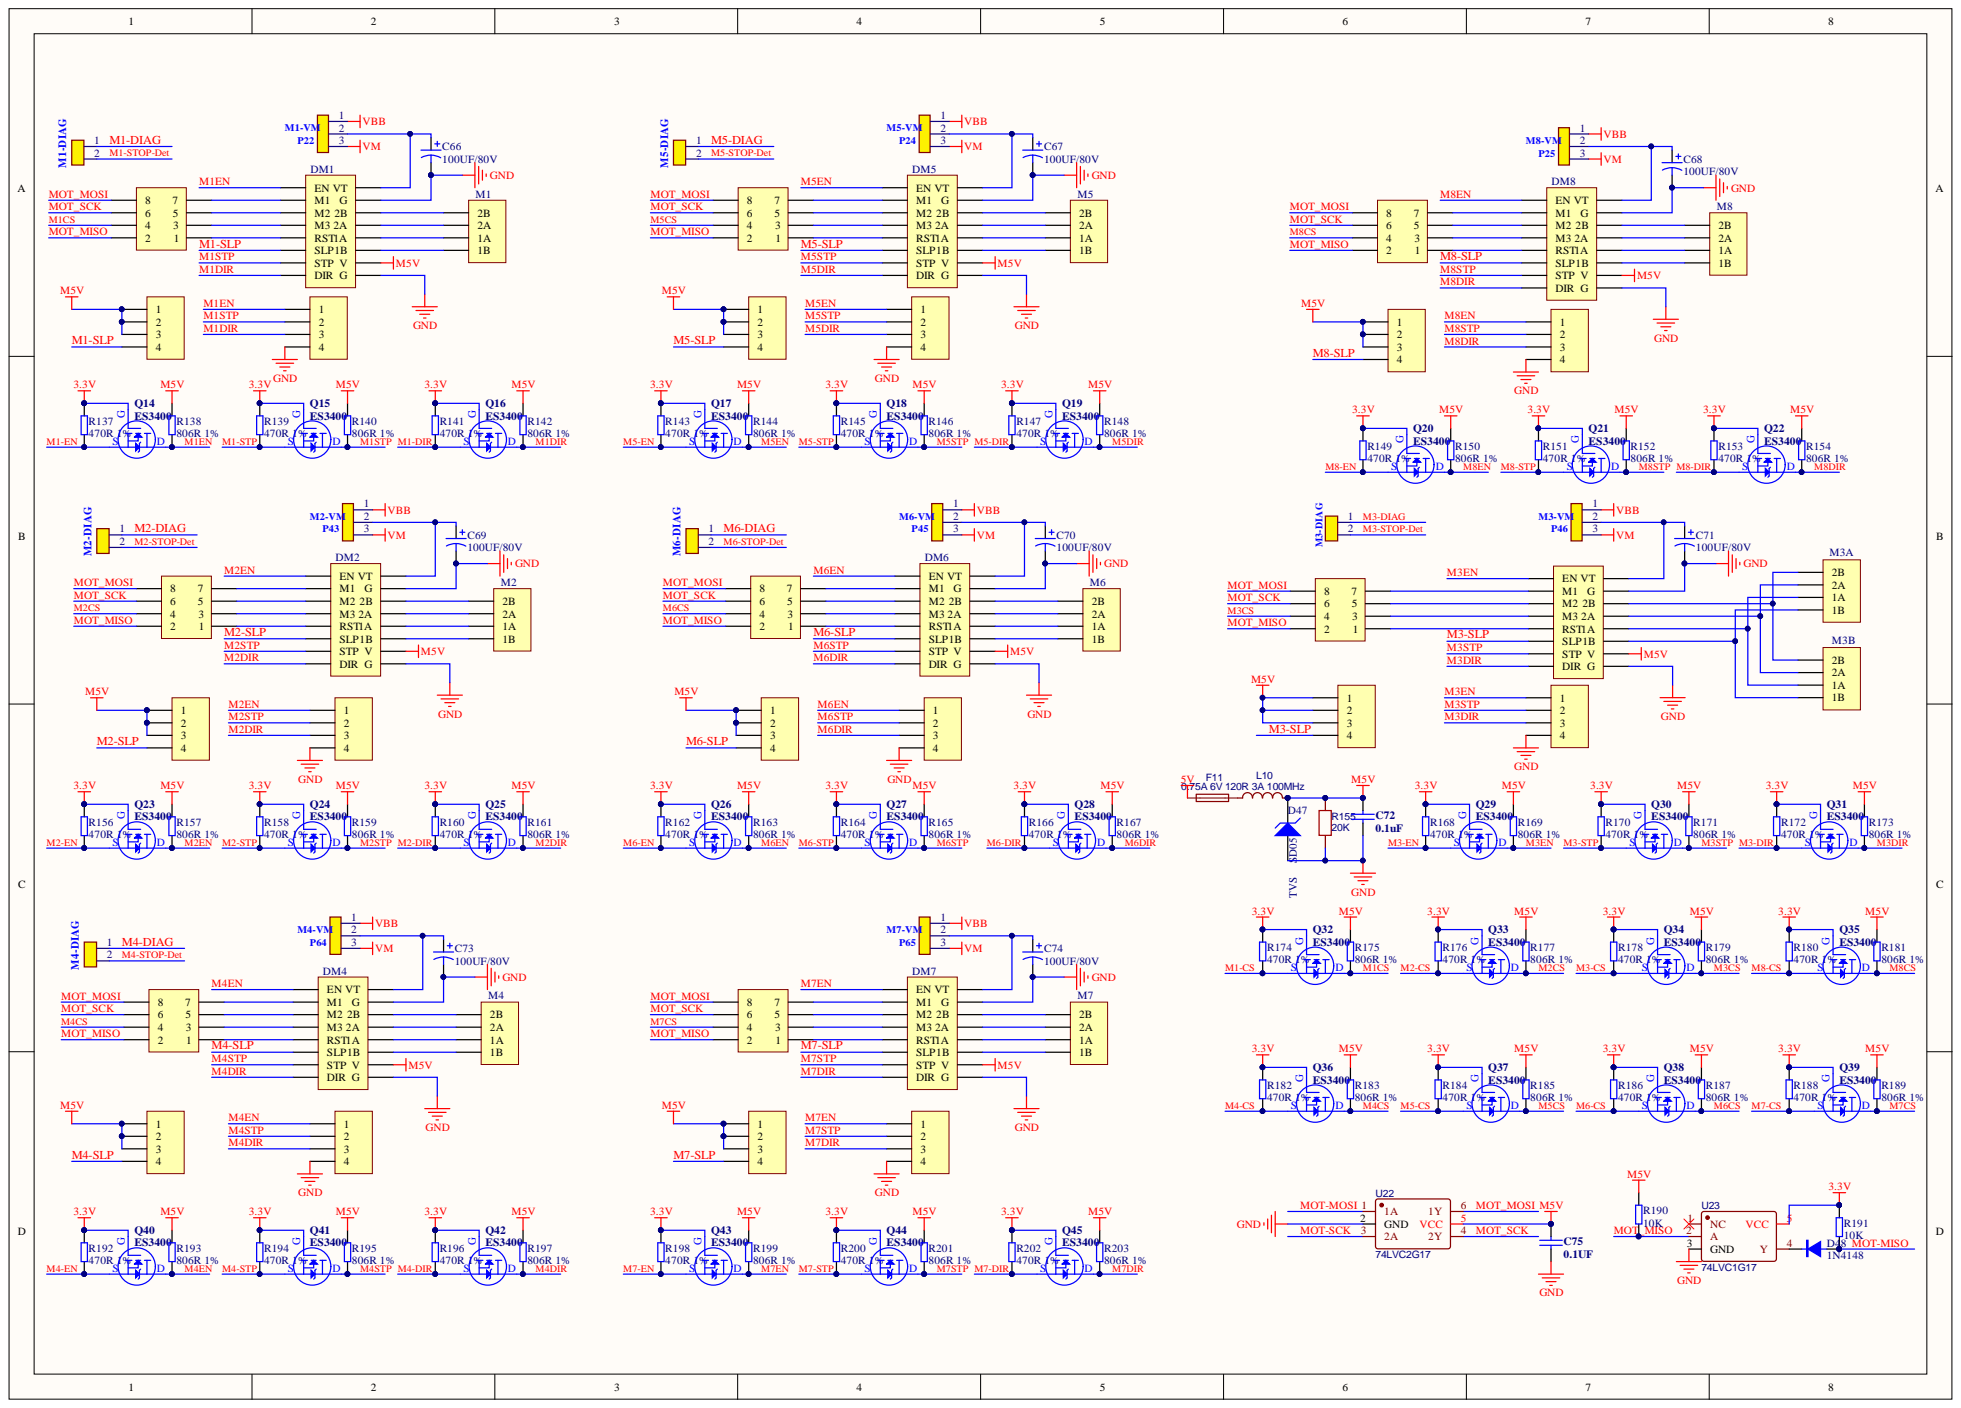
[picture p14: page 8]

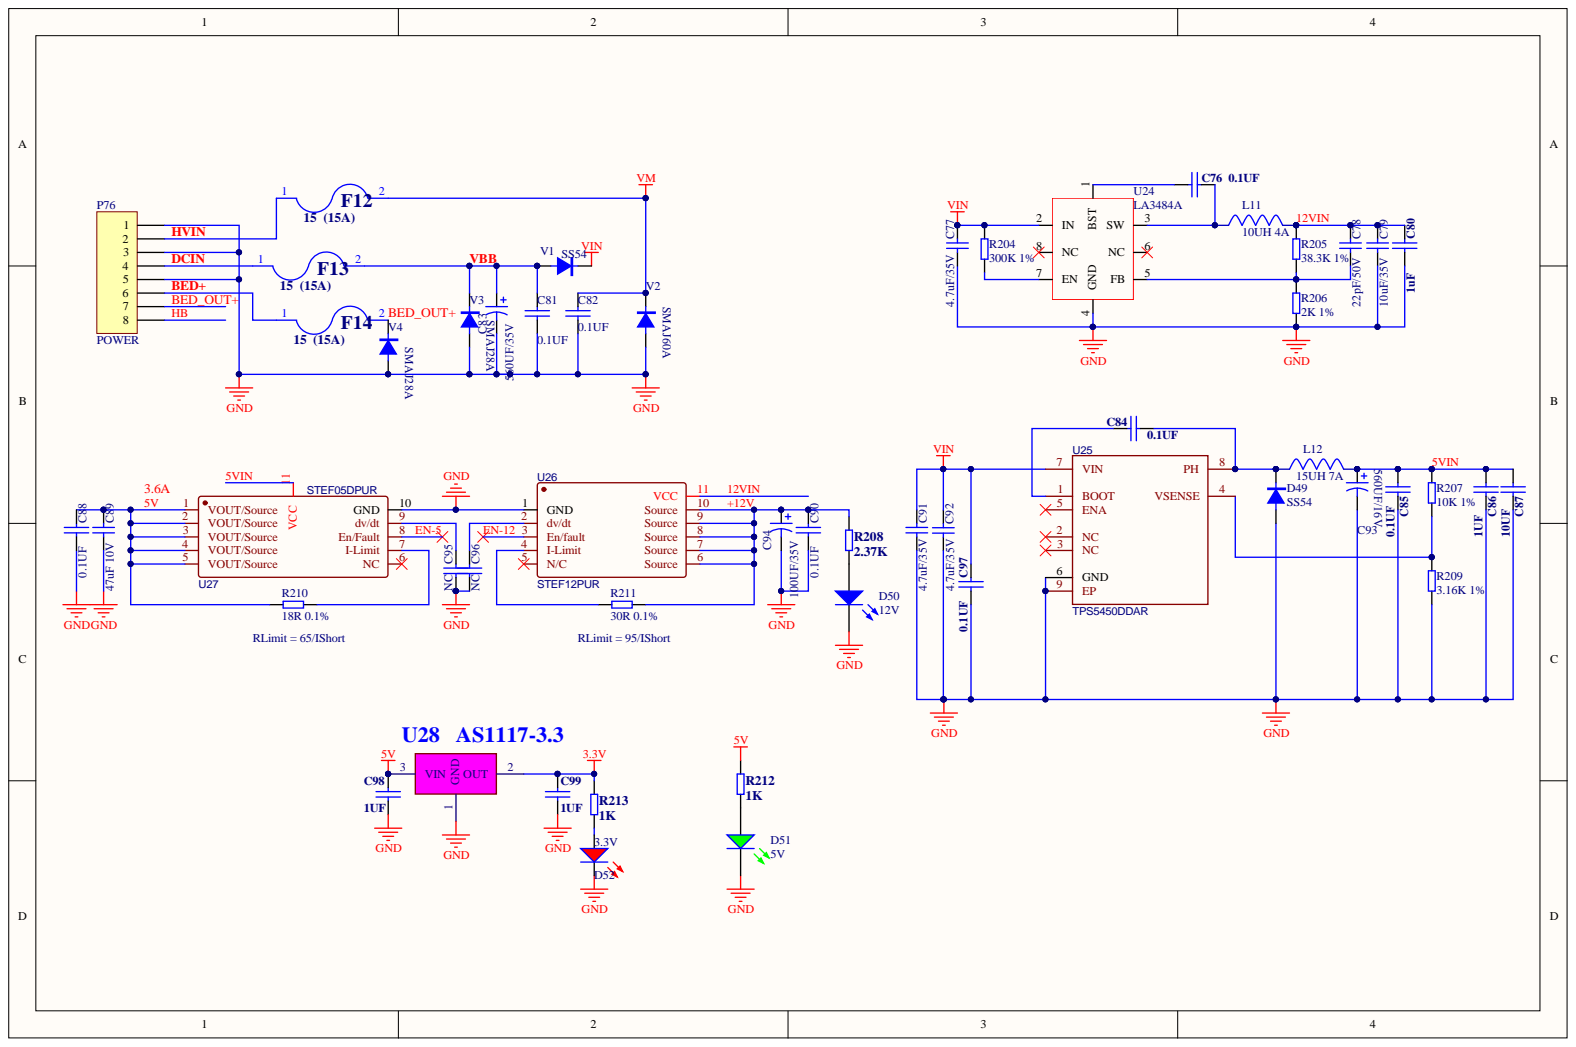
[picture p15: page 9]

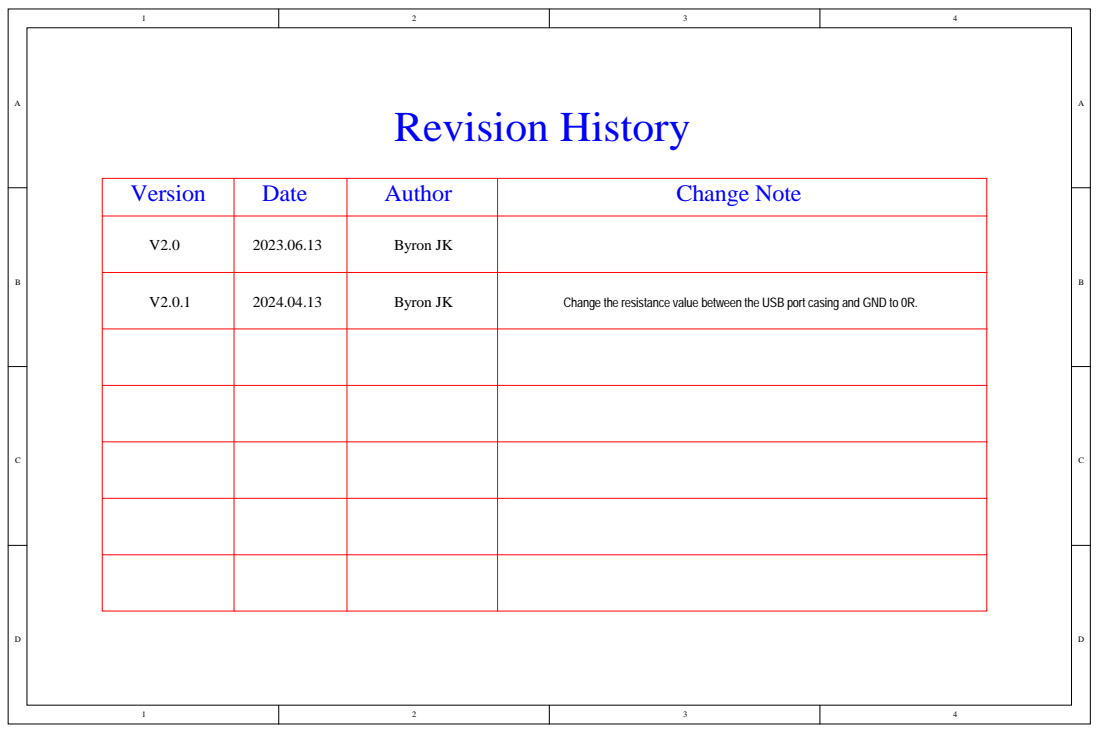
[picture p16: page 10]

Version | Date | Author | Change Note

V2.0 | 2023.06.13 | Byron JK

V2.0.1 | 2024.04.13 | Byron JK | Change the resistance value between the USB port casing and GND to 0R.
