bigtreetech/Manta-M8P/V1.0_V1.1/Hardware/BIGTREETECH MANTA M8P V1.1-SCH.pdf

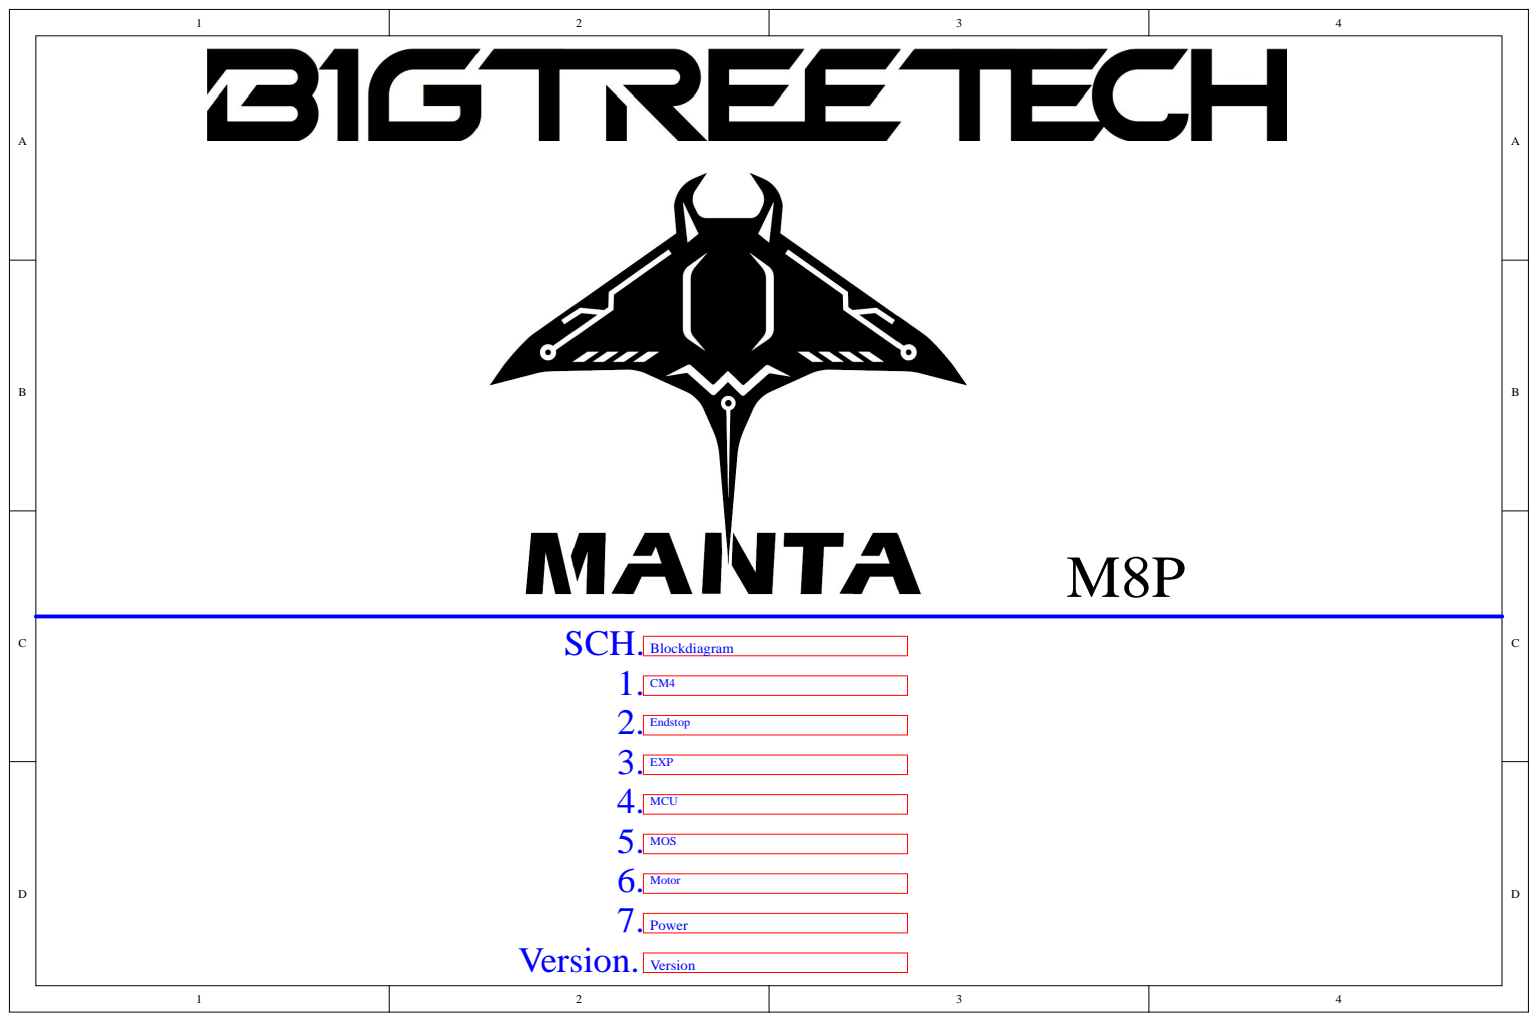
[picture p17: page 1]

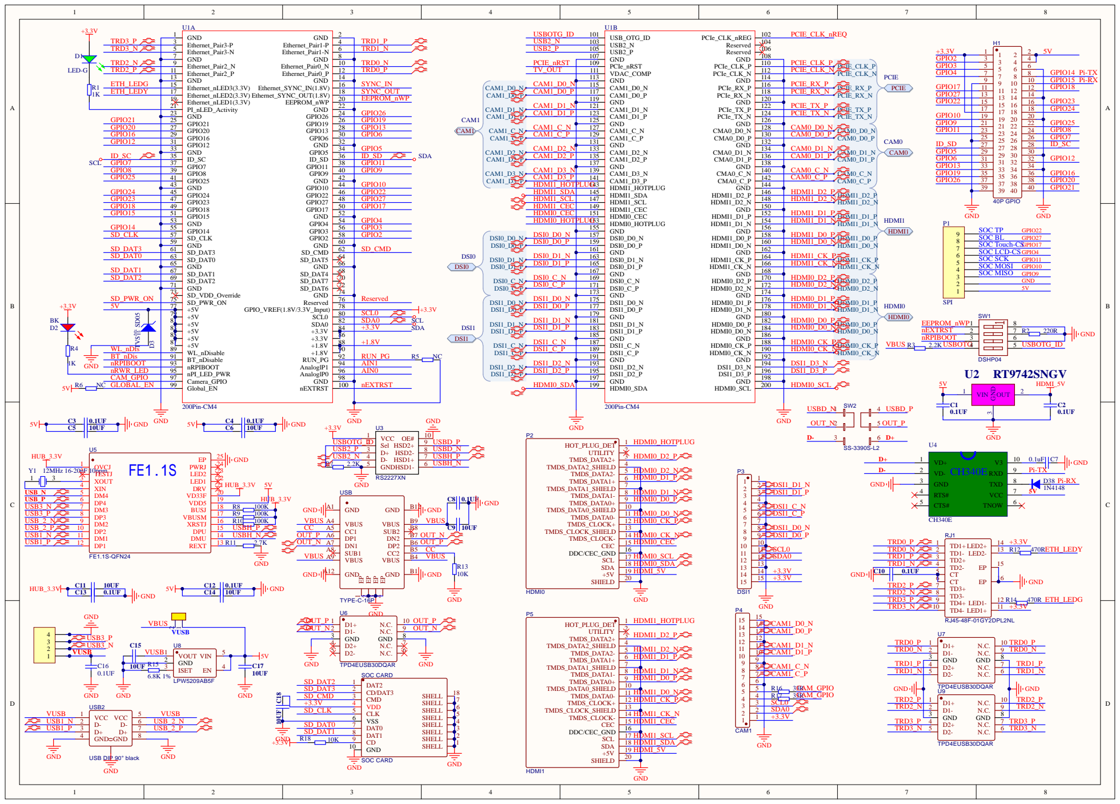
[picture p18: page 2]

SOC TP
SOC BL
SOC Touch-CS SOC LCD-CS

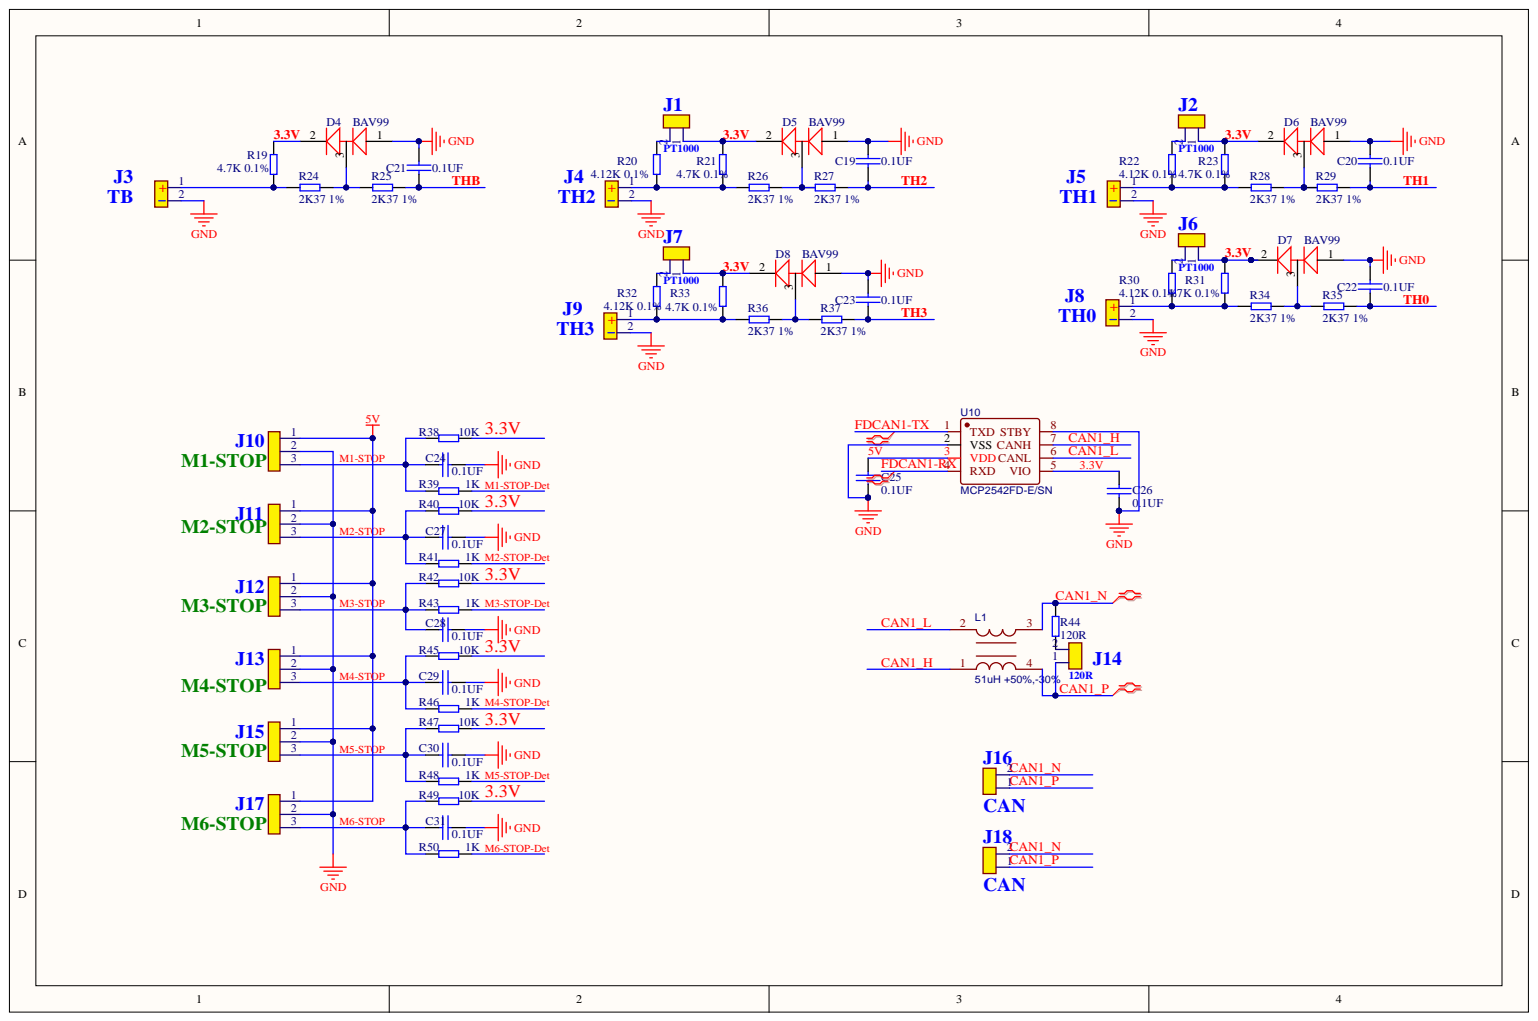
[picture p19: page 3]

2 | M2-STOP

2 | M3-STOP

2 | M4-STOP

2 | M5-STOP

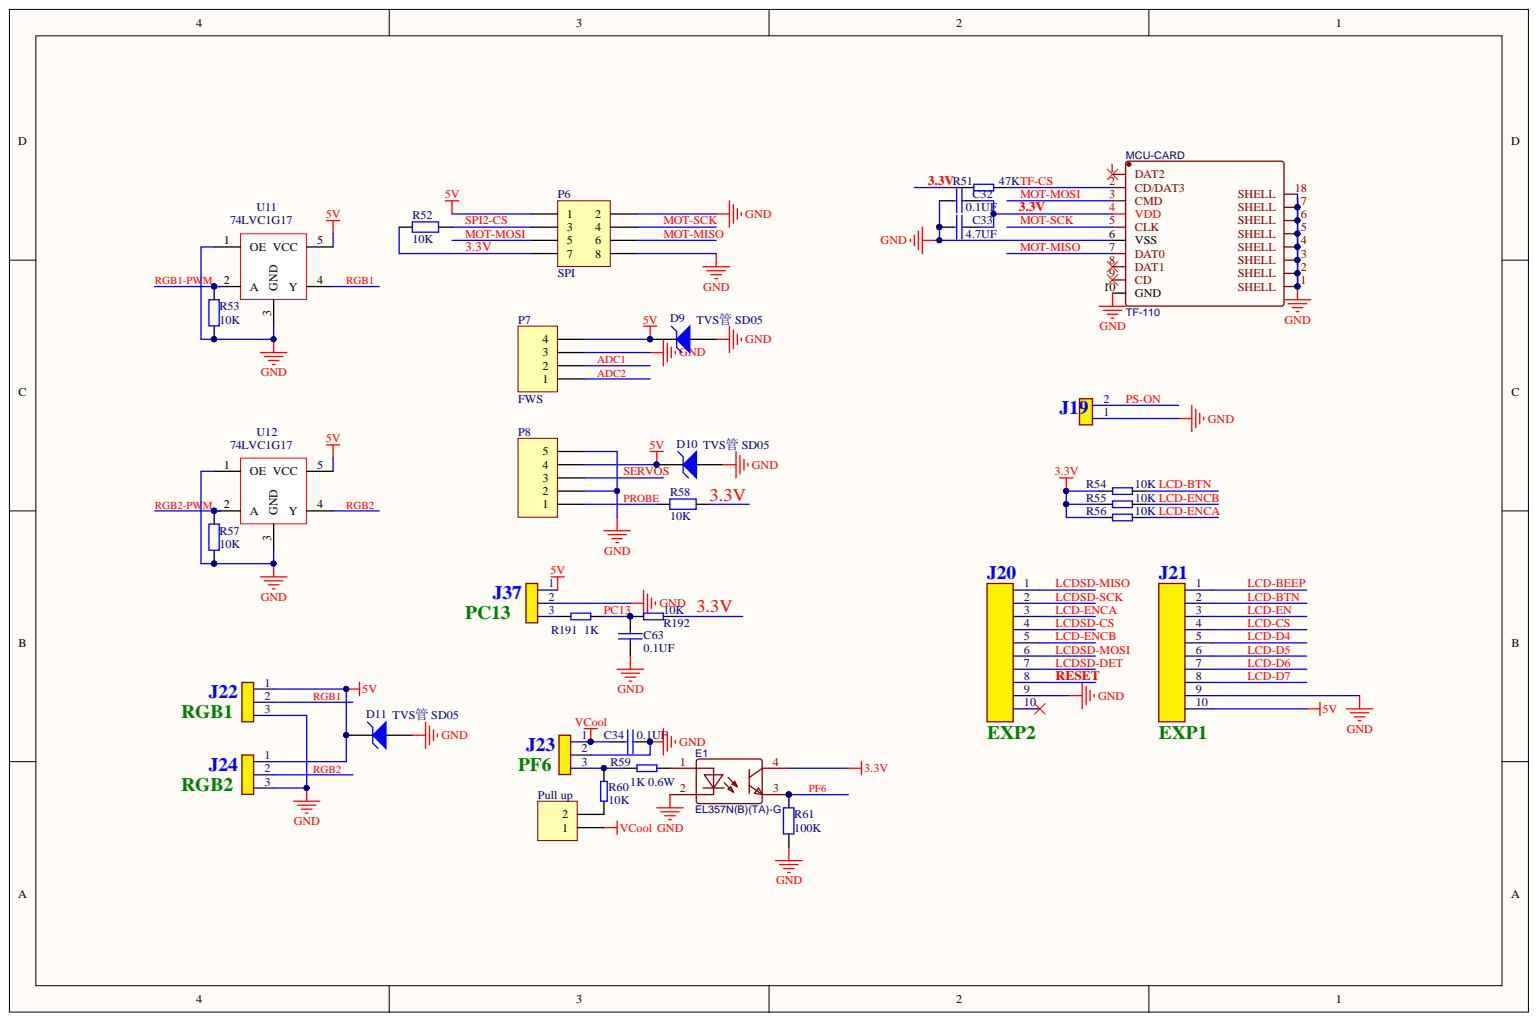
[picture p20: page 4]

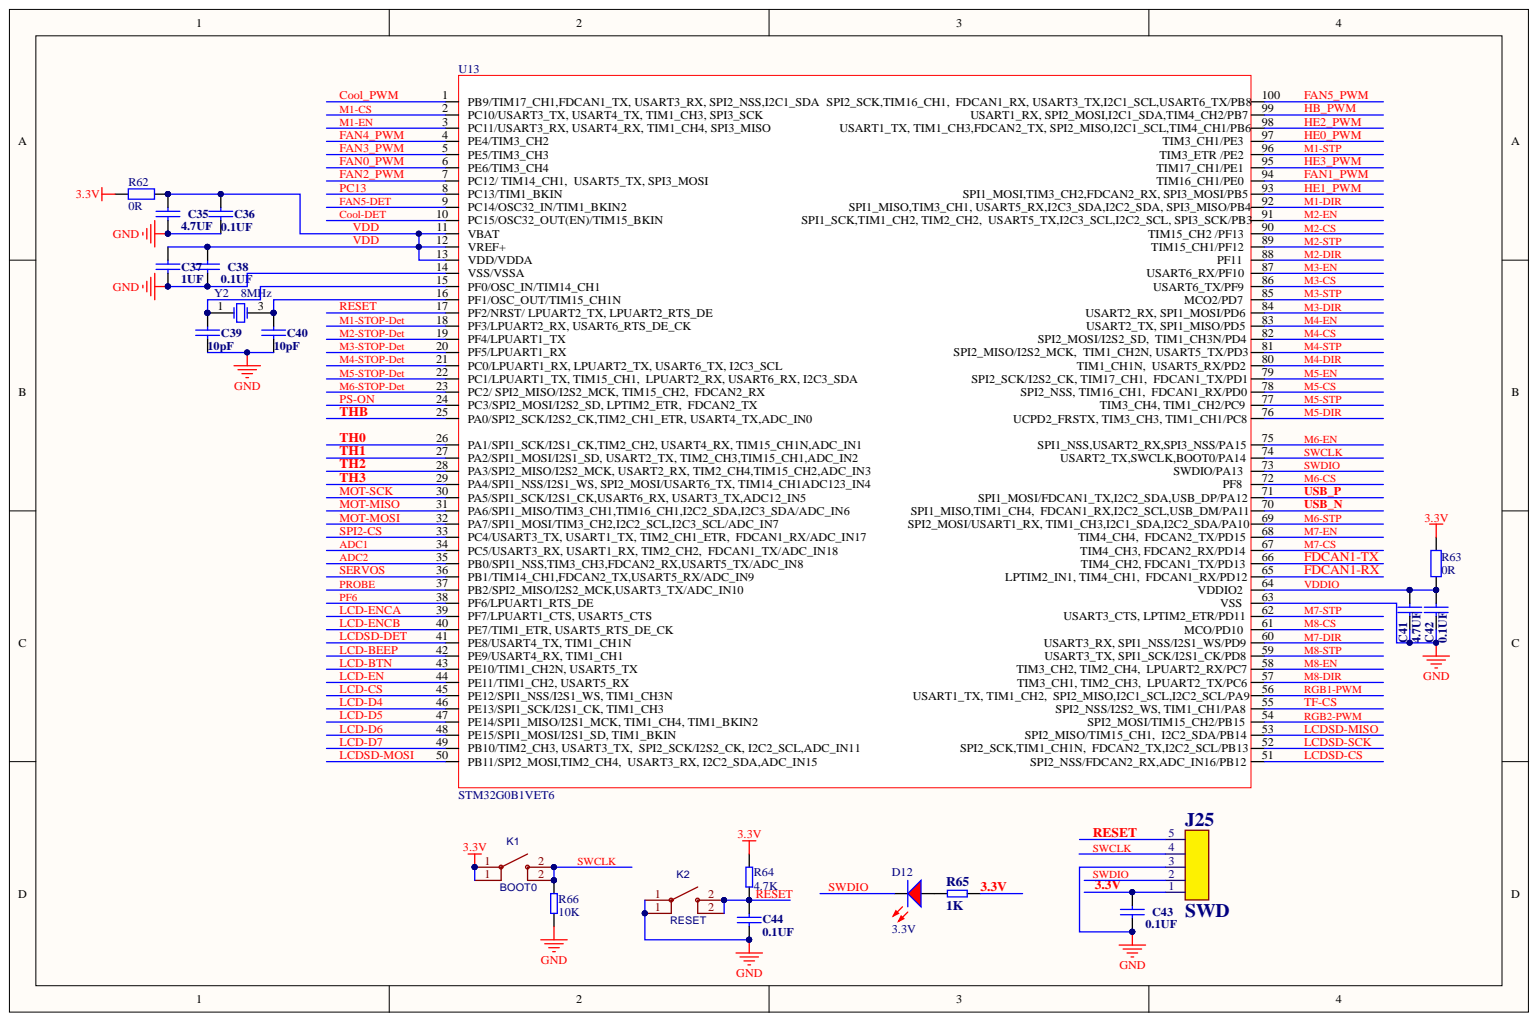
[picture p21: page 5]

1UF | 0.1UF | PF0/OSC_IN/TIM14_CH1 15
Y2 8MHz | PF1/OSC_OUT/TIM15_CH1N 16

RESET

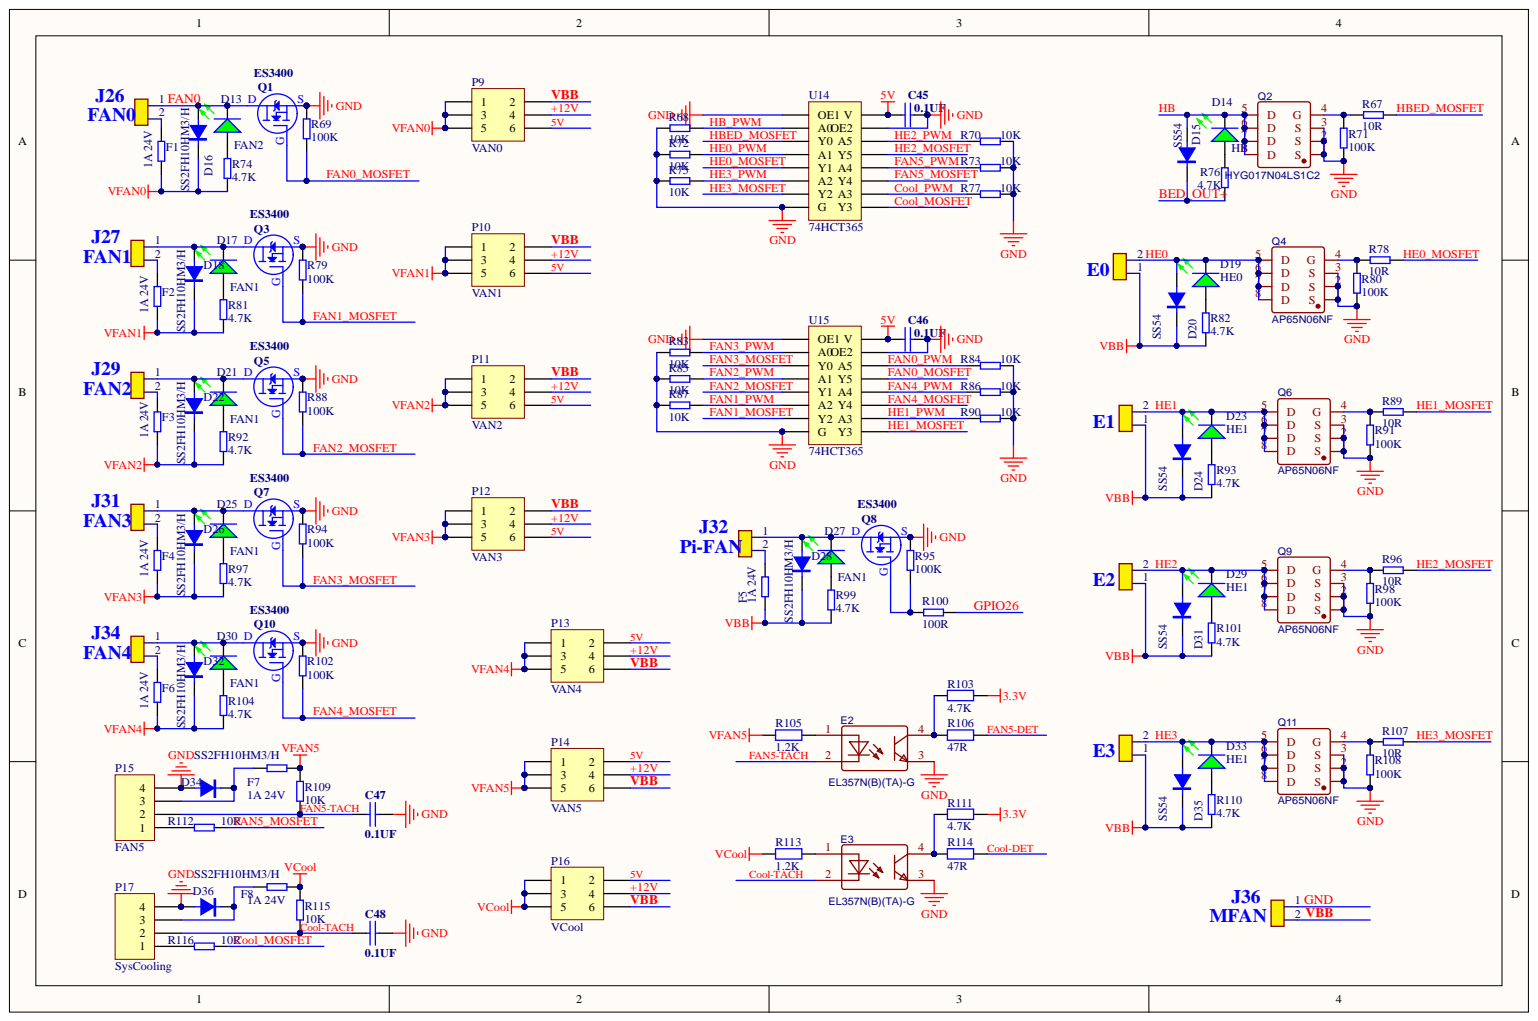
[picture p22: page 6]

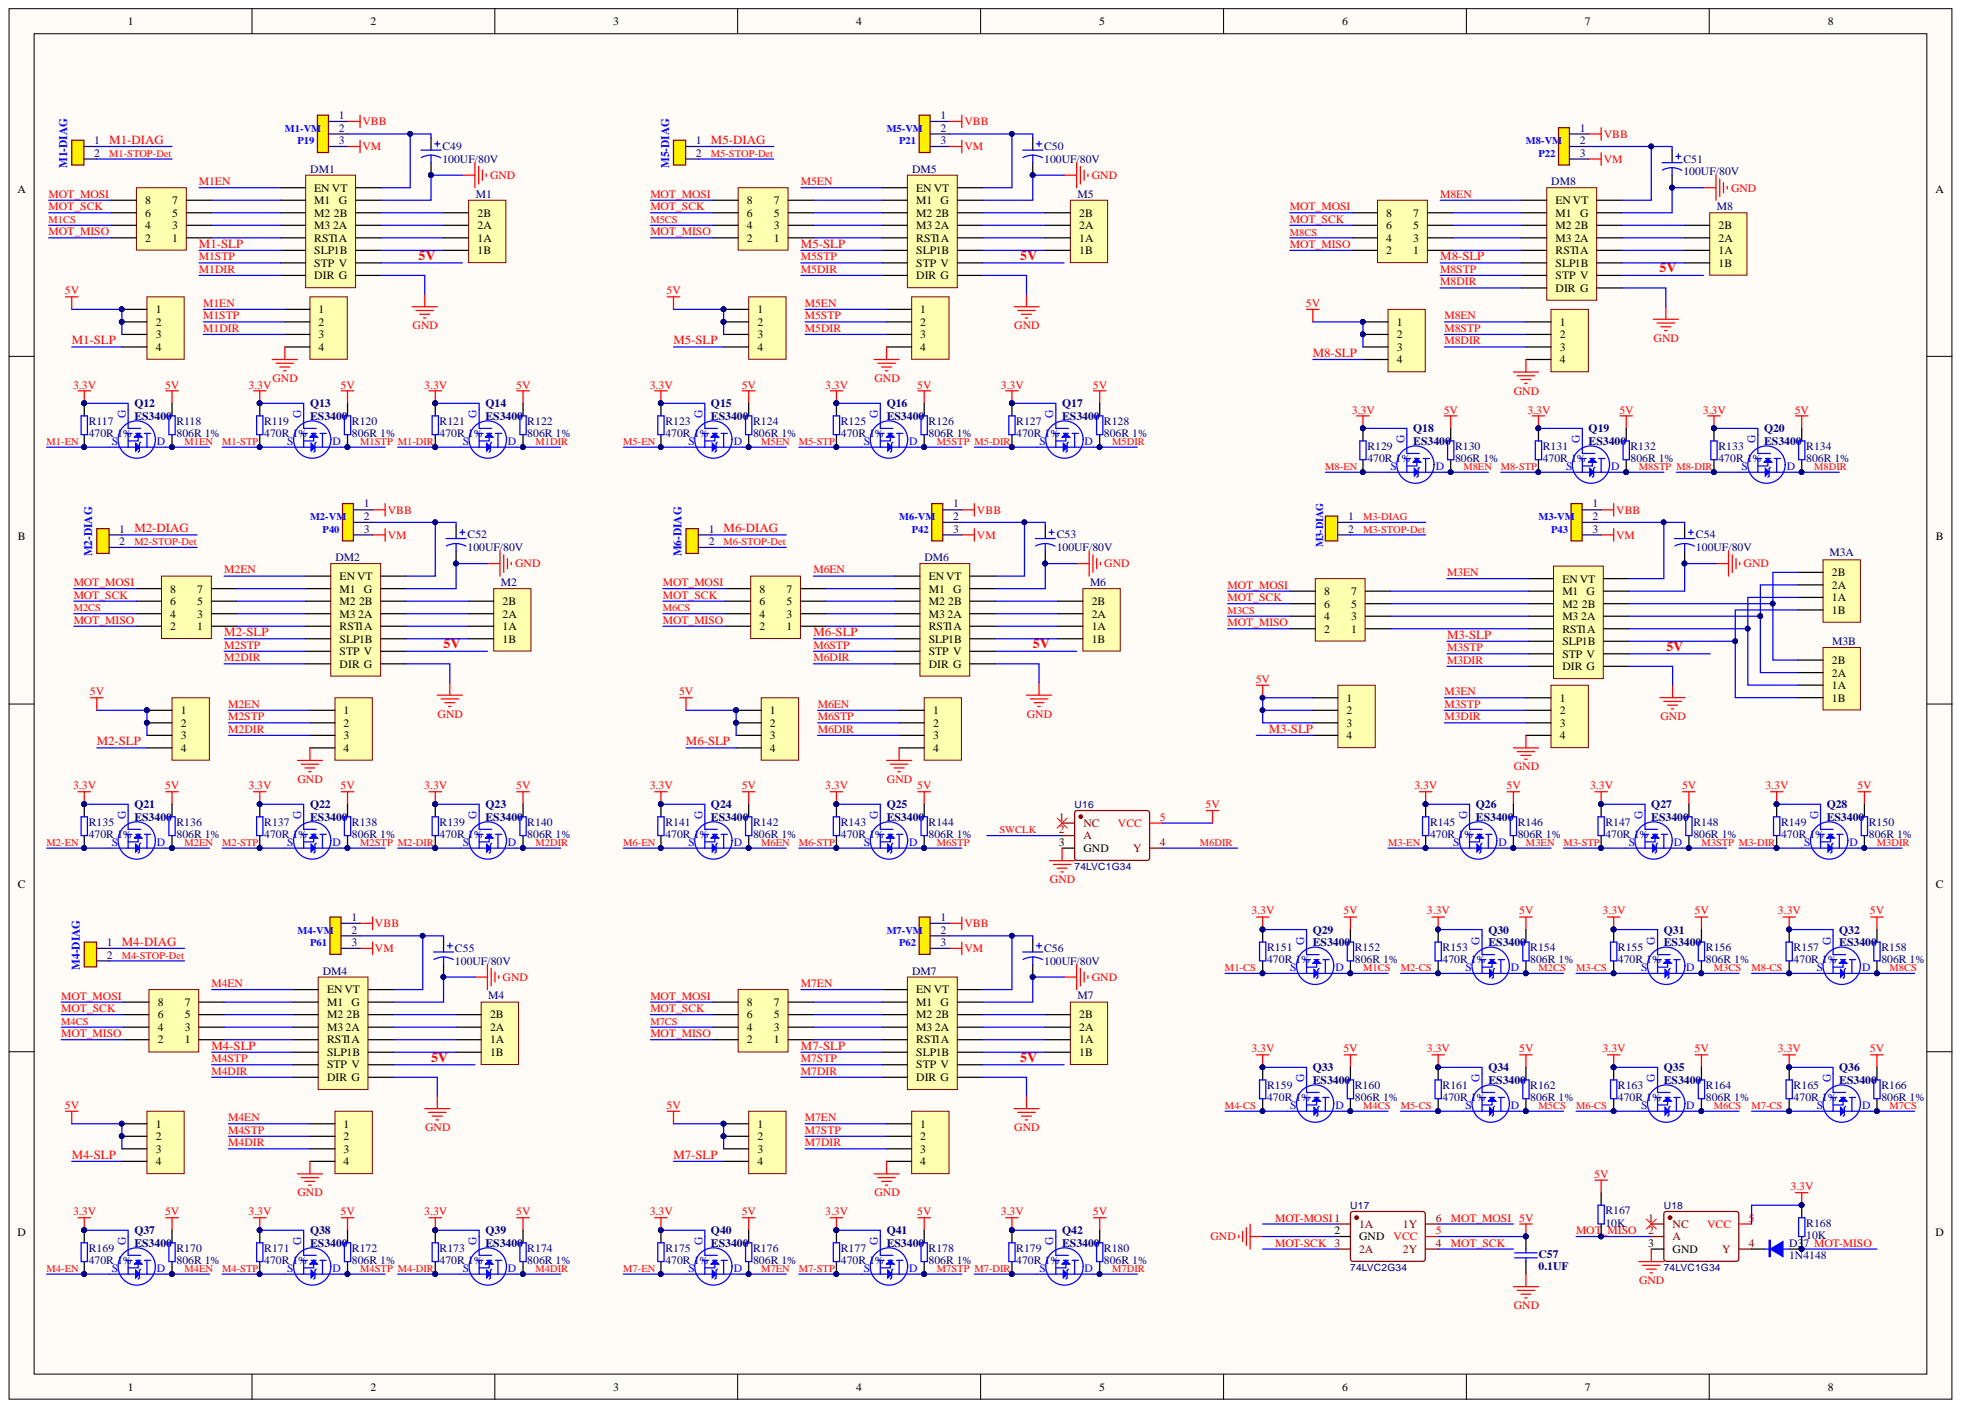
[picture p23: page 7]

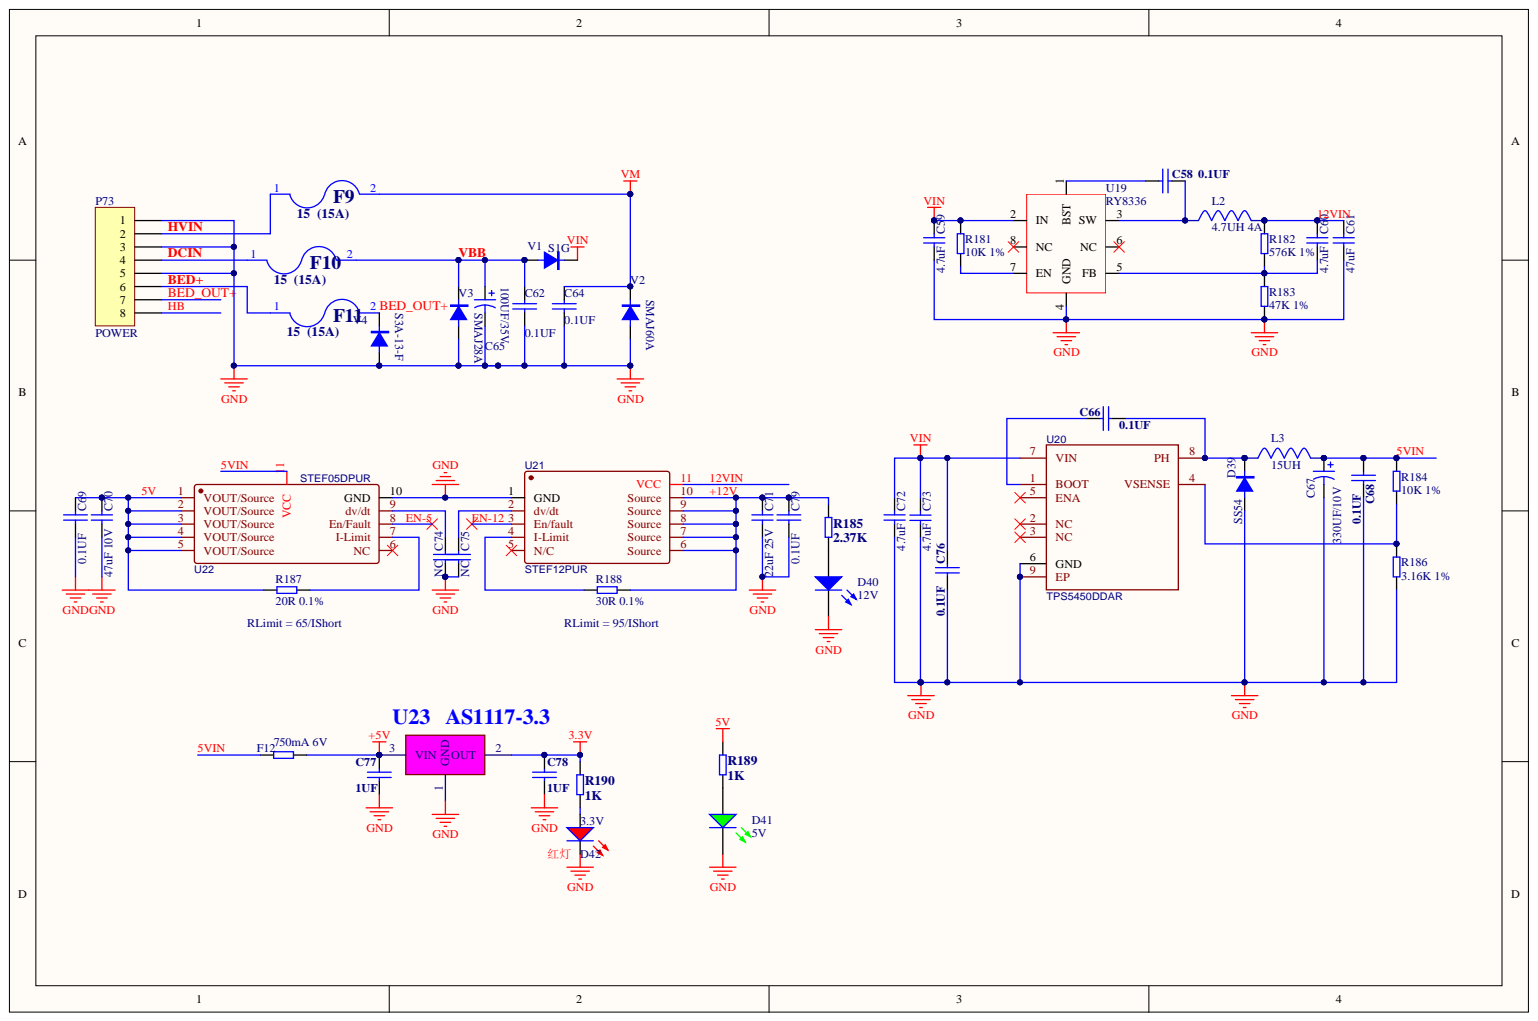
[picture p24: page 8]

DCIN

BED+
