bigtreetech/Manta-M8P/V2.0/Hardware/BIGTREETECH MANTA M8P V2.0-SIZE.pdf

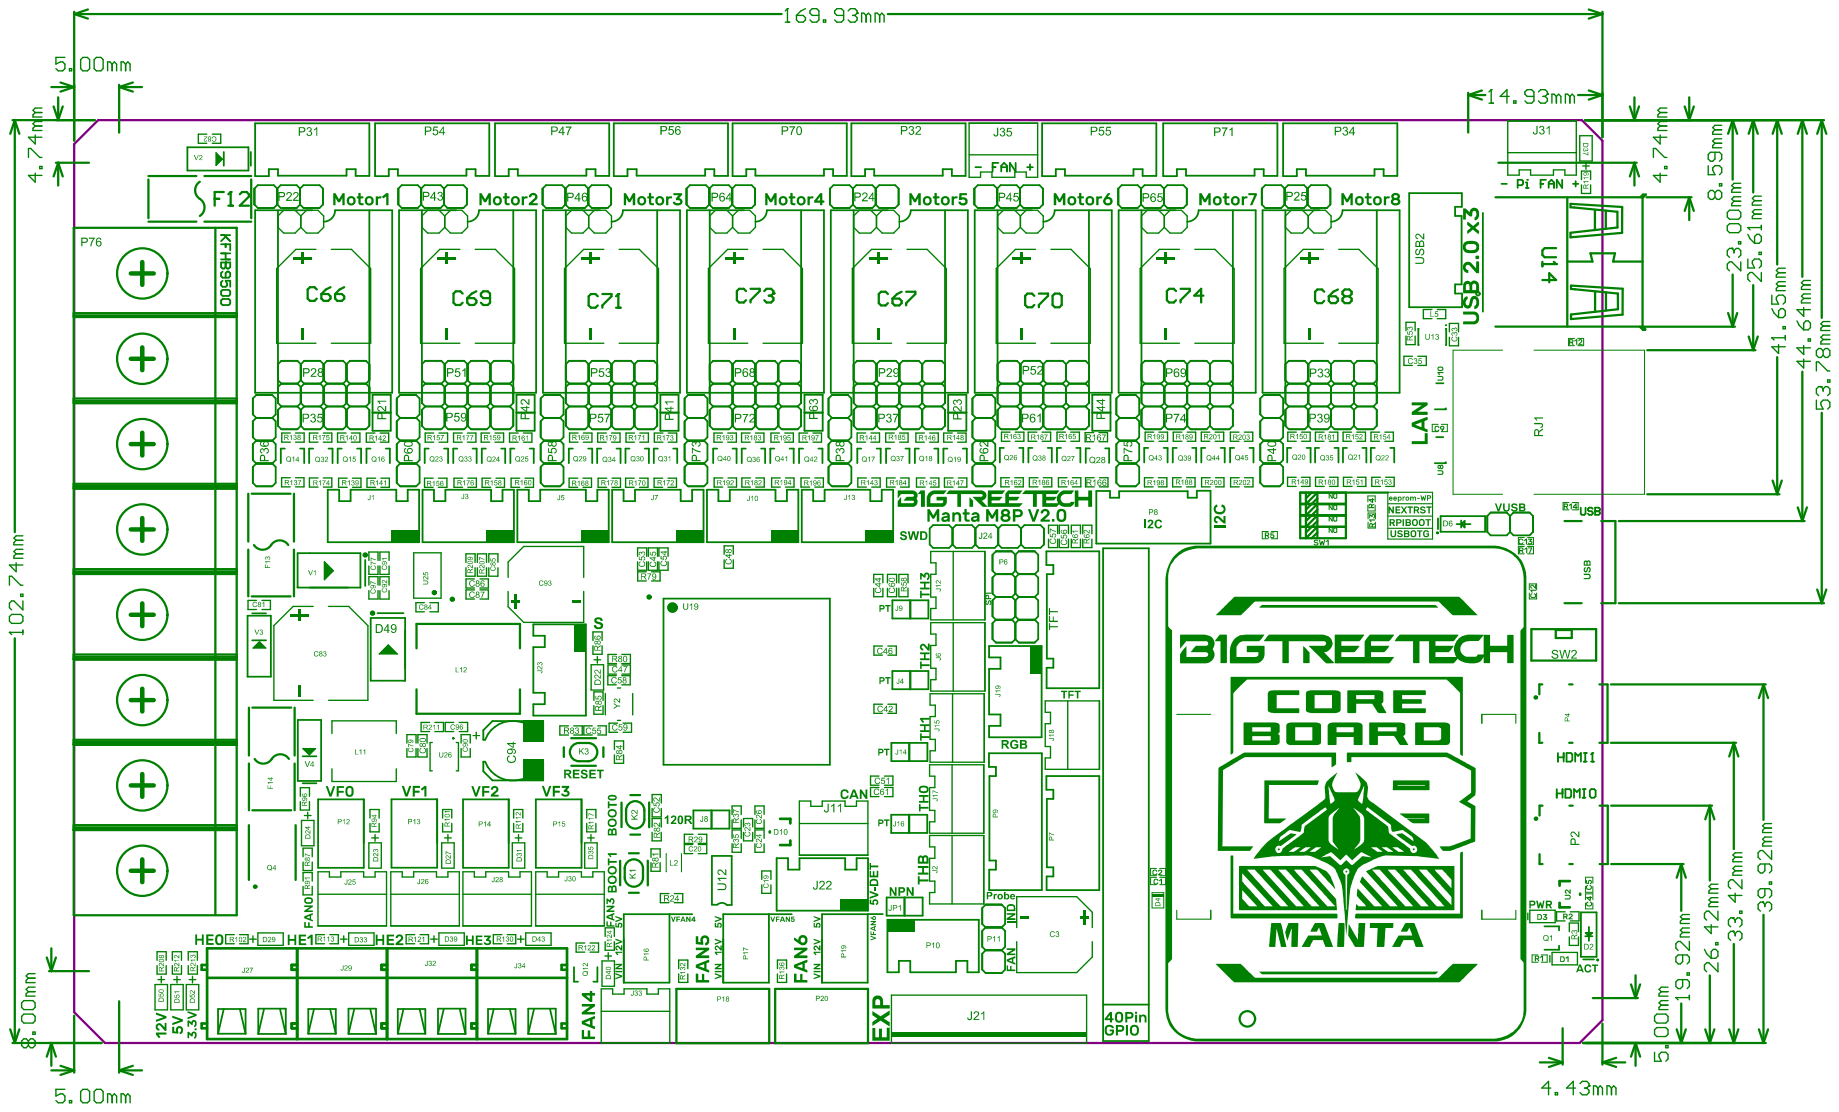
[picture p25: page 1]
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
