bigtreetech/Manta-M8P/V1.0_V1.1/Hardware/BIGTREETECH MANTA M8P V1.0-SIZE-bot.pdf

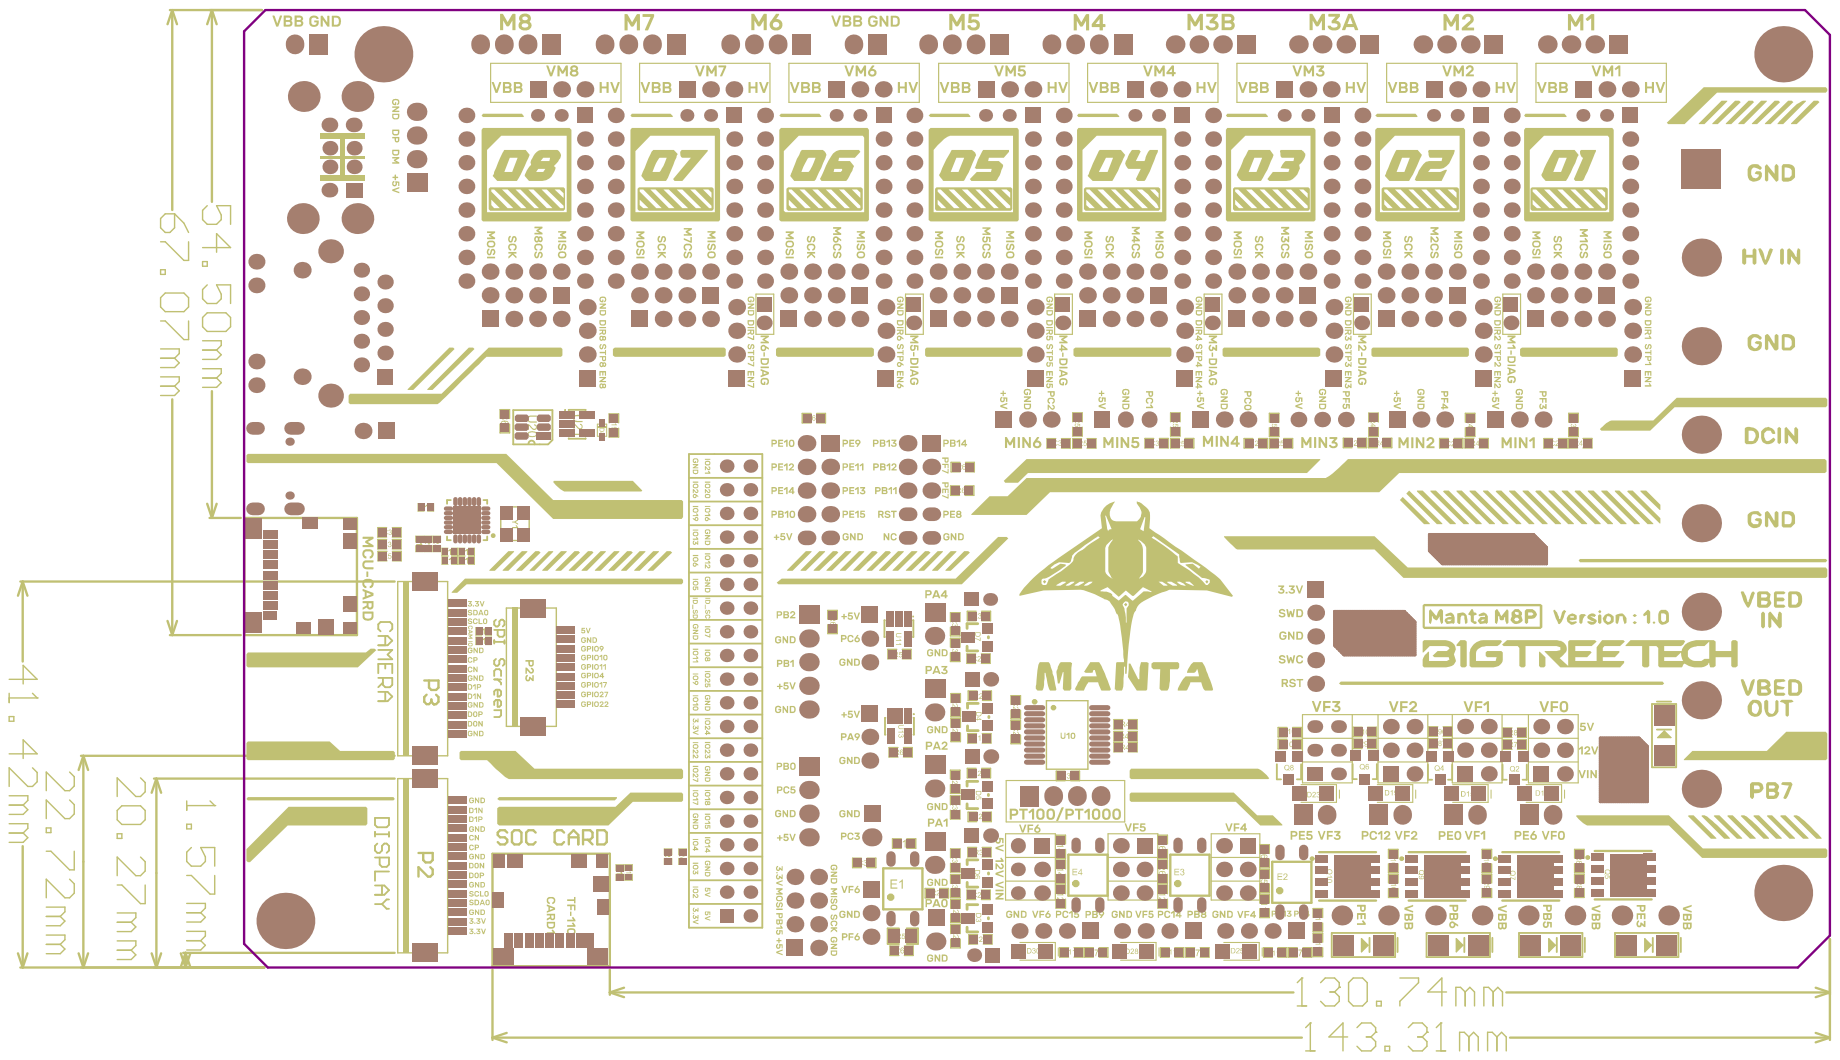
[picture p26: page 1]
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
