bigtreetech/Manta-M8P/V1.0_V1.1/Hardware/BIGTREETECH MANTA M8P V1.0-SCH.pdf

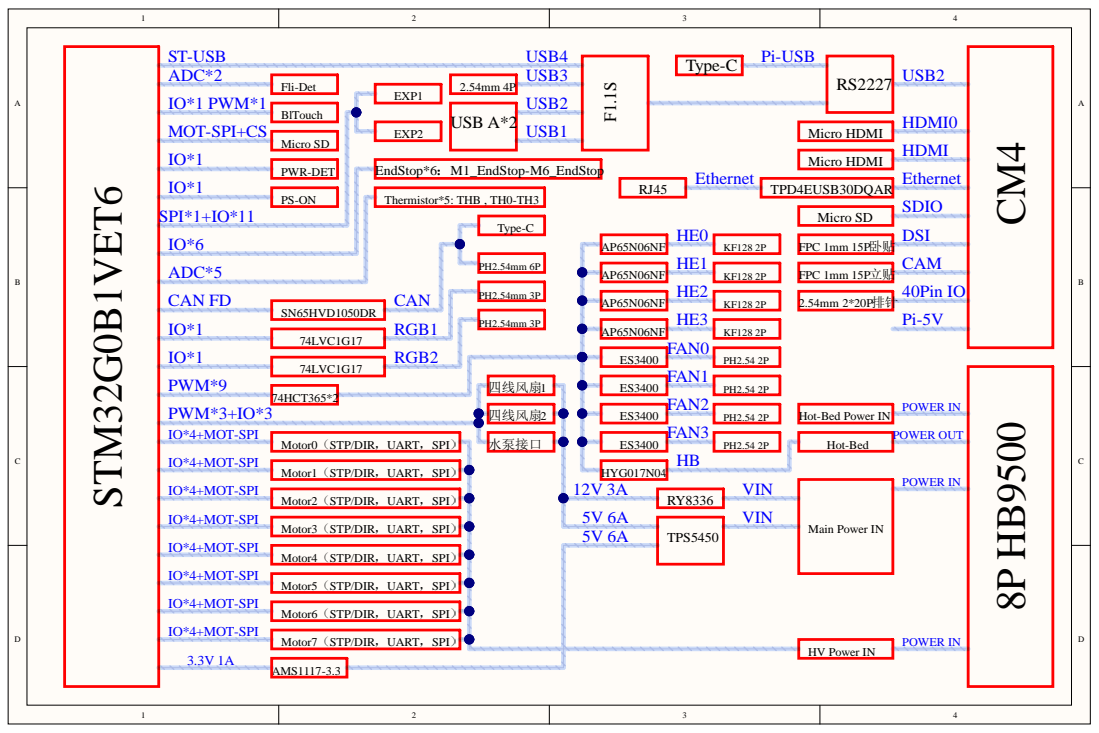
[picture p28: page 2]

Hot-Bed Power IN

Motor0（STP/DIR，UART，SPI） IO*4+MOT-SPI

Motor1（STP/DIR，UART，SPI） IO*4+MOT-SPI

Motor2（STP/DIR，UART，SPI） IO*4+MOT-SPI

Motor3（STP/DIR，UART，SPI） IO*4+MOT-SPI

Motor4（STP/DIR，UART，SPI） IO*4+MOT-SPI

Motor5（STP/DIR，UART，SPI） IO*4+MOT-SPI

Motor6（STP/DIR，UART，SPI） IO*4+MOT-SPI

Motor7（STP/DIR，UART，SPI） IO*4+MOT-SPI

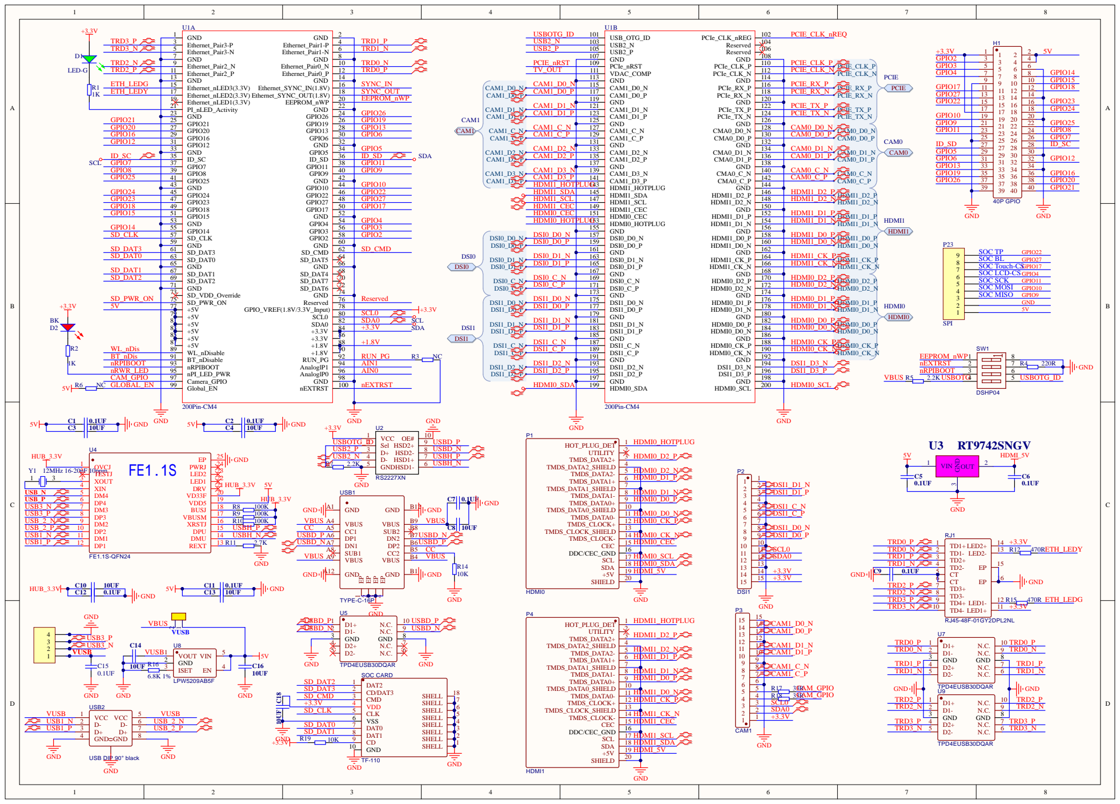
[picture p29: page 3]

SOC TP SOC BL SOC Touch-CS SOC LCD-CS SOC SCK SOC MOSI SOC MISO

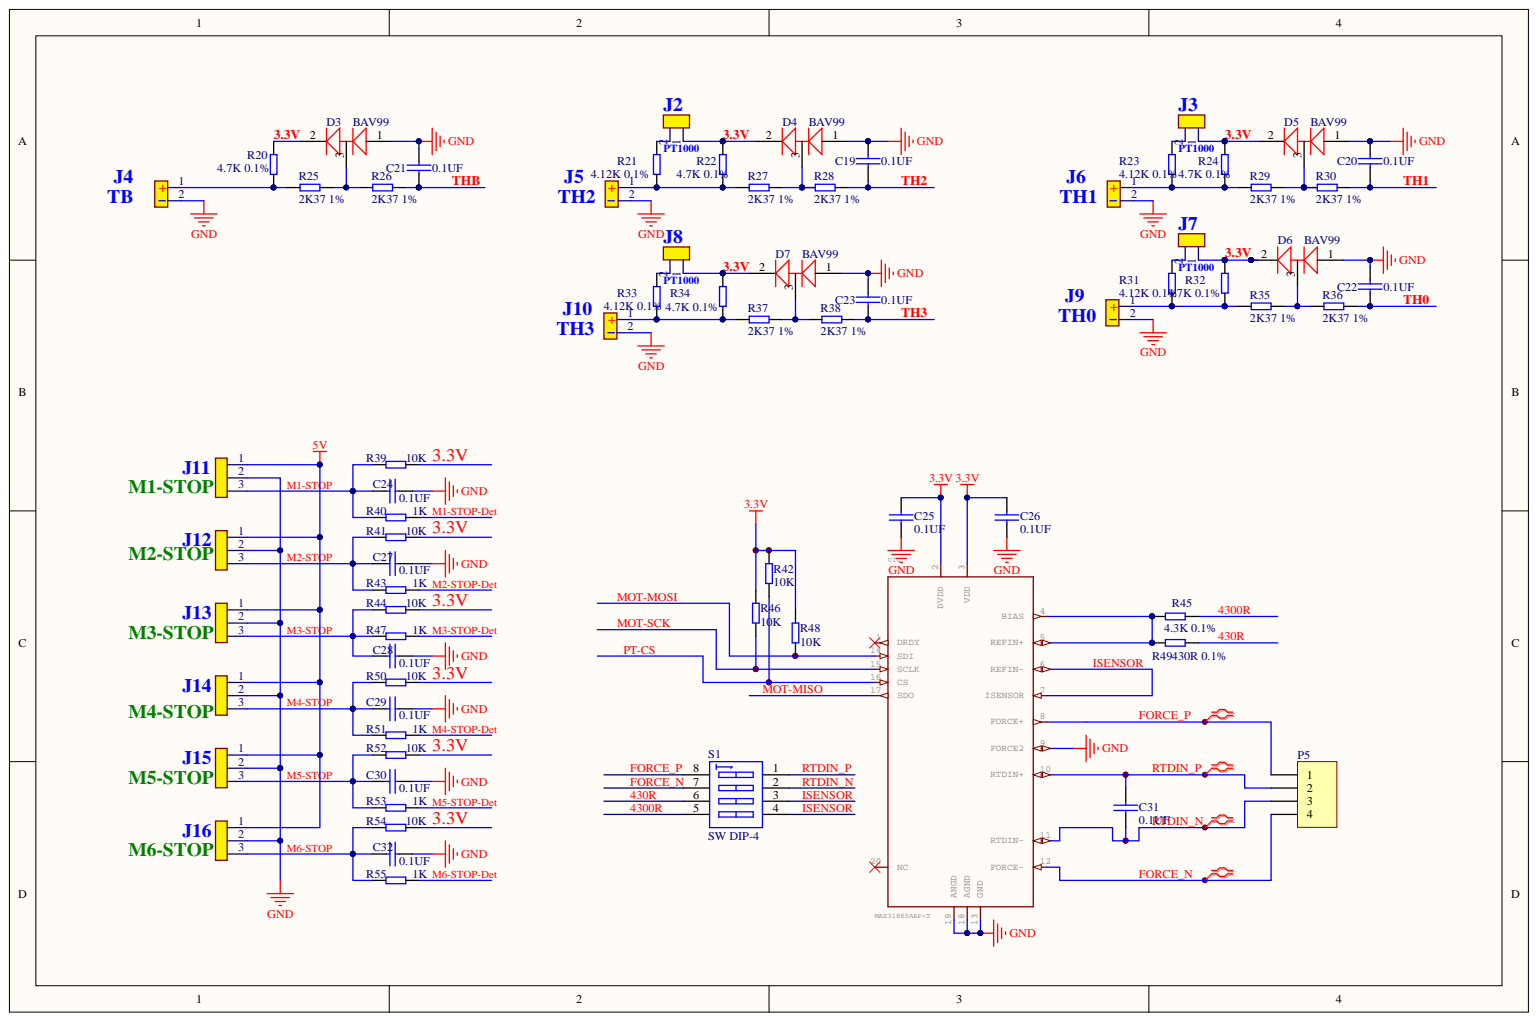
[picture p30: page 4]

2 | M2-STOP

2 | M3-STOP

SCLK 15
CS 16

2 | M5-STOP

RTDIN_P

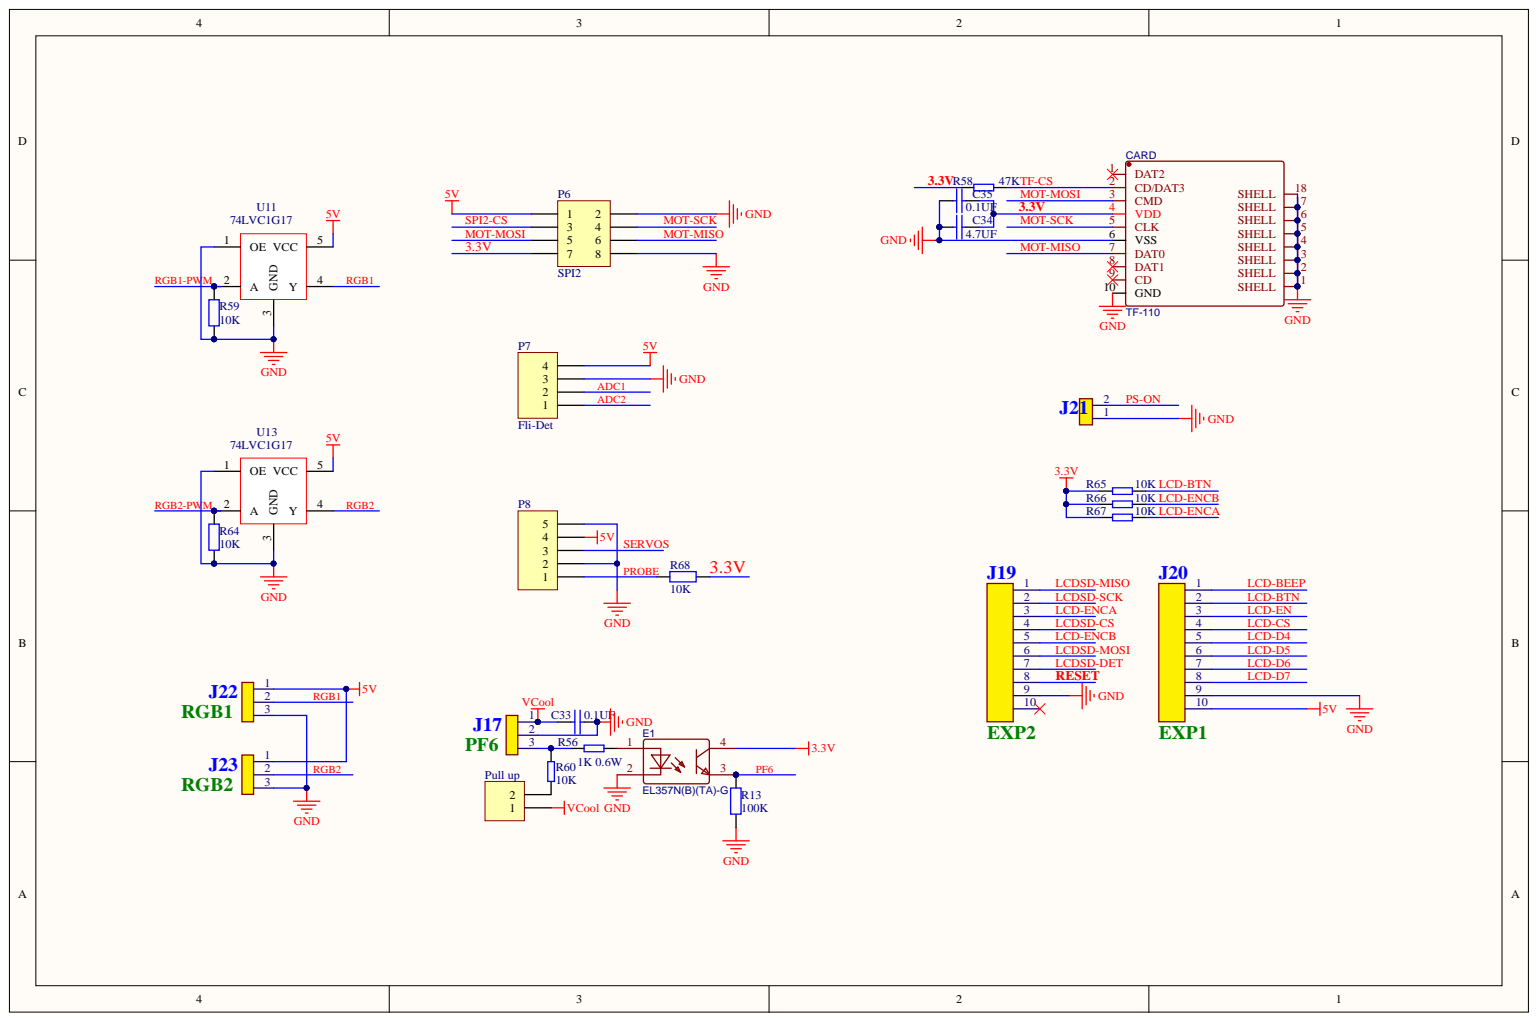
[picture p31: page 5]

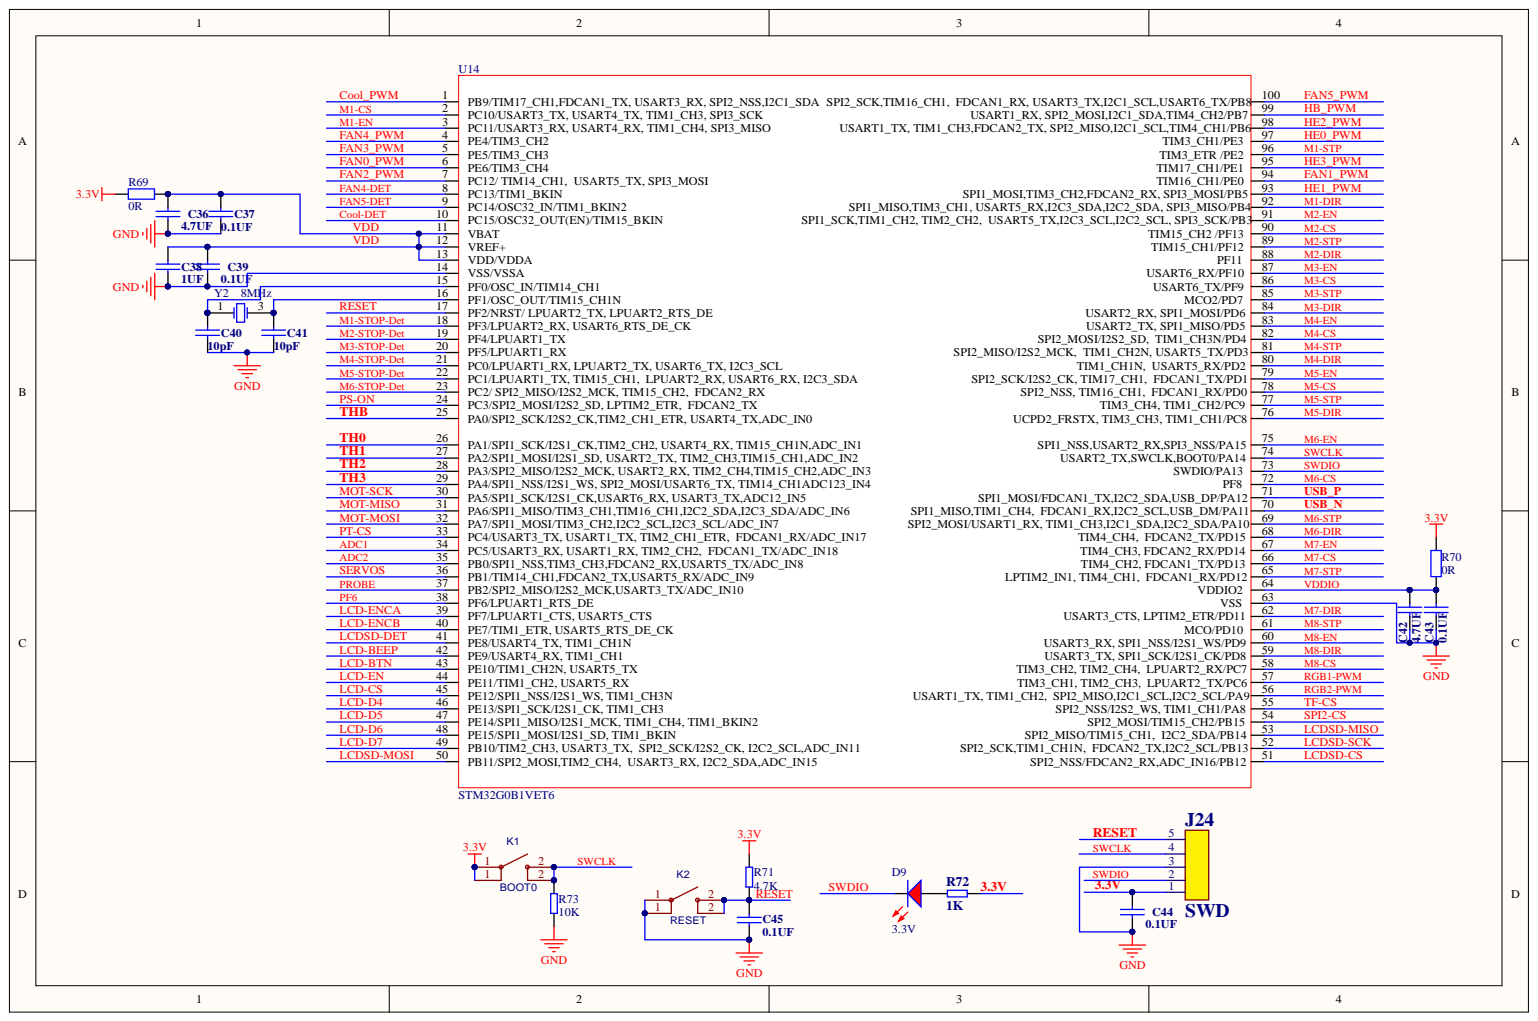
[picture p32: page 6]

1UF | 0.1UF | PF0/OSC_IN/TIM14_CH1 15
Y2 8MHz | PF1/OSC_OUT/TIM15_CH1N 16

RESET

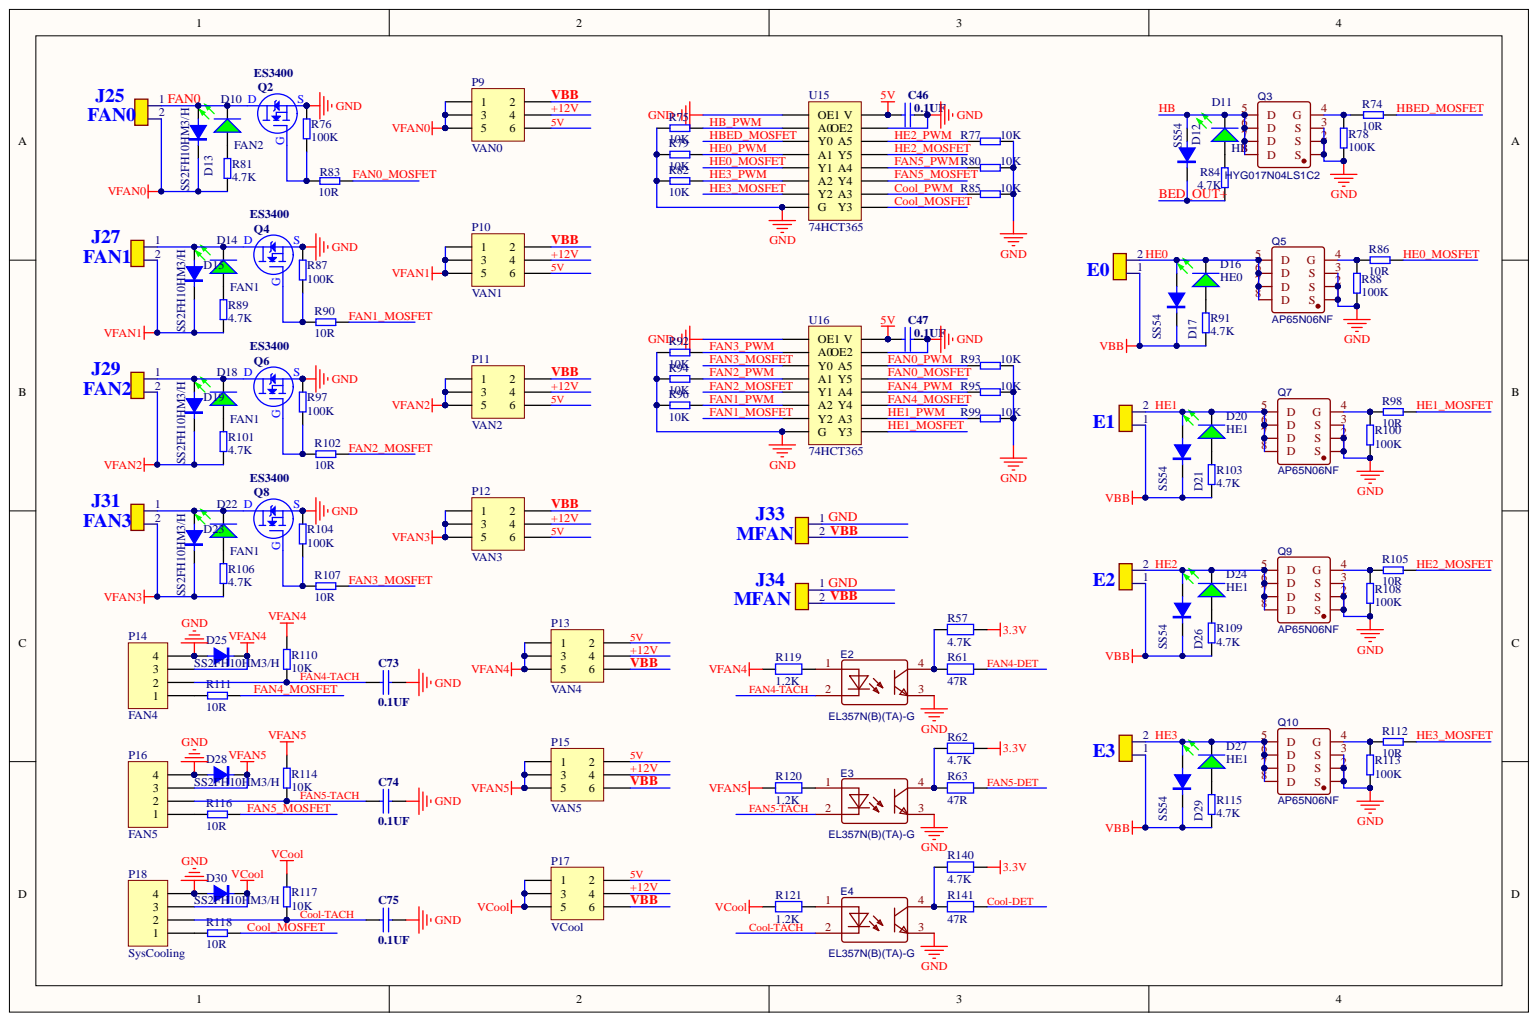
[picture p33: page 7]

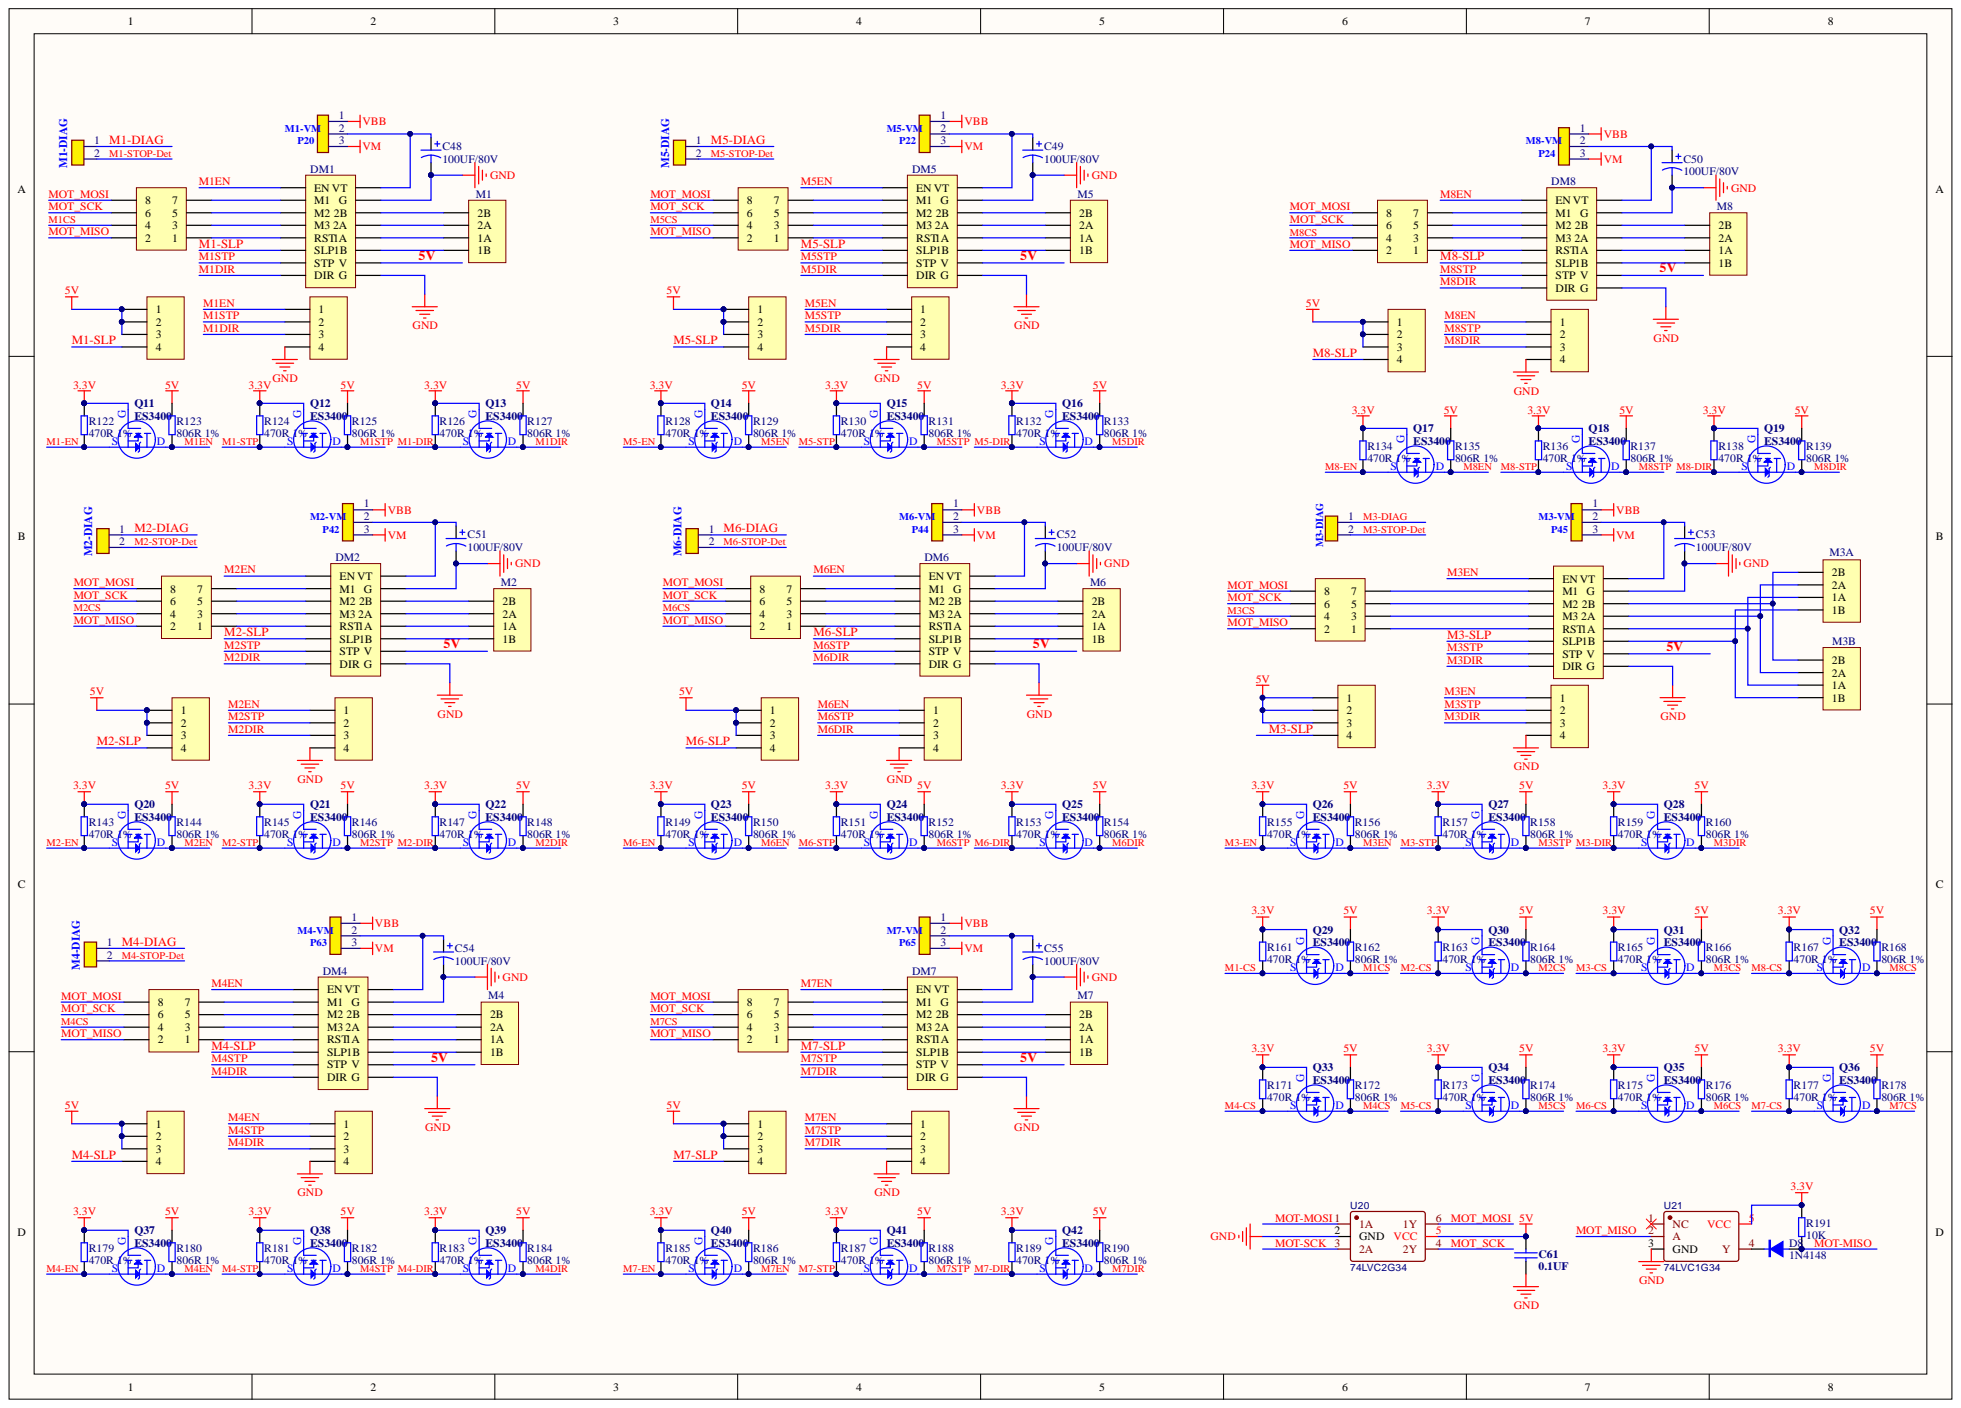
[picture p34: page 8]

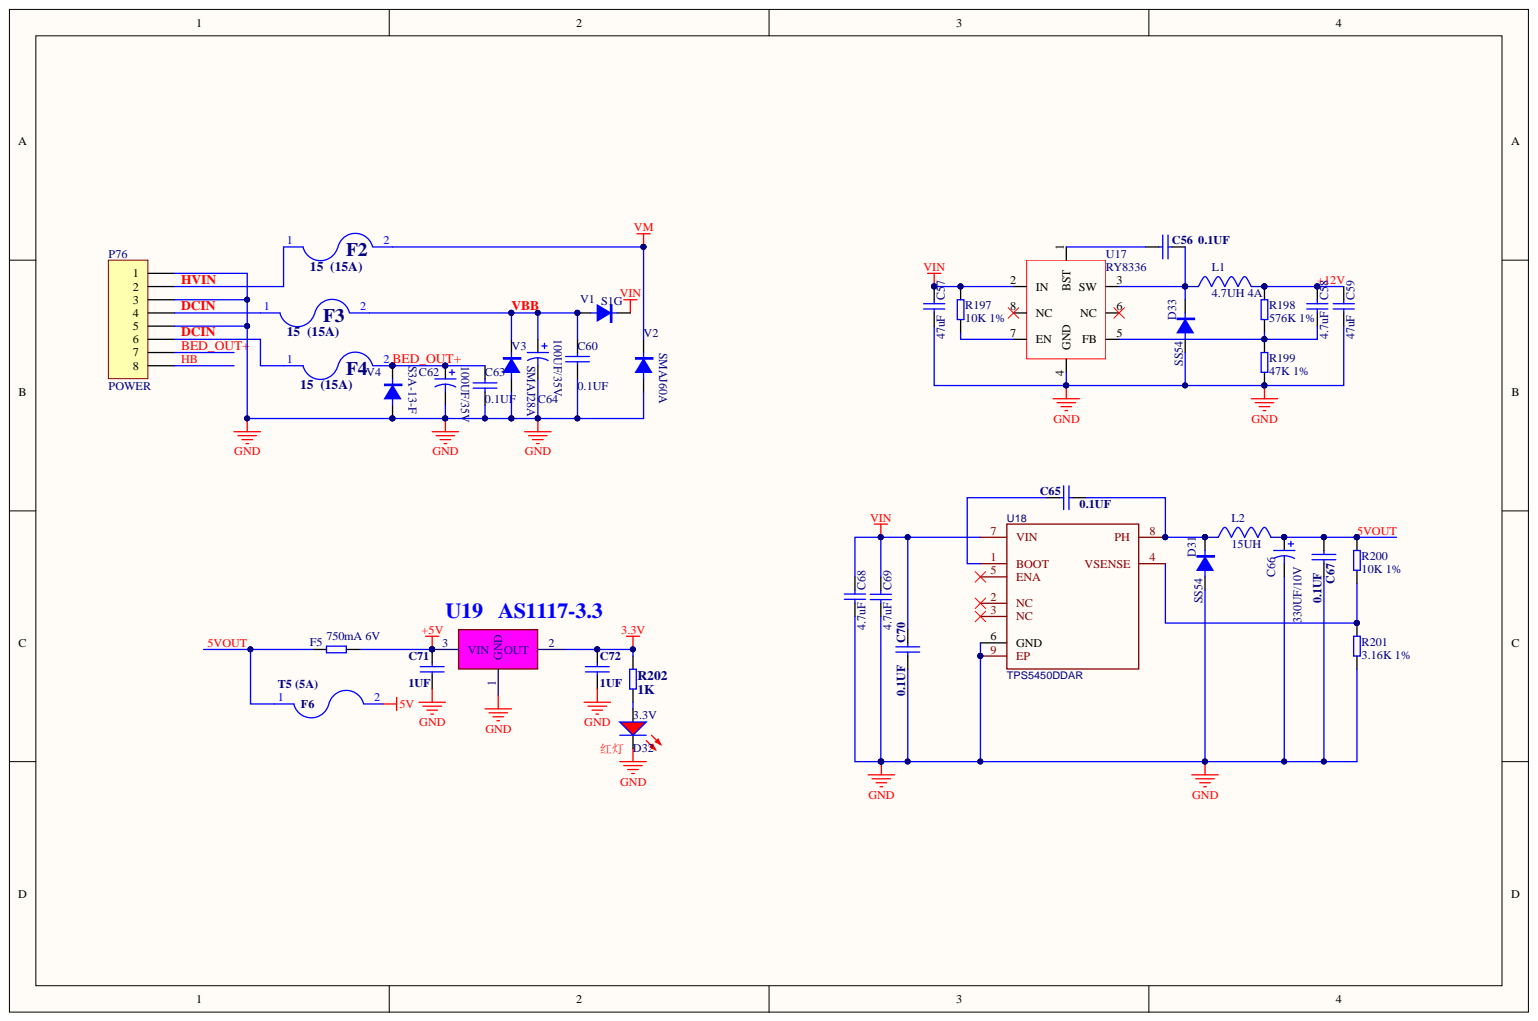
[picture p35: page 9]

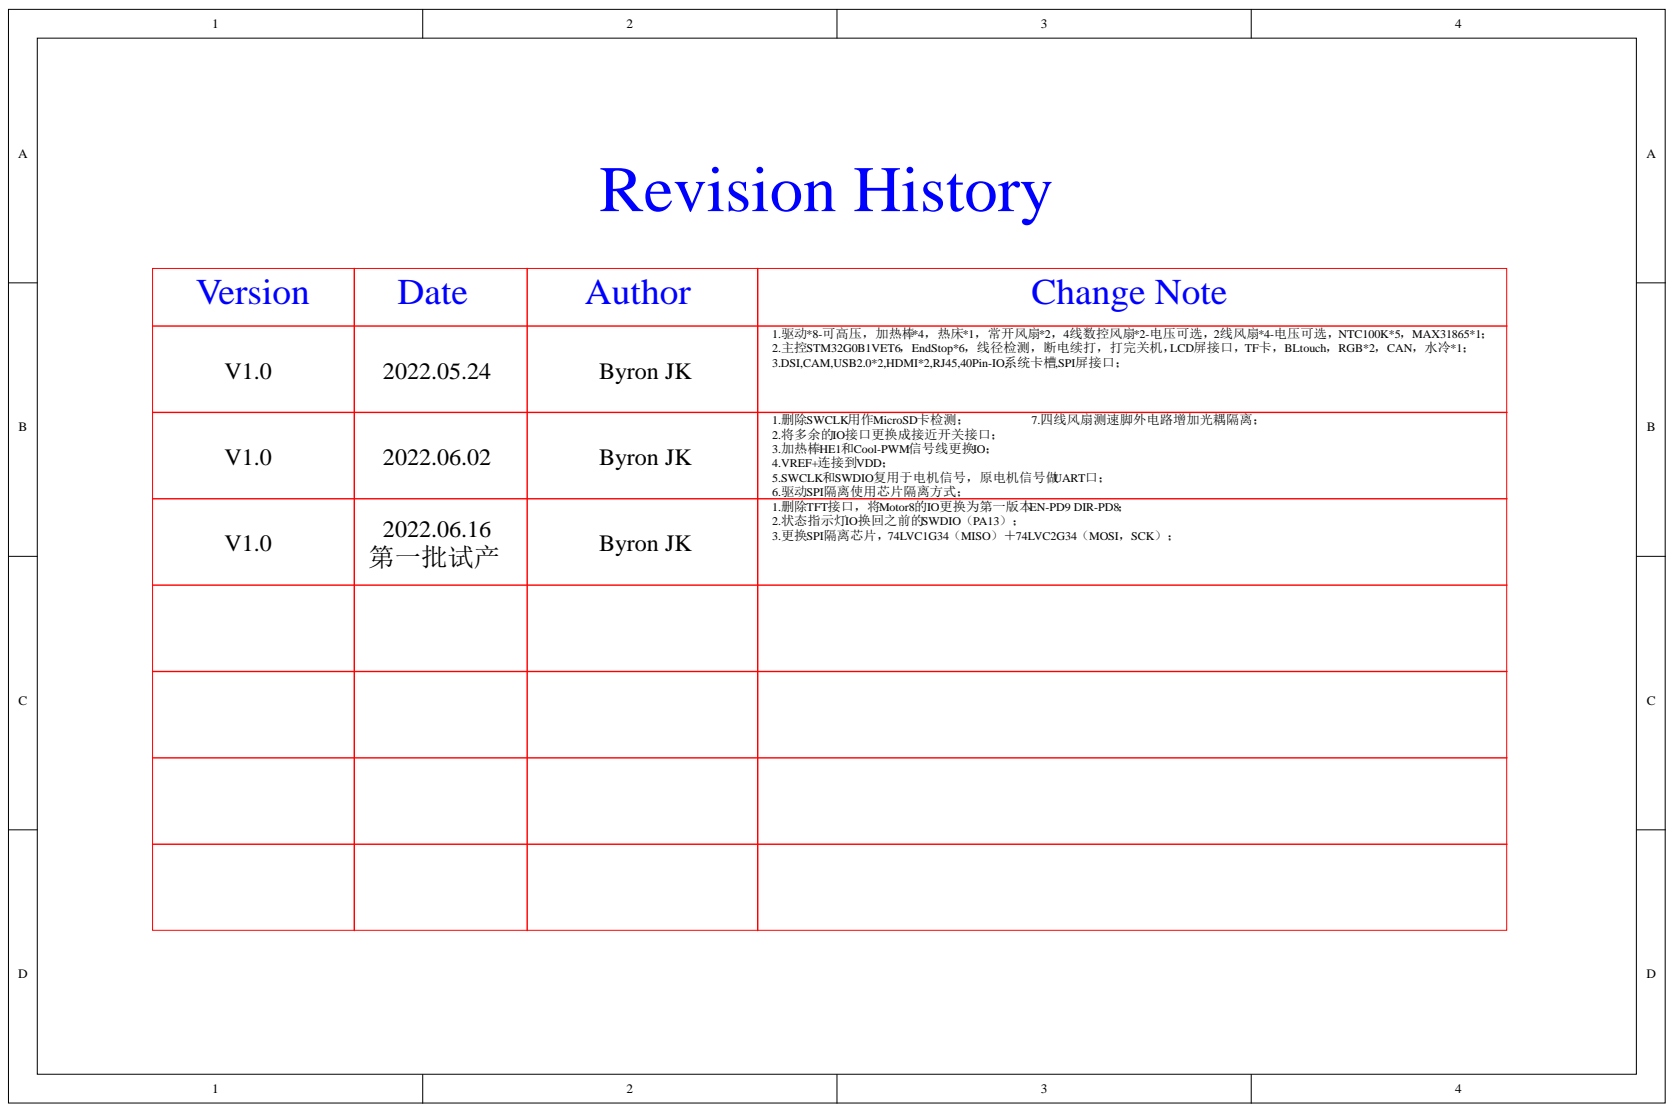
[picture p36: page 10]

Version | Date | Author | Change Note

V1.0 | 2022.05.24 | Byron JK | 1.驱动*8-可高压，加热棒*4，热床*1，常开风扇*2，4线数控风扇*2-电压可选，2线风扇*4-电压可选，NTC100K*5，MAX31865*1； 2.主控STM32G0B1VET6，EndStop*6，线径检测，断电续打，打完关机，LCD屏接口，TF卡，BLtouch，RGB*2，CAN，水冷*1； 3.DSI,CAM,USB2.0*2,HDMI*2,RJ45,40Pin-IO,系统卡槽,SPI屏接口；

V1.0 | 2022.06.02 | Byron JK | 1.删除SWCLK用作MicroSD卡检测； 7.四线风扇测速脚外电路增加光耦隔离； 2.将多余的IO接口更换成接近开关接口； 3.加热棒HE1和Cool-PWM信号线更换IO； 4.VREF+连接到VDD； 5.SWCLK和SWDIO复用于电机信号，原电机信号做UART口； 6.驱动SPI隔离使用芯片隔离方式；

V1.0 | 2022.06.16 第一批试产 | Byron JK | 1.删除TFT接口，将Motor8的IO更换为第一版本EN-PD9 DIR-PD8； 2.状态指示灯IO换回之前的SWDIO（PA13）； 3.更换SPI隔离芯片，74LVC1G34（MISO）＋74LVC2G34（MOSI，SCK）；
