bigtreetech/Manta-M8P/(commit log)

2022-07-11 fix wrong pin config
    [generic-bigtreetech-manta-m8p.cfg]
2022-07-11 add voron config
    [generic-bigtreetech-manta-m8p-voron2.cfg]
2022-07-22 add M8P_Voron2.4_Mounting bracket
    [DIN Clips.STL, M8P_Voron2.4_Mounting bracket.STEP, M8P_Voron2.4_Mounting bracket.STL]
2022-11-07 fix user manual for stepper driver power
2023-01-09 fix wrong ADXL345 cs pin
2023-04-01 Create generic-bigtreetech-manta-m8p-V1_1.cfg
    Updated pin assignments for version 1.1 of the Manta M8P board.
    [generic-bigtreetech-manta-m8p-V1_1.cfg]
2023-04-01 Update and rename generic-bigtreetech-manta-m8p.cfg to generic-bigtreetech-manta-m8p-V1_0.cfg
    Updated by adding Motor and Fan comments to aid new owners. Renamed to be disguised for the new V1_1 cfg file.
    [generic-bigtreetech-manta-m8p-V1_0.cfg]
2023-04-10 update m8p v1.1 .cfg
    [generic-bigtreetech-manta-m8p-v1.0-voron2.cfg, generic-bigtreetech-manta-m8p-v1.0.cfg, generic-bigtreetech-manta-m8p-v1.1.cfg]
2023-04-20 rename cfg
    [generic-bigtreetech-manta-m8p-v1.0.cfg, generic-bigtreetech-manta-m8p-v1.1.cfg, generic-bigtreetech-manta-m8p-v1_0-voron2.cfg]
2023-09-11 add m8p v2.0
    [BIGTREETECH MANTA M8P V1.0.step, DIN Clips.STL, M8P_Voron2.4_Mounting bracket.STEP, M8P_Voron2.4_Mounting bracket.STL, generic-bigtreetech-manta-m8p-V1_0.cfg, generic-bigtreetech-manta-m8p-V1_1.cfg, generic-bigtreetech-manta-m8p-V2_0.cfg, generic-bigtreetech-manta-m8p-v1_0-voron2.cfg]
2023-12-05 fix the wrong pin for Fan3
    [generic-bigtreetech-manta-m8p-V2_0.cfg]
2024-04-02 update wiring diagram for 4-wire fan and water cooling
2025-03-27 manual: Raspberry Pi 2023-10-10 and later systems, the configuration path changes from '/boot/' to '/boot/firmware'
